Abdo-Pasha/MCT333_Design_of_Mechatronics_Systems_1/CAD/pnumatic_components/Pneumatic_Air_Cylinder_Double_Action/Pneumatic Air Cylinder Double Action.60.png

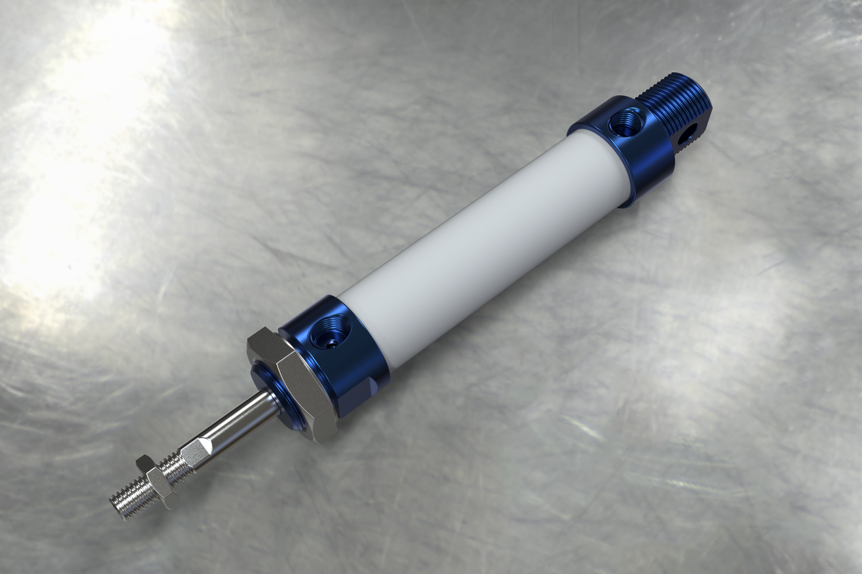
CAD/pnumatic_components/Pneumatic_Air_Cylinder_Double_Action/Pneumatic Air Cylinder Double Action.60.png
