Abdo-Pasha/MCT333_Design_of_Mechatronics_Systems_1/CAD/pnumatic_components/Pneumatic_Air_Cylinder_Double_Action/Read Me.txt

This 3D model shows a pneumatic cylinder of four different sizes.
The cylinder length can be customized by adjusting the stroke using equations in SolidWorks for the Cylinder Barrel and Piston Rod.
Detailed stroke lengths are available in the provided "Product Description" PDF.
