Abdo-Pasha/MCT333_Design_of_Mechatronics_Systems_1/CAD/motors_and_actuators/smakn-tb6600-stepper-motor-driver/Description.txt

SMAKN TB6600 Stepper Motor Driver

TB6600 Upgraded Version 32 Segments 4A 40V 57/86 Stepper Motor Driver

hhttps://www.aliexpress.us/item/3256805781393725.html

#CAD #SolidWorks #3dmodel #SMAKN #TB6600 #StepperMotorDriver
