Abdo-Pasha/MCT333_Design_of_Mechatronics_Systems_1/Actuator Sizing Reports/Suction Cup Actuator Sizing.pdf

# Suction Cup Actuator Sizing

The suction cup shown in the figure is used as an end effector for the cartesian robot. It is compatible with a Φ6 mm pneumatic tube and is utilized to lift the product's parts, which are made from Artelone and weigh approximately 32.52 grams (0.03252 kg).

## Suction Force Calculations (Fsuction)

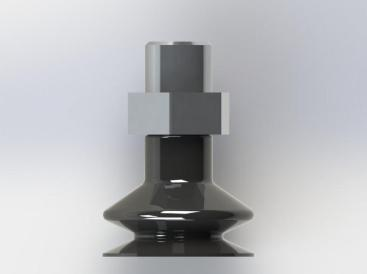
[picture p3: figure]

To calculate the required linear acceleration (a), we apply the motion relationship:

a =

L⋅θ̈

2π

and a = θ̈r

Given Parameters:

- Mass (m) = 32.52 g = 0.03252 kg
- Gravitational Acceleration (g) = 9.81 m/s²
- Weight (W = m ⋅ g) = 0.03252 kg × 9.81 m/s² = 0.31902 N
- Z-Axis Power Screw Lead (L) = 8 mm = 0.008 m
- Z-Axis Angular Acceleration (θ̈
z

) = 81.50 rad/s²

- Y-Axis Pulley’s Pitch Radius: r = 9.55 mm
- Y-Axis Angular Acceleration (θ̈

y) = 11.35 rad/s²

Linear Vertical Acceleration (az):

az =

0.008 m × 81.50 rad/s²
2π

=

0.652
2π

≈ 0.10377 m/s²

Vertical Acceleration Force (Faz
):

Faz = m ⋅ az = 0.03252 kg × 0.10377 m/s² ≈ 0.00337 N

Linear Horizontal Acceleration (ay):

ay = 11.35 rad/s² × 0.00955 m = 0.1084 m/s²

Horizontal Acceleration Force (Fay ):

Fay = m ⋅ ay = 0.03252 kg × 0.1084 m/s² ≈ 0.00353 N

### Case 1: Upward Movement

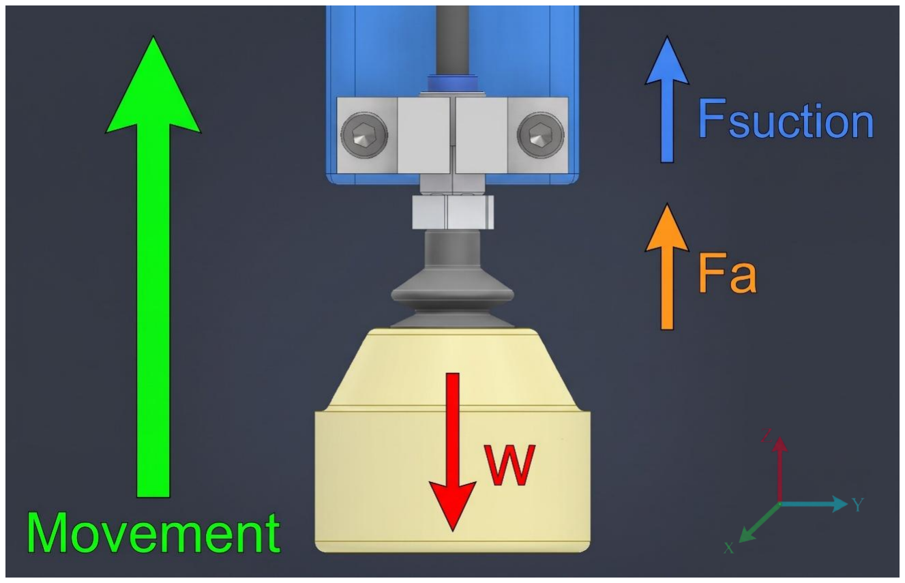
[picture p4: figure]

Equilibrium of Forces (ΣFy = 0):

Fsuction + Faz − W = 0

Moving terms to one side to establish the suction force requirement:

Fsuction > W − Faz

Calculation:

Fsuction > 0.31902 N + 0.00337 N

Fsuction > 0.31565 N

### Case 2: Downward Movement

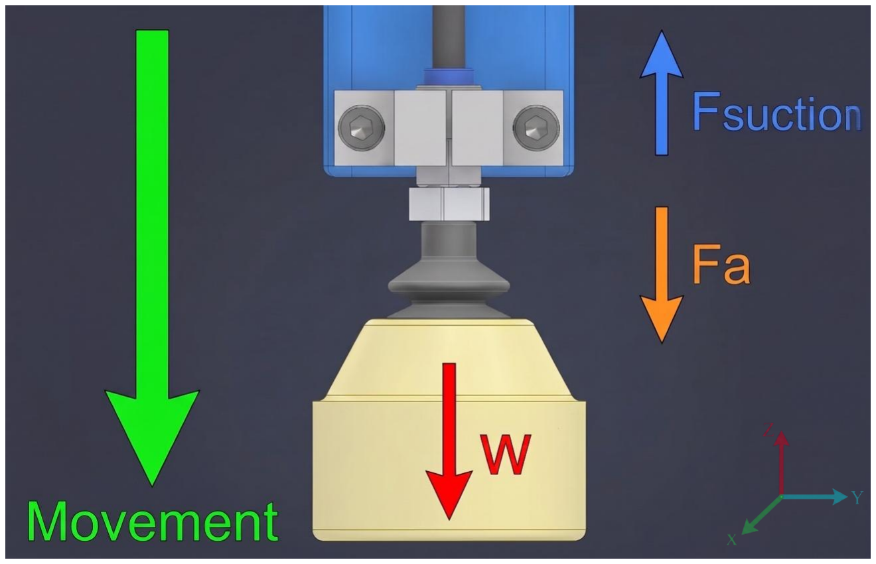
[picture p5: figure]

Equilibrium of Forces (ΣFz = 0):

Fsuction − Faz − W = 0

Moving terms to one side to establish the suction force requirement:

Fsuction > W + Faz

Calculation:

Fsuction > 0.31902 N + 0.00337 N

Fsuction > 0.32239 N

### Case 3: Sideway Movement

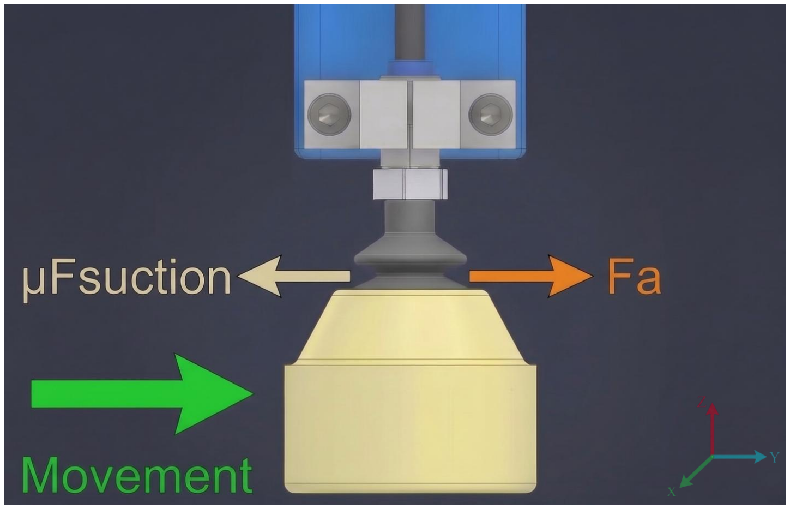
[picture p6: figure]

Equilibrium of Forces (ΣFy = 0):

Fay − μFsuction = 0

Moving terms to one side to establish the suction force requirement:

Fsuction >

Fay
μ

Calculation:

Fsuction >

0.00353
0.5

N

Fsuction > 0.00706 N

### Suction Force Sizing Criteria

To ensure secure part retention across all operational phases, the suction cup is sized based on the maximum calculated requirement, which occurs during downward movement (Case 2: Fsuction, min = 0.32239 N).

Applying a design safety factor of n = 2 to account for surface roughness, dynamic acceleration spikes and vacuum pressure fluctuations, the minimum required suction force is:

Fsuction, required = Fsuction, min × n = 0.32239 N × 2 = 0. 64478 N

### Pneumatic Vacuum System Sizing & Selection

1. Required Vacuum Pressure Calculation:
To achieve the required holding force (Fsuction = 0.645 N) using the suction tubing (Inner Diameter = 5 mm, cross-sectional area A = 19.64 mm²
), the required operating
vacuum pressure is calculated as:

Pvacuum =

Fsuction
A

=

0.64478 N
1.9635 × 10⁻⁵ m

2 = 32,838 Pa ≈ −0.328 bar (−32.84 kPa)

2. Vacuum Generator Selection & Verification:
To generate this vacuum pressure, a Vacuum Generator “VEV-06HS Venturi Vacuum Generator (1/8′′ Port)” is selected:
- Supply Pressure Range: 0.1 − 1.6 MPa (1.0 − 16.0 bar)
- Operating Supply Pressure: 5.0 − 8.0 bar (0.5 − 0.8 MPa)
- Max Vacuum Generated: −0.085 MPa (−0.85 bar)

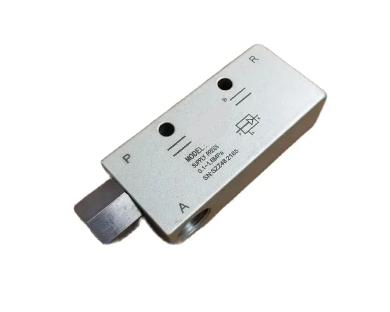
[picture p7: figure]

3. Verification & Safety Margin: Operating the compressed air line at 8.0 bar, the VEV-06HS generator easily delivers up to −0.85 bar of vacuum depth. Since the system only requires −0.328 bar, the generator operates with a 2.6 × pressure safety margin, guaranteeing rapid suction under different conditions.

Coefficient of Friction value reference: https://www.schmalz.com/en/support/know-how/vacuum-knowledge/the-vacuum-system-and-its-components/system-design-calculation-example/theoretical-holding-force-of-a-su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 (https://www.schmalz.com/en/support/know-how/vacuum-knowledge/the-vacuum-system-and-its-components/system-design-calculation-example/theoretical-holding-force-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)
