Abdo-Pasha/MCT333_Design_of_Mechatronics_Systems_1/Actuator Sizing Reports/Y-Axis Axtuator Sizing.pdf

# Y-Axis Actuator Sizing

The Y-axis of the Cartesian robotic arm is actuated by an encoder-equipped DC motor operating under closed-loop PID control, driving a timing belt and gantry cart mechanism. This setup translates the entire Z-axis assembly linearly along the Y-axis workspace, allowing the suction mechanism to reach and pick up target parts with high positional accuracy.

## Governing Formulas

### 1. Torque Equations

- Total Motor Torque:
Tm = Tr + Jeq ⋅ θ̈m
- Peak Required Motor Torque:

Tm,peak = max(Tm,acc, Tm,const, Tm,dec)

- RMS Torque (Trms):

Trms = √
Tm,acc
2 | ⋅ tacc + Tm,const
| 2
⋅ tconst +Tm,dec

2
⋅ tdec + Tm,dw

2
⋅ tdw
| tacc + tconst + tdec + tdw

### 2. Inertia Equations

- Load Rotary Inertia (Jload):

Jload =

mloadr

2
η
- Motor Rotary Inertia (Jmotor):
| Jmotor =

1
10 ⋅ Jload
- Equivalent System Inertia (Jeq):
| Jeq = Jload + Jmotor

### 3. Resisting Torque Equations

- Total Resisting Torque (Tr
):

Tr =

mloadr
η

### 4. Acceleration Equations

- Maximum Angular Velocity (ωmax):

vmax = ωmax ⋅ r

- Total Rotation, Area Under the Curve (θ):

θ =

1
2

taccωmax + ωmaxtconst +

1
2

tdecωmax

- Acceleration Phase (θ̈
acc):

θ̈
acc =

ωmax − 0

tacc

- Constant-Speed Phase (θ̈
const):

θ̈
const = 0
- Deceleration Phase (θ̈
dec):

θ̈
dec =

0 − ωmax

tdec

### 5. Additional Rules and Parameters

- Driver Pulley
- Number of Teeth T = 30
- Pitch P = 2 mm
- Pitch Radius (r):

r =

T × P
2π

=

30 × 2
2π

= 9.55 mm

To size the actuator correctly, the total mass moved along the Y-axis is determined first. Summing all translating parts in the Z-Axis Parts List gives a total mass of 1,363.87 g.

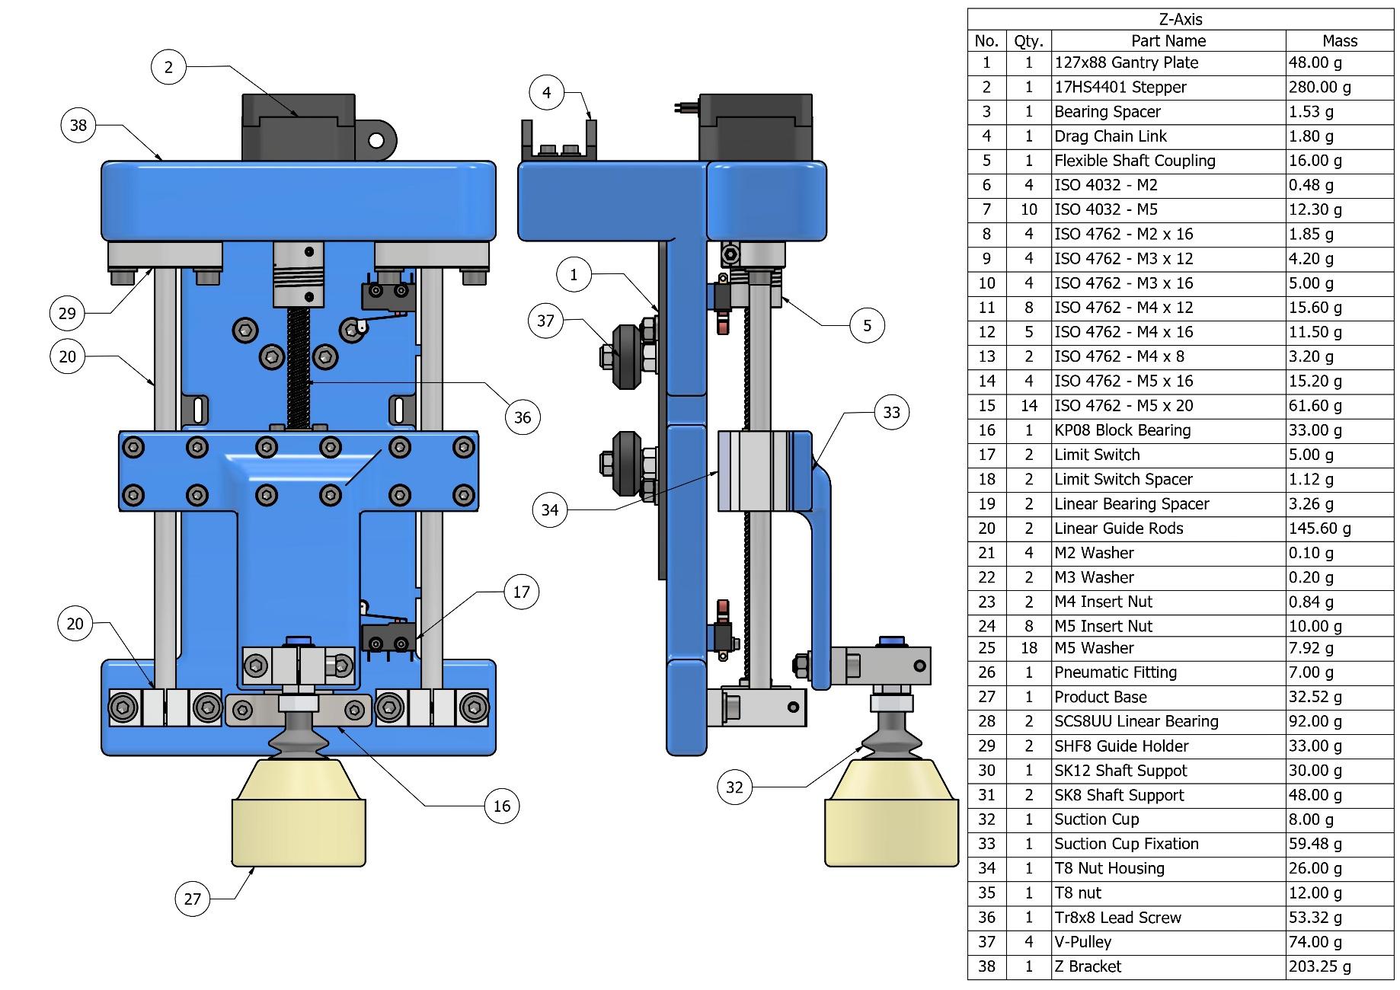
[picture p8: figure]

## 1. Inertia Calculation (Jeq)

Variables & Parameters:

- Load Mass: mload = 1,363.87 g = 1.36387 kg
- Mechanical Efficiency (assumed): η = 90% = 0.9
- Pitch Radius: r = 9.55 mm

Equations & Substitution:

- Load Rotary Inertia (Jload):

Jload =

mload ⋅ r

2
η

=

1.36387 ⋅ (0.00955)

2
0.9

= 1.3821 × 10⁻⁴ kg ⋅ m²

- Motor Inertia (Jmotor):

Jmotor =

1
10 ⋅ Jload = 0.1 × 1.3821 × 10⁻⁴ = 1.3821 × 10⁻⁵ kg ⋅ m²
- Equivalent System Inertia (Jeq):

Jeq = Jload + Jmotor = 1.3821 × 10⁻⁴ + 1.3821 × 10⁻⁵ = 1.5203 × 10⁻⁴ kg ⋅ m²

## 2. Resisting Torque Calculation (Tr

)

Variables & Parameters:

- Load Mass: mload = 1,363.87 g = 1.36387 kg
- Mechanical Efficiency (assumed): η = 90% = 0.9
- Pitch Radius: r = 9.55 mm

Torque Equations & Substitution:

- Total Resisting Torque (Tr ):

Tr =

mload ⋅ r
η

=

1.36387 ⋅ 0.00955
0.9

= 0.01447 N ⋅ m (14.47 mN ⋅ m)

## 3.Acceleration (θm

̈):

The stroke of the y axis is 310 mm and the desired maximum nut speed is 120 mm/s, so at constant speed the whole stroke would take about 2.58 s (310 ÷ 120). The acceleration and deceleration ramps of the velocity profile make the actual move a little longer, as calculated below.

Variables & Parameters:

- Stroke: S = 310 mm = 0.31 m
- Pitch Radius: r = 9.55 mm
- Maximum Linear Speed (desired): vmax = 120 mm/s = 0.120 m/s
- Phase Time Ratio (assumed, symmetric profile): tacc:tconst:tdec = 0.3: 0.4: 0.3 of the move time T
- Dwell Time (assumed): tdw = 0.2 s
- No gearbox ⟹ θm = θL

Equations & Substitution:

- Maximum Angular Velocity (ωmax):

ωmax =

vmax
r

=

0.120 m/s
0.00955 m

= 12.5654 rad/s ≈ 120.0 rpm

- Total Rotation for the 310 mm Stroke (θ):

θ =

S
r

=

0.310 m
0.00955 m

= 32.4607 rad ≈ 5.166 rev

- Phase Times, tacc:tconst:tdec = 0.3: 0.4: 0.3 of the total move time T:

θ =

1
2

(0.3T)ωmax + ωmax(0.4T) +

1
2

(0.3T)ωmax = 0.7 ⋅ ωmax ⋅ T

T =

θ
0.7 ⋅ ωmax

=

32.4607
0.7 ⋅ 12.5654 = 3.6903 s
- tacc = 0.3 × 3.6903 = 1. 1071 s
- tconst = 0.4 × 3.6903 = 1. 4761 s
- tdec = 0.3 × 3.6903 = 1. 1071 s
- Total Cycle Time (T + tdw) = 3.6903 + 0.2 = 3. 8903 s

- Acceleration Phase (θ̈
acc):

θ̈
acc =

ωmax − 0

tacc

=

12.5654
1.1071 = +11. 350 rad/s2

Constant-Speed Phase (θ̈
const):
θ̈
const = 0 rad/s²
- Deceleration Phase (θ̈
dec):

θ̈
dec =

0 − ωmax
tdec

= −11. 350 rad/s2

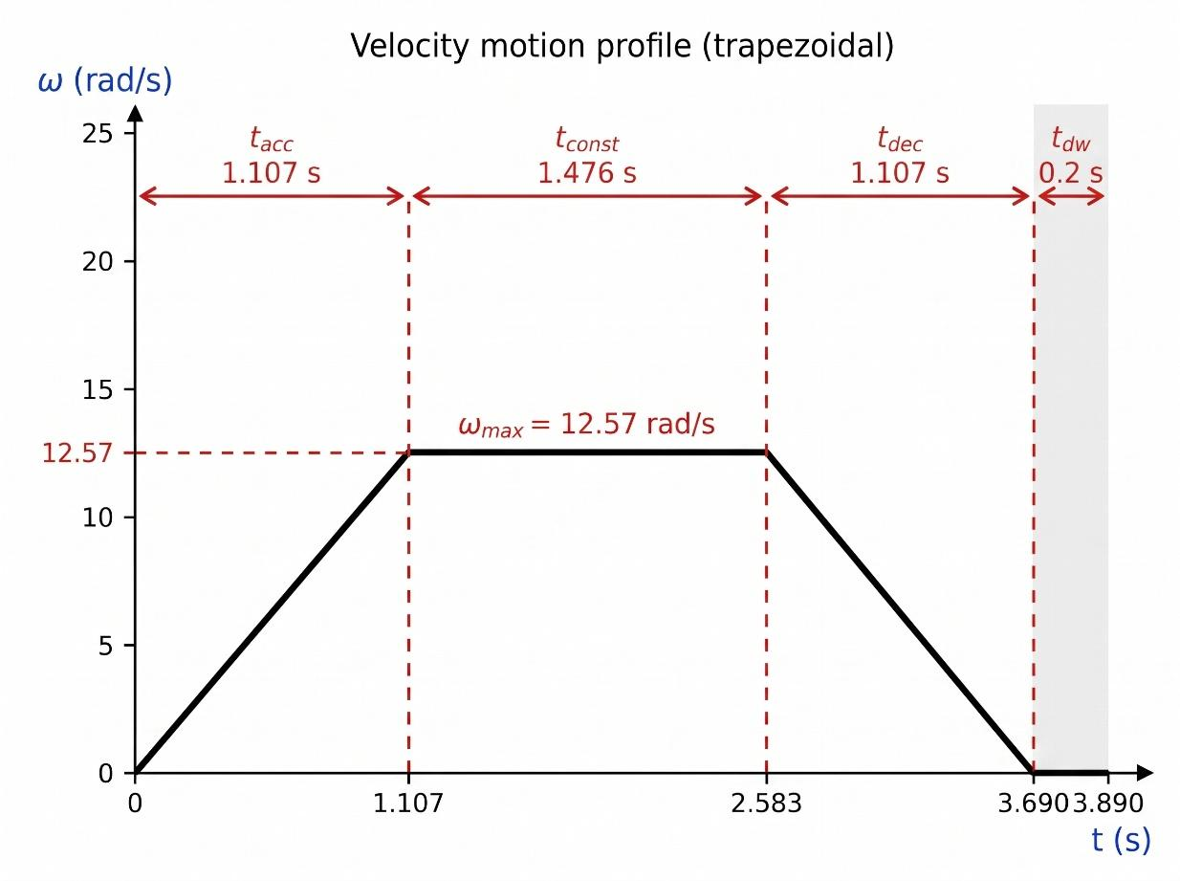
[picture p9: figure]

- Velocity Motion Profile (ω vs t):

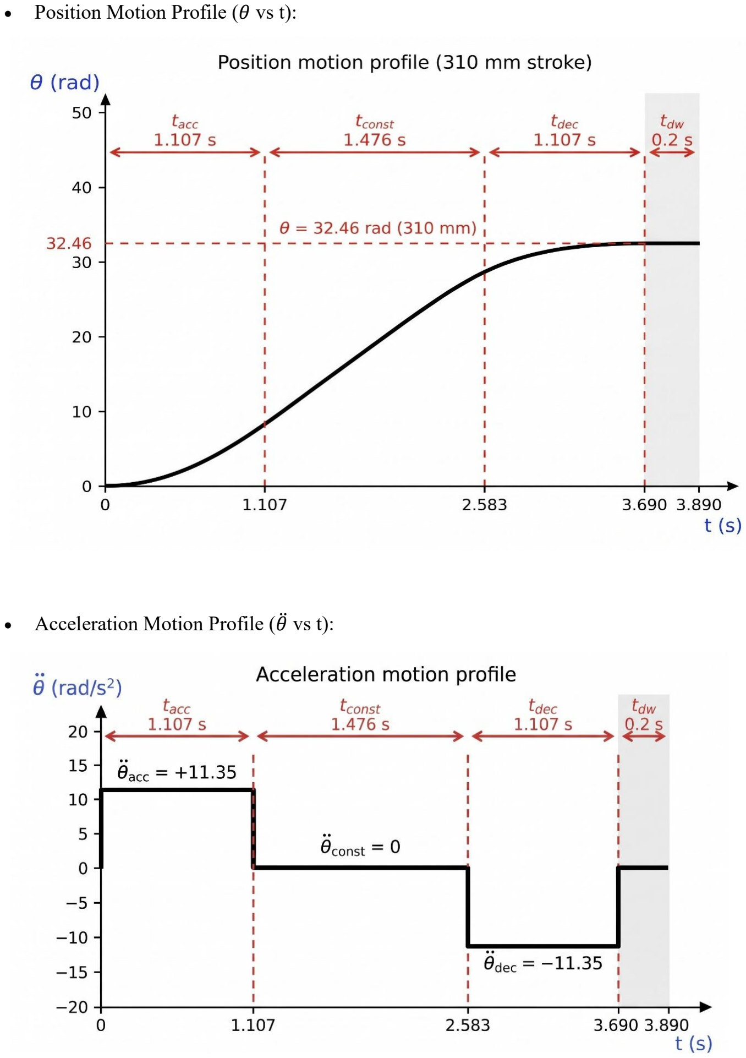
[picture p10: page 7]

- Position Motion Profile (θ vs t):
- Acceleration Motion Profile (θ̈vs t):

## 4. Motor Torque Calculations (Tm):

Variables & Parameters:

- Equivalent System Inertia: Jeq = 1.5203 × 10⁻⁴ kg ⋅ m²
- Total Resisting Torque: Tr = 0.01447 N ⋅ m
- Acceleration Phase Angular Acceleration: θ̈

acc = +11.350 rad/s²

- Constant-Speed Phase Angular Acceleration: θ̈

const = 0 rad/s²

- Deceleration Phase Angular Acceleration: θ̈

dec = −11.350 rad/s²

- Phase Times: tacc = 1.1071 s, tconst = 1.4761 s, tdec = 1.1071 s, tdw = 0.2 s

Torque Calculations & Substitution:

1. Acceleration Phase Motor Torque (Tm,acc):

Tm,acc = Tr + Jeq ⋅ θ̈
acc
Tm,acc = 0.01447 + (1.5203 × 10⁻⁴ ⋅ 11.350)

Tm,acc = 0.01447 + 0.001726 = 0.01620 N ⋅ m (16.20 mN ⋅ m)

2. Constant-Speed Phase Motor Torque (Tm,const):

Tm,const = Tr + Jeq ⋅ θ̈
const
Tm,const = 0.01447 + (1.5203 × 10⁻⁴
⋅ 0) = 0.01447 N ⋅ m (14.47 mN ⋅ m)
3. Deceleration Phase Motor Torque (Tm,dec):

Tm,dec = Tr + Jeq ⋅ θ̈
dec
Tm,dec = 0.01447 + (1.5203 × 10⁻⁴ ⋅ −11.350)

Tm,dec = 0.01447 − 0.001726 = 0.01274 N ⋅ m (12.74 mN ⋅ m)

4. Dwell Phase Motor Torque (Tm,dw):

Tm,dw = Tm,const=0.01447 N ⋅ m

Peak and RMS Torque Selection:

- Peak Motor Torque (Tm,peak):

Tm,peak = max(Tm,acc, Tm,const, Tm,dec)

Tm,peak = 0.01620 N ⋅ m (16.20 mN ⋅ m)

- Root Mean Square Torque (Trms):

Trms = √
Tm,acc

2 ⋅ tacc + Tm,const

2
⋅ tconst + Tm,dec

2
⋅ tdec + Tm,dw

2
⋅ tdw
tacc + tconst + tdec + tdw

Trms
= √
(0.01620)

2 ⋅ 1.1071 + (0.01447)

2 ⋅ 1.4761 + (0.01274)

2 ⋅ 1.1071 + (0.01447)

2 ⋅ 0.2
3.8903

Trms = √
0.0002905 + 0.0003091 + 0.0001797 + 0.00004188
3.8903 | = √
| 0.00082118
3.8903
= √0.00021108

Trms = 0.01453 N ⋅ m

## 5.Motor Selection & Verification with Safety Factor

- Safety Factor Application (n = 4):
Applying a design safety factor of n = 4 ensures extra margin for friction, damping and dynamic load spikes:

Treq, rms = Tm,rms × n = 0.01453 N ⋅ m × 4 = 0. 05812 N ⋅ m (0.5924 kg ⋅ cm)

- Selected DC Motor: GA25-370 DC Motor with Encoder 12V 250RPM

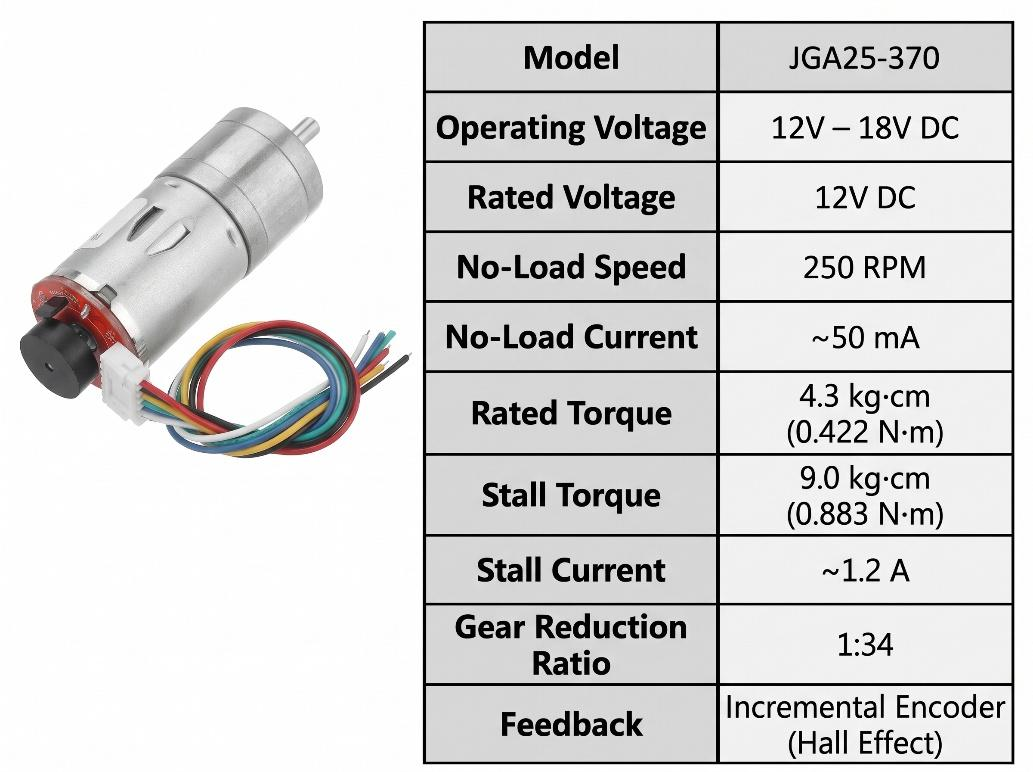
[picture p11: figure]

Suitability Justification: The selected JGA25-370 DC Motor easily handles the maximum dynamic load requirement during motion. Since the 20x20 Extrusion beam supports the full 1.36 kg weight, the motor only needs to overcome a small resisting torque of 0.0145 N ⋅ m.

In addition, the motor’s no-load speed is 250 RPM, while the maximum required speed is only 120 RPM, which leaves a comfortable speed margin (the motor runs at roughly 48% of its no-load speed). The motor is therefore suitable for this application.

Note: Even after updating the system inertia with the actual motor value, the recalculated peak required torque with a safety factor of n = 4 is only 0.0653 N ⋅ m (0.666 kg ⋅ cm). The motor's rated torque of 4.3 kg ⋅ cm (0.4217 N ⋅
m) is still nearly 6.5 × higher than this requirement, confirming that the JGA25-370 remains capable of driving the load with a safety margin.
