Abdo-Pasha/MCT333_Design_of_Mechatronics_Systems_1/Actuator Sizing Reports/Z-Axis Actuator Sizing Final.pdf

# Z-Axis Actuator Sizing

The Z axis of the Cartesian robotic arm is driven by a stepper motor and a power-screw (lead-screw) mechanism. It raises and lowers the suction cup so that it can reach and pick up the product parts easily.

The power screw is a Tr8x8 Acme (trapezoidal) screw, 173 mm long. In this designation the first 8 is the 8 mm outer diameter and the second 8 is the lead, L = 8 mm, since the thread has a pitch p = 2 mm with 4 starts (L = n × p = 4 × 2 mm). The lead L is used in the inertia, direct torque and lead-angle equations, while the pitch p is used only in the root diameter equation.

## Governing Formulas

### 1. Torque Equations

- Total Motor Torque:
Tm = Tr + Jeq ⋅ θ̈m
- Peak Required Motor Torque:

Tm,peak = max(Tm,acc, Tm,const, Tm,dec)

- RMS Torque (Trms):

Trms = √
Tm,acc
2 | ⋅ tacc + Tm,const
| 2
⋅ tconst +Tm,dec

2
⋅ tdec + Tm,dw

2
⋅ tdw
| tacc + tconst + tdec + tdw

### 2. Inertia Equations

- Load Rotary Inertia (Jload):

Jload =

mload

η ⋅ (

2π
L

)

2 +

1
2
- msc · r

2

- Motor Rotary Inertia (Jmotor):

Jmotor =

1
10 ⋅ Jload
- Equivalent System Inertia (Jeq):

Jeq = Jload + Jmotor

### 3. Resisting Torque Equations

- Total Resisting Torque (Tr
):

Tr =

Fload
η ⋅ (

2π
L

)

+ Tfriction

- Thread Friction Torque (Tfriction):

Tfriction = (

F ⋅ dm
2

) ⋅ (

tan(α)+ μ′
1− μ′ ⋅ tan(α)

)

- Friction Coefficient (μ′):

μ′ =

μ
cos(β)
- Screw Mean Diameter (dm), Root Diameter (droot) & Lead Angle (α):

dm =

douter + droot
2

+ 0.25

droot = douter − p −0.5

α = arctan (

L
π ⋅ dm

)

### 4. Acceleration Equations

- Maximum Angular Velocity (ωmax):

vmax = ωmax ⋅ (

L
2π

)

- Total Rotation, Area Under the Curve (θ):

θ =

1
2

taccωmax + ωmaxtconst +

1
2

tdecωmax

- Acceleration Phase (θ̈
acc):

θ̈
acc =

ωmax − 0

tacc

- Constant-Speed Phase (θ̈
const):

θ̈
const = 0
- Deceleration Phase (θ̈
dec):

θ̈
dec =

0 − ωmax

tdec

To size the actuator correctly, the total mass carried by the power screw is determined first. Summing all moving parts in the Z-axis bill of materials gives a total mass of 369.58 g.

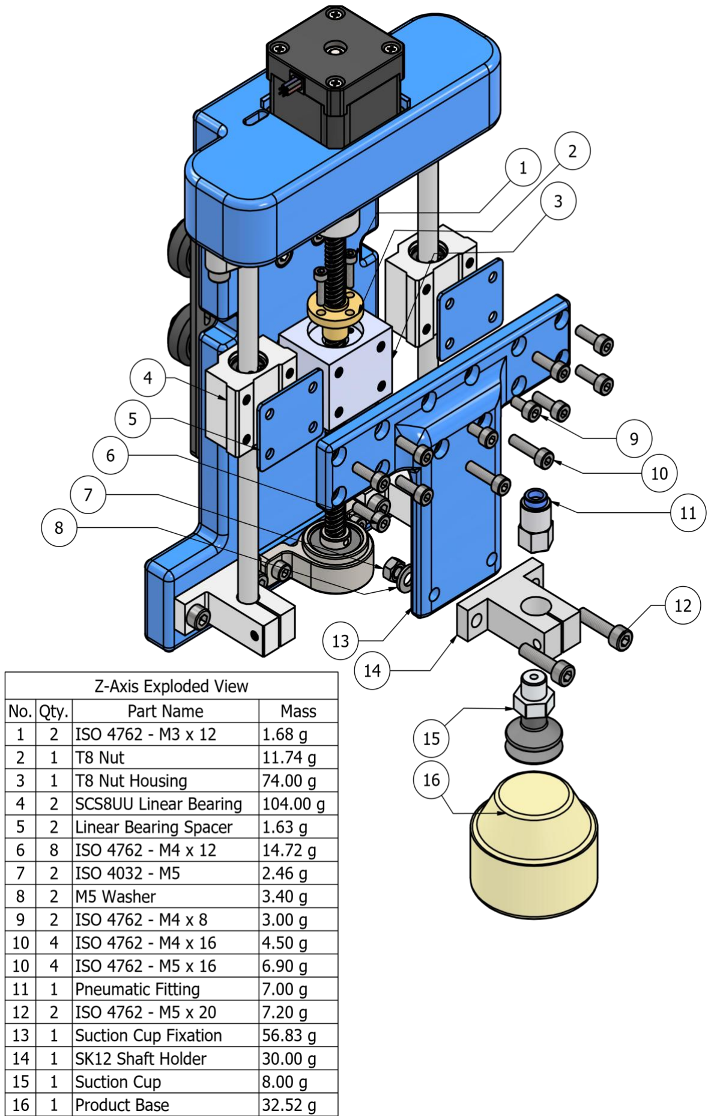
[picture p12: figure]

## 1. Inertia Calculation (Jeq)

Variables & Parameters:

- Load Mass: mload = 369.58 g = 0.36958 kg
- Mechanical Efficiency (assumed): η = 65% = 0.65
- Lead: L = 8 mm = 0.008 m
- Screw: Tr8x8, d = 8 mm ⟹ r = 0.004 m, ℓ = 0.173 m, ρ = 7850 kg/m³ (steel)

Equations & Substitution:

- Load Rotary Inertia (Jload):

Jload =

mload

η ⋅ (

2π
L

)

2

Jload =

0.36958 kg

0.65 ⋅ (

2π
0.008 m

)

2 =

0.36958
0.65 ⋅ (785.3982)

2 =

0.36958
400,952.68

Jload = 9.21755 × 10⁻⁷ kg ⋅ m²

- Lead Screw Inertia (Jscrew):

msc = ρ · π · r

2
- ℓ = 7850 · π · (0.004)

2
- 0.173 = 0.06826 kg

Jscrew =

1
2
- msc · r

2

Jscrew =

1
2
- 0.06826 kg · (0.004 m)

2 = 5.461 × 10⁻⁷ kg · m²

- Motor Inertia (Jmotor):

Jmotor =

1
10 ⋅ (Jload + Jscrew)

Jmotor =

1
10 ⋅ (9.21755 × 10⁻⁷ kg ⋅ m² + 5.461 × 10⁻⁷ kg ⋅ m²

) = 1.46786 × 10⁻⁷ kg ⋅ m²

- Equivalent System Inertia (Jeq):

Jeq = Jload + Jscrew + Jmotor

Jeq = 9.21755 × 10⁻⁷ kg ⋅ m² + 5.461 × 10⁻⁷ kg ⋅ m² + 1.46786 × 10⁻⁷ kg ⋅ m²

Jeq = 1.61464 × 10⁻⁶ kg ⋅ m²

## 2. Resisting Torque Calculation (Tr

)

Variables & Parameters:

- Gravitational Acceleration: g = 9.81 m/s²
- Vertical Load Force: Fload = W = mload ⋅ g = 0.36958 kg × 9.81 m/s² = 3.62558 N
- Outer Diameter: douter = 8 mm = 0.008 m
- Pitch: p = 2 mm = 0.002 m
- Lead: L = 8 mm = 0.008 m
- Thread Angle: β = 15∘
- Friction Coefficient (Brass Nut on Steel Screw): μ = 0.2
- Mechanical Efficiency (assumed): η = 0.65

Intermediate Geometry & Friction Calculations:

- Modified Friction Coefficient (μ′):

μ′ =

μ
cos(β)

=

0.2
cos(15∘)

=

0.2
0.96593 = 0.20706
- Root Diameter (droot):

droot = douter − p − 0.5 = 8 mm − 2 mm − 0.5 mm = 5.50 mm = 0.0055 m

- Mean Diameter (dm / dmean):

dm =

douter + droot
2

+ 0.25 =

8 + 5.50
2

+ 0.25 = 6.75 + 0.25 = 7.00 mm = 0.0070 m

- Lead Angle (α):

α = arctan (

L
π ⋅ dm

) = arctan (

0.008 m
π ⋅ 0.007 m

) = arctan(0.36378) = 19.9905∘

tan(α) = 0.36378

Torque Equations & Substitution:

- Thread Friction Torque (Tfriction):

Tfriction = (

F ⋅ dm
2

) ⋅ (
tan(α) + μ′
1 − μ′ ⋅ tan(α)

)

Tfriction = (

3.62558 N ⋅ 0.0070 m
2

) ⋅ (

0.36378 + 0.20706
1 − 0.20706 ⋅ 0.36378)

Tfriction = 0.0078337 N ⋅ m

- Direct Load Lifting Torque (Tdirect):

Tdirect =

Fload
η ⋅ (

2π
L

)

=

Fload ⋅ L
2π ⋅ η

Tdirect =

3.62558 N ⋅ 0.008 m
2π ⋅ 0.65 = 0.0071019 N ⋅ m
- Total Resisting Torque (Tr ):

Tr = Tdirect + Tfriction

Tr = 0.0071019 N ⋅ m + 0.0078337 N ⋅ m = 0.0149356 N ⋅ m

## 3.Acceleration (θm

̈):

The stroke of the Z axis is 95 mm and the desired maximum nut speed is 65 mm/s, so at constant speed the whole stroke would take about 1.46 s (95 ÷ 65). The acceleration and deceleration ramps of the velocity profile make the actual move a little longer, as calculated below.

Variables & Parameters:

- Stroke (Worst Case): S = 95 mm = 0.095 m
- Lead: L = n × p = 4 × 2 mm = 8 mm = 0.008 m
- Maximum Linear Speed (desired): vmax = 65 mm/s = 0.065 m/s
- Phase Time Ratio (assumed, symmetric profile): tacc:tconst:tdec = 0.3: 0.4: 0.3 of the move time T
- Dwell Time (assumed): tdw = 0.2 s
- No gearbox ⟹ θm = θL

Equations & Substitution:

- Maximum Angular Velocity (ωmax):

ωmax =

vmax
(

L
2π

)

ωmax =

0.065 m/s
(

0.008 m
2π

)

=

0.065
0.0012732 = 51.0509 rad/s ≈ 487.5 rpm
- Total Rotation for the 95 mm Stroke (θ):

θ =

S
(

L
2π

)

=

0.095 m
(

0.008 m
2π

)

=

0.095
0.0012732 = 74.6128 rad ≈ 11.875 rev

- Phase Times, tacc:tconst:tdec = 0.3: 0.4: 0.3 of the total move time T:

θ =

1
2

(0.3T)ωmax + ωmax(0.4T) +

1
2

(0.3T)ωmax = 0.7 ⋅ ωmax ⋅ T

T =

θ
0.7 ⋅ ωmax

=

74.6128
0.7 ⋅ 51.0509 =

74.6128
35.7356 = 2.0879 s

tacc = 0.3 ⋅ T = 0.3 ⋅ 2.0879 = 0.6264 s

tconst = 0.4 ⋅ T = 0.4 ⋅ 2.0879 = 0.8352 s

tdec = 0.3 ⋅ T = 0.3 ⋅ 2.0879 = 0.6264 s

Cycle time = T + tdw = 2.0879 + 0.2 = 2.2879 s

- Acceleration Phase (θ̈
acc):

θ̈
acc =

ωmax − 0

tacc

=

51.0509 − 0
0.6264 = 81.50 rad/s²
- Constant-Speed Phase (θ̈
const):
θ̈
const = 0 rad/s²
- Deceleration Phase (θ̈
dec):

θ̈
dec =

0 − ωmax
tdec

=

0 − 51.0509
0.6264 = −81.50 rad/s²

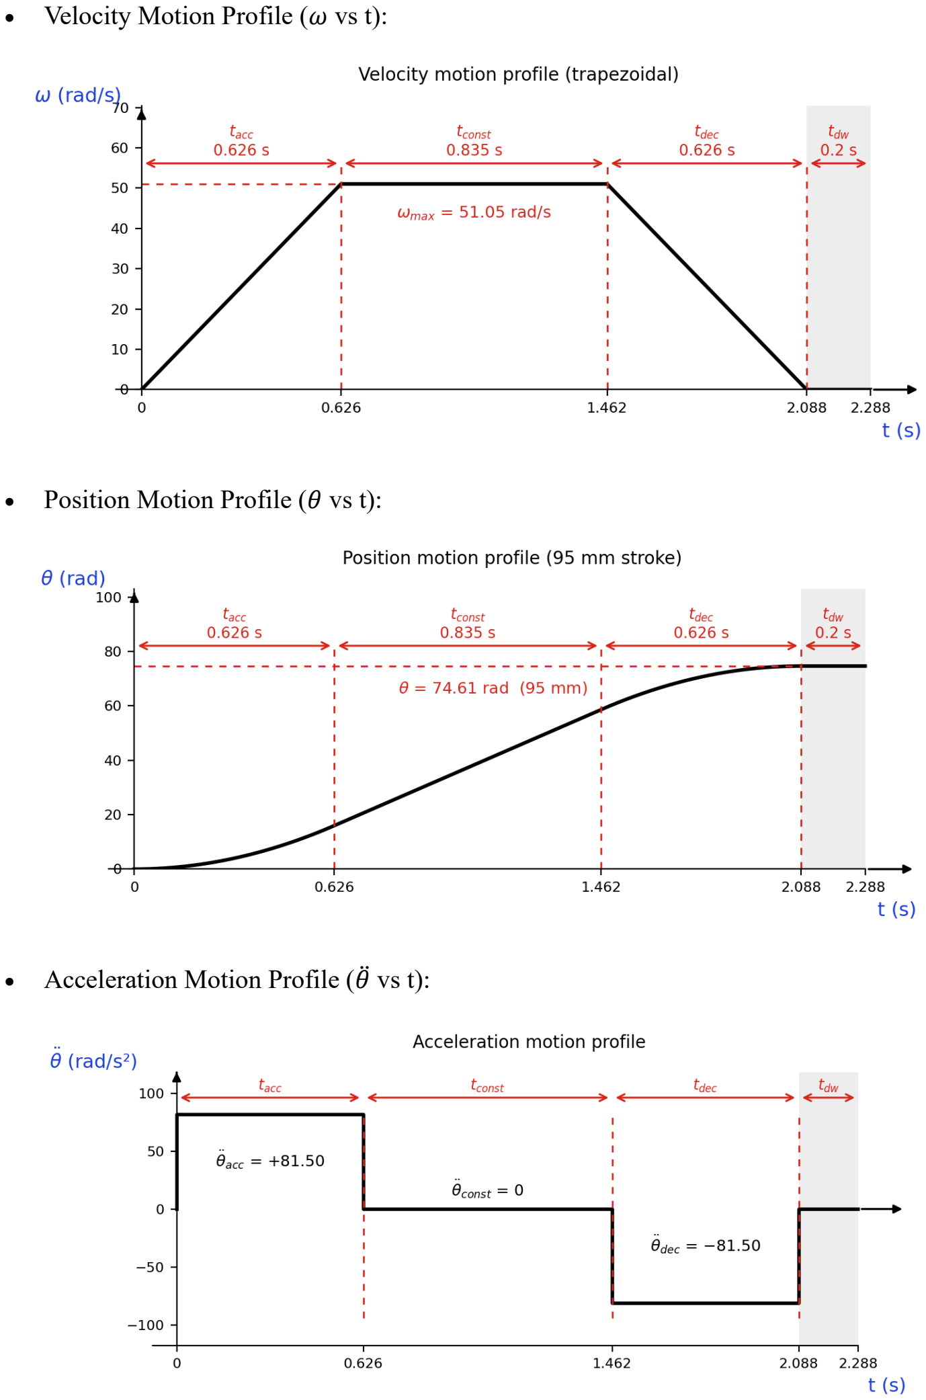
[picture p13: page 8]

- Velocity Motion Profile (ω vs t):
- Position Motion Profile (θ vs t):
- Acceleration Motion Profile (θ̈vs t):

## 4. Motor Torque Calculations (Tm)

Variables & Parameters:

- Equivalent System Inertia: Jeq = 1.61464 × 10⁻⁶ kg ⋅ m²
- Total Resisting Torque: Tr = 0.0149356 N ⋅ m
- Acceleration Phase Angular Acceleration: θ̈

acc = +81.50 rad/s²

- Constant-Speed Phase Angular Acceleration: θ̈

const = 0 rad/s²

- Deceleration Phase Angular Acceleration: θ̈

dec = −81.50 rad/s²

Torque Calculations & Substitution:

1. Acceleration Phase Motor Torque (Tm,acc):

Tm,acc = Tr + Jeq ⋅ θ̈
acc
Tm,acc = 0.0149356 N ⋅ m + (1.61464 × 10⁻⁶ kg ⋅ m² × 81.50 rad/s²
)

Tm,acc = 0.0149356 + 0.00013159 = 0.0150672 N ⋅ m

2. Constant-Speed Phase Motor Torque (Tm,const):

Tm,const = Tr + Jeq ⋅ θ̈
const
Tm,const = 0.0149356 N ⋅ m + (1.61464 × 10⁻⁶ kg ⋅ m² × 0 rad/s² ) = 0.0149356 N ⋅ m
3. Deceleration Phase Motor Torque (Tm,dec):

Tm,dec = Tr + Jeq ⋅ θ̈
dec
Tm,dec = 0.0149356 N ⋅ m + (1.61464 × 10⁻⁶ kg ⋅ m² × (−81.50 rad/s²

))

Tm,dec = 0.0149356 − 0.00013159 = 0.0148040 N ⋅ m

4. Dwell Phase Motor Torque (Tm,dw):

Tm,dw = Tm,const = 0.0149356 N ⋅ m

Peak and RMS Torque Selection:

- Peak Motor Torque (Tm,peak):

Tm,peak = max(Tm,acc, Tm,const, Tm,dec)

Tm,peak = max(0.0150672,0.0149356,0.0148040) = 0.0150672 N ⋅ m

- Root Mean Square Torque (Trms):

Trms = √
Tm,acc

2 ⋅ tacc + Tm,const

2
⋅ tconst + Tm,dec

2
⋅ tdec + Tm,dw

2
⋅ tdw

tacc + tconst + tdec + tdw

Trms
= √
(0.0150672)

2 ⋅ 0.6264 + (0.0149356)

2 ⋅ 0.8352 + (0.0148040)

2 ⋅ 0.6264 + (0.0149356)

2 ⋅ 0.20
2.288

Trms = √
0.00014220 + 0.00018631 + 0.00013728 + 0.00004461
2.288 | = 0.0149358 N ⋅ m

## 5. Motor Selection & Verification with Safety Factor:

- Safety Factor Application (n = 4):

Design RMS Torque (Treq,rms) = n ⋅ Tm,rms = 4 × 0.0149358 N ⋅ m
= 0.0597432 N ⋅ m (5.97 N ⋅ cm)
- Selected Stepper Motor: NEMA 17 (17HS4401)

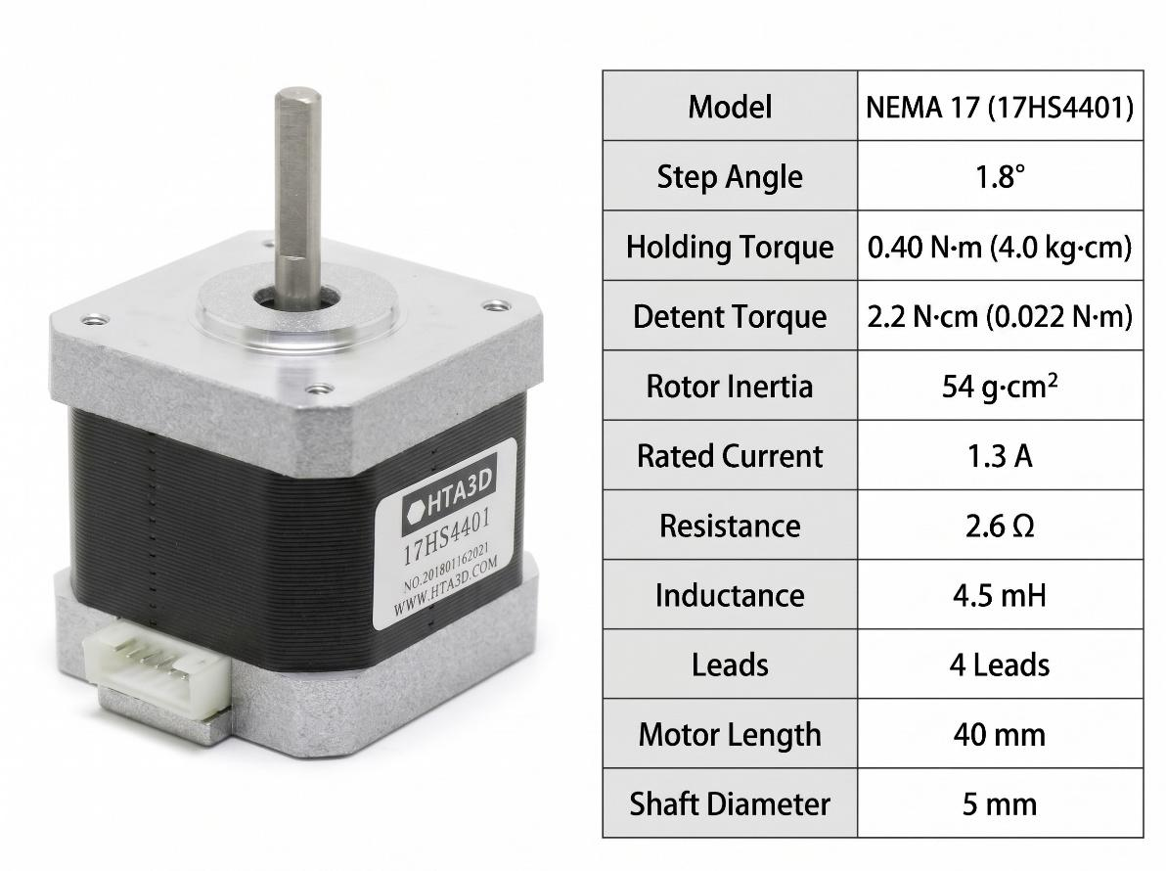
[picture p14: figure]

Suitability Justification: The selected NEMA 17 17HS4401 motor can easily handle the maximum dynamic load requirement during motion (5.97 N ⋅ cm RMS torque requirement). Furthermore, its unpowered detent torque of 2.20 N ⋅ cm exceeds the continuous static gravity load (1.49 N ⋅ cm), ensuring that the lead-screw nut will not slip or back-drive when the robot is powered off.

In addition, the selected motor can reach the required maximum speed of 51 rad/s (≈486 RPM), which corresponds to about 1,620 full steps/s for a 200 steps/rev motor. At this speed the motor’s pull-out torque stays above the 5.97 N·cm RMS requirement, with the driver supplied at 12 V.

Note: Even after updating the system inertia with the actual datasheet value of the motor (5.40 × 10⁻⁶ kg ⋅ m²
), the
recalculated peak torque with safety factor increases only slightly to 6.20 N ⋅ cm. The motor's rated holding torque of 40 N ⋅ cm is still nearly 6.5 × higher than this new requirement, confirming that the NEMA 17HS4401 remains capable of driving the required load with a safety margin.

Reference for the sizing equations: Industrial Monitor Direct, “Sizing Lead Screws and Ball Screws for Linear Actuation”. https://industrialmonitordirect.com/blogs/knowledgebase/sizing-lead-screws-and-ball-screws-for-linear-actuation (https://industrialmonitordirect.com/blogs/knowledgebase/sizing-lead-screws-and-ball-screws-for-linear-actuation)

Reference for the speed equations: Firgelli Automations, “Screw Lead, RPM, and Travel Calculator”. https://www.firgelliauto.com/blogs/engineering-calculators/screw-lead-rpm-and-travel-calculator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 (https://www.firgelliauto.com/blogs/engineering-calculators/screw-lead-rpm-and-travel-calculator%23related-resources)
