Abdo-Pasha/MCT333_Design_of_Mechatronics_Systems_1/CAD/DESIGN1_CAD_parameters.xlsx

Product_dia | 50 | mm
ProductBaseHeight | 40 | mm
ProductLedHeight | 20 | mm
GridProcutClearance | 3 | mm
GridBorderThickness | 5 | mm
GridBorderFillets | 7 | mm
GridTotalSize | 63 | mm
GridRobotClearance | 50 | mm
AluminiumExtrusionBase | 20 | mm
AluminiumExtrusionClearance | 30 | mm
BaseTotalWidth | 652 | mm
FeedingAreaLength | 400 | mm
BaseTotalLength | 912 | mm
DistanceBetweenGrid | 5 | mm
WorkspaceLength | 552 | mm
WorkspaceWidth | 417 | mm
WorkspaceHeight | 136.5 | mm
AxesBaseFillet | 15 | mm
Zaxis | 223 | mm
ProductTotalHeight | 45 | mm
VerticalClearance | 10 | mm
VerticalStroke | 85 | mm
FrontArea | 50 | mm
BackArea | 150 | mm
CylinderStroke | 75 | mm
SideAreaWidth | 200 | mm
BaseHeight | 70 | mm
BoxesClearance | 30 | mm
BoxesWidth | 140 | mm
PowerBoxLength | 630 | mm
PneumaticBoxLength | 200 | mm
ContolBoxLength | 100 | mm
DistanceBetweenBoxes | 30 | mm
BoxesHeight | 70 | mm
ContolBoxWidth | 200 | mm
ControlBoxHeight | 70 | mm
BaseWoodThickness | 7 | mm
Kerf | 0.3 | mm
TransmitterAreaWidth | 100 | mm
RxThickness | 1.8 | mm
