Abdo-Pasha/MCT333_Design_of_Mechatronics_Systems_1/CAD/cartesian_robot_workspace/DESIGN1_CAD_parameters.xlsx

Product_dia | 50 | mm
ProductBaseHeight | 40 | mm
ProductLedHeight | 20 | mm
GridProcutClearance | 3 | mm
GridBorderThickness | 5 | mm
GridBorderFillets | 7 | mm
GridTotalSize | 63 | mm
GridRobotClearance | 30 | mm
AluminiumExtrusionBase | 20 | mm
AluminiumExtrusionClearance | 30 | mm
BaseTotalWidth | 412 | mm
FeedingAreaLength | 200 | mm
BaseTotalLength | 624 | mm
DistanceBetweenGrid | 5 | mm
WorkspaceLength | 395 | mm
WorkspaceWidth | 332 | mm
WorkspaceHeight | 250 | mm
AxesBaseFillet | 15 | mm
Zaxis | 127 | mm
