Abdo-Pasha/MCT333_Design_of_Mechatronics_Systems_1/CAD/cartesian_robot_workspace/Z Axis/aluminum-flexible-shaft-coupling-5mm-x-8mm-1.snapshot.1/Flexible Shaft Coupling 5mm to 8mm/Snímek obrazovky 2018-11-16 v 16.25.01.png

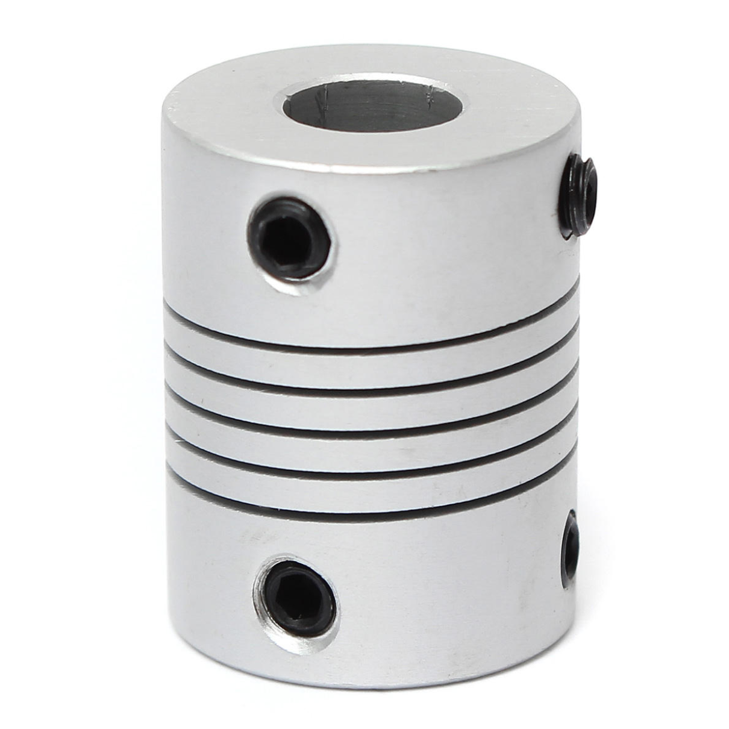
CAD/cartesian_robot_workspace/Z Axis/aluminum-flexible-shaft-coupling-5mm-x-8mm-1.snapshot.1/Flexible Shaft Coupling 5mm to 8mm/Snímek obrazovky 2018-11-16 v 16.25.01.png
