Abdo-Pasha/MCT333_Design_of_Mechatronics_Systems_1/CAD/cartesian_robot_workspace/Z Axis/AluminumExtrusion/AluminumExtrusion/AluminiumExtrusion2020/2020 Aluminum Profile 20x20x1000mm - Model SY2020.jpg

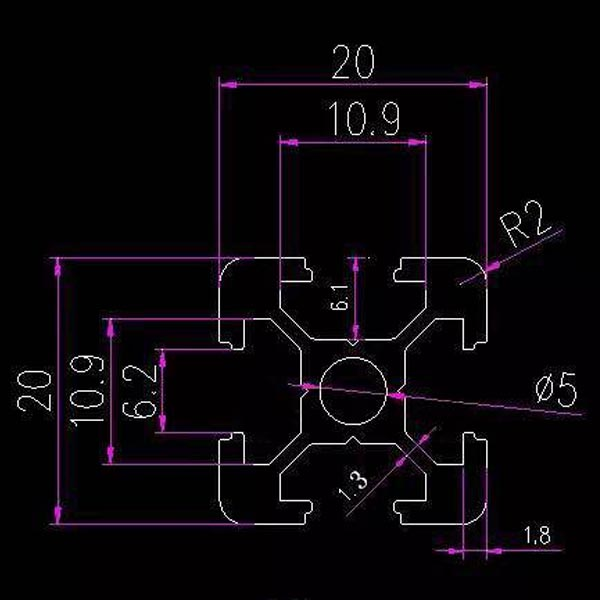
CAD/cartesian_robot_workspace/Z Axis/AluminumExtrusion/AluminumExtrusion/AluminiumExtrusion2020/2020 Aluminum Profile 20x20x1000mm - Model SY2020.jpg
