Abdo-Pasha/MCT333_Design_of_Mechatronics_Systems_1/CAD/cartesian_robot_workspace/Z Axis/AluminumExtrusion/AluminumExtrusion/Extrusion2040/render 2040.png

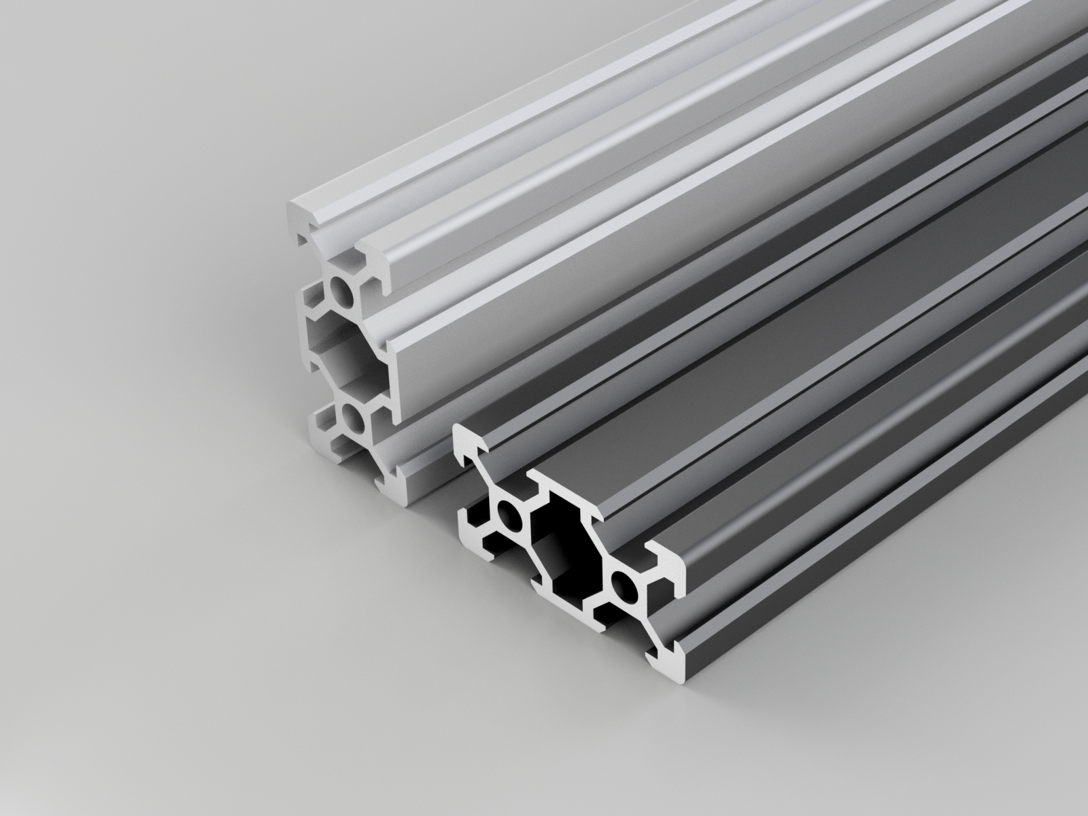
CAD/cartesian_robot_workspace/Z Axis/AluminumExtrusion/AluminumExtrusion/Extrusion2040/render 2040.png
