Abdo-Pasha/MCT333_Design_of_Mechatronics_Systems_1/CAD/cartesian_robot_workspace/Z Axis/m4x8-1-threaded-insert-1.snapshot.2/M4 Gewindeeinsatz v2.png

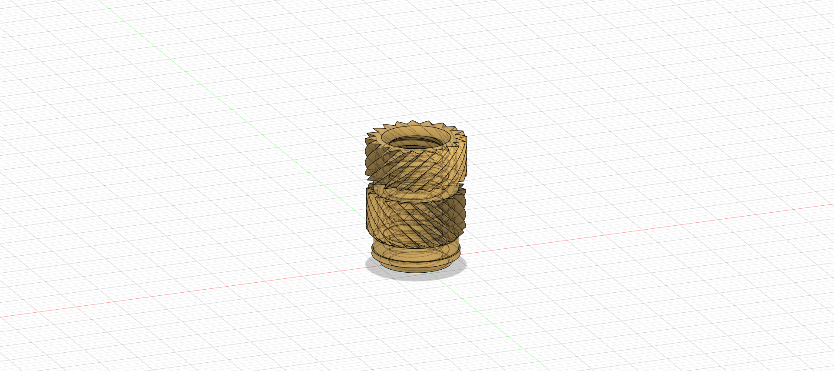
CAD/cartesian_robot_workspace/Z Axis/m4x8-1-threaded-insert-1.snapshot.2/M4 Gewindeeinsatz v2.png
