Abdo-Pasha/MCT333_Design_of_Mechatronics_Systems_1/CAD/cartesian_robot_workspace/Z Axis/m4x8-1-threaded-insert-1.snapshot.2/Renderings/M4 Gewindeeinsatz v1.png

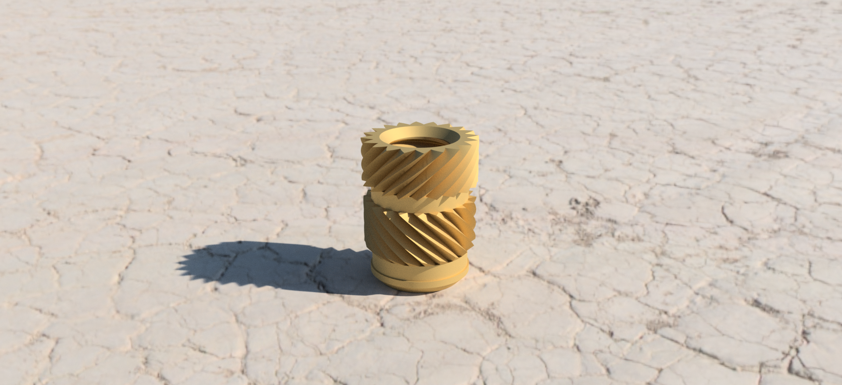
CAD/cartesian_robot_workspace/Z Axis/m4x8-1-threaded-insert-1.snapshot.2/Renderings/M4 Gewindeeinsatz v1.png
