Abdo-Pasha/MCT333_Design_of_Mechatronics_Systems_1/CAD/motors_and_actuators/nema17_stepper_motor/NEMA17.JPG

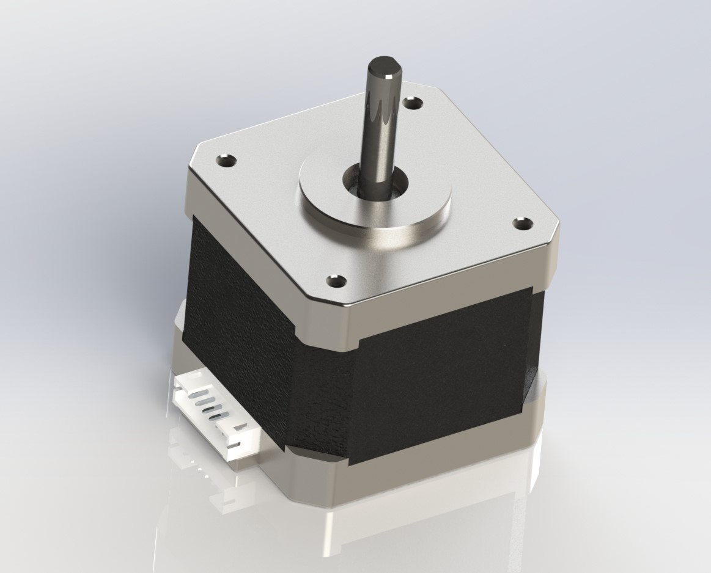
CAD/motors_and_actuators/nema17_stepper_motor/NEMA17.JPG
