Abdo-Pasha/MCT333_Design_of_Mechatronics_Systems_1/data_sheets/LaserModule.jpeg

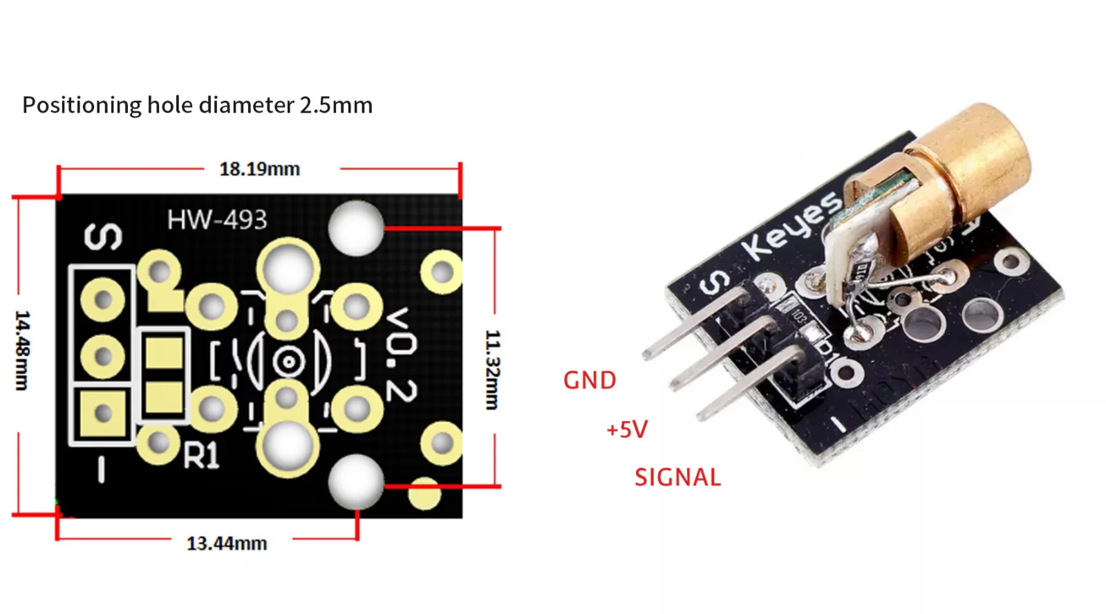
data_sheets/LaserModule.jpeg
