Abdo-Pasha/MCT333_Design_of_Mechatronics_Systems_1/CAD/electronic_components/18mm-inductive-proximity-sensor-taiss-4/5v_18mm_2020-Oct-24_02-03-55AM-000_CustomizedView2109189506_png.png

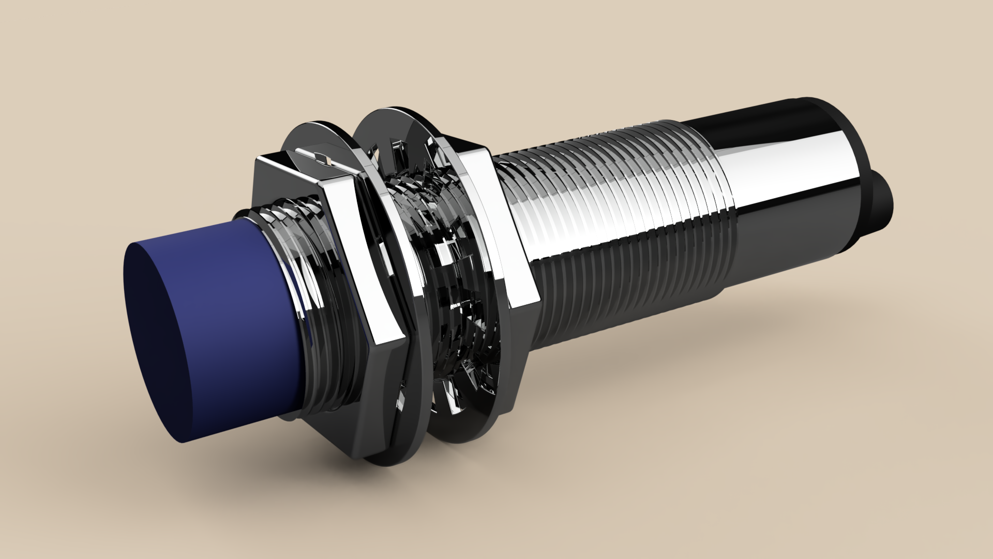
CAD/electronic_components/18mm-inductive-proximity-sensor-taiss-4/5v_18mm_2020-Oct-24_02-03-55AM-000_CustomizedView2109189506_png.png
