Abdo-Pasha/MCT333_Design_of_Mechatronics_Systems_1/CAD/electronic_components/power-supply-300-to-360w/360W Supply.png

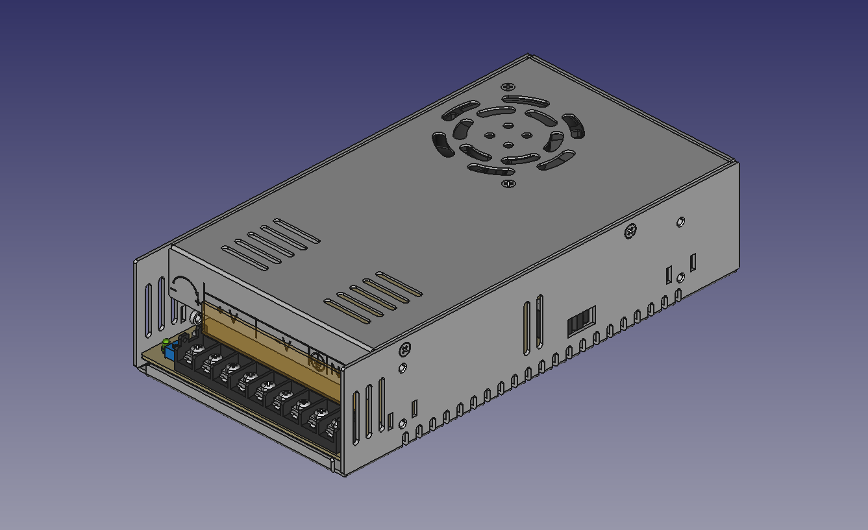
CAD/electronic_components/power-supply-300-to-360w/360W Supply.png
