Abdo-Pasha/MCT333_Design_of_Mechatronics_Systems_1/CAD/off_the_shelf_components/18mm-inductive-proximity-sensor-taiss-4/5v_18mm_2020-Oct-24_02-04-28AM-000_CustomizedView17442585055_png.png

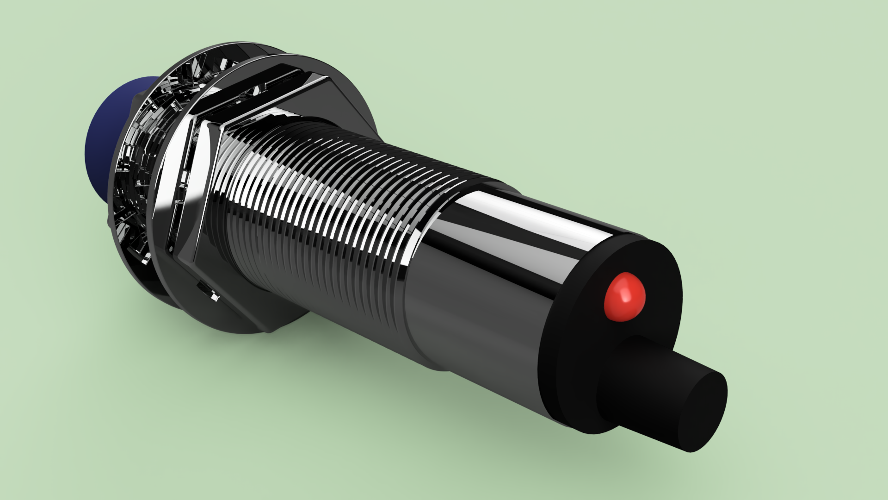
CAD/off_the_shelf_components/18mm-inductive-proximity-sensor-taiss-4/5v_18mm_2020-Oct-24_02-04-28AM-000_CustomizedView17442585055_png.png
