Abdo-Pasha/MCT333_Design_of_Mechatronics_Systems_1/CAD/off_the_shelf_components/aluminum_flexible_shaft_coupling_5mm_x_8mm/Flexible Shaft Coupling 5mm to 8mm/Snímek obrazovky 2018-11-16 v 16.22.32.png

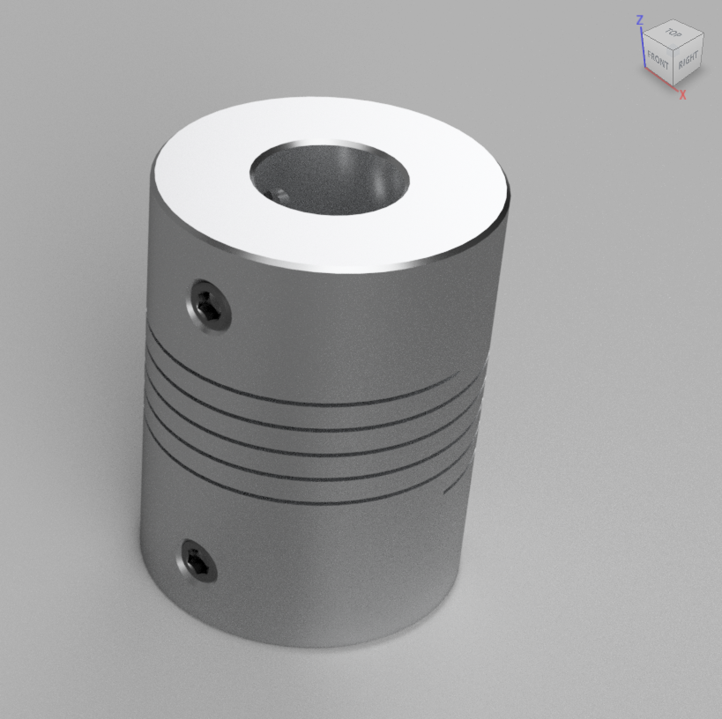
CAD/off_the_shelf_components/aluminum_flexible_shaft_coupling_5mm_x_8mm/Flexible Shaft Coupling 5mm to 8mm/Snímek obrazovky 2018-11-16 v 16.22.32.png
