Abdo-Pasha/MCT333_Design_of_Mechatronics_Systems_1/CAD/off_the_shelf_components/CornerBracket2020/Dimensions.webp

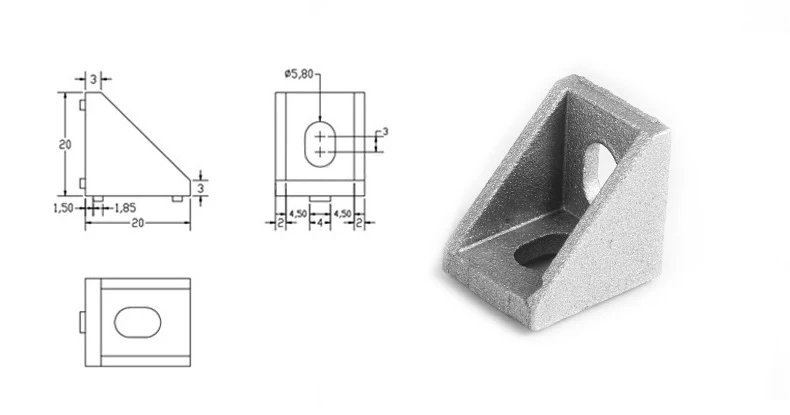
CAD/off_the_shelf_components/CornerBracket2020/Dimensions.webp
