Abdo-Pasha/MCT333_Design_of_Mechatronics_Systems_1/CAD/off_the_shelf_components/flanged_inserts/flanged inserts (2).jpg

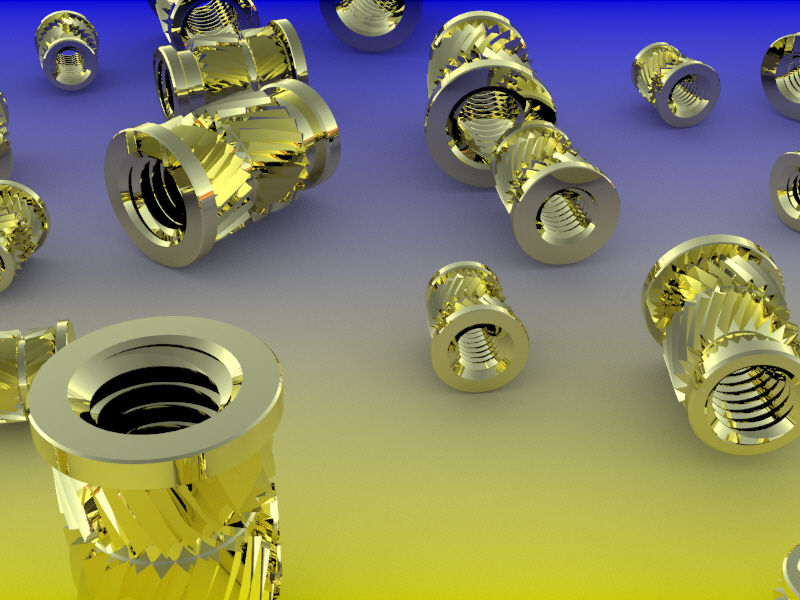
CAD/off_the_shelf_components/flanged_inserts/flanged inserts (2).jpg
