Abdo-Pasha/MCT333_Design_of_Mechatronics_Systems_1/CAD/off_the_shelf_components/nema_17_bracket/untitled.334.jpg

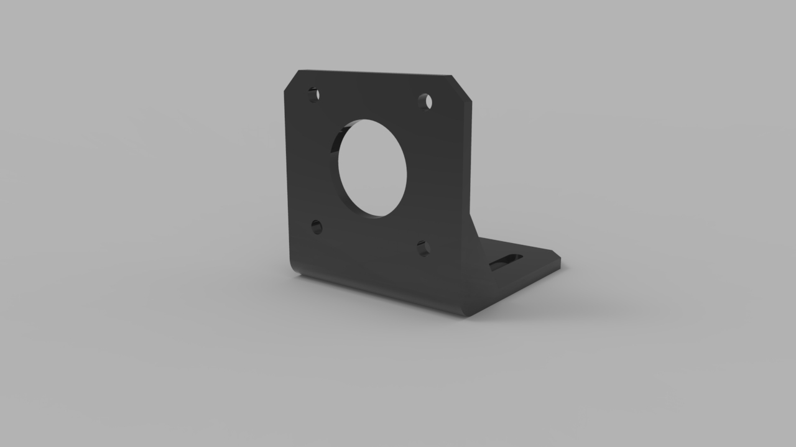
CAD/off_the_shelf_components/nema_17_bracket/untitled.334.jpg
