Abdo-Pasha/MCT333_Design_of_Mechatronics_Systems_1/CAD/off_the_shelf_components/standard-servo-motor-black-1.snapshot.7/1.PNG

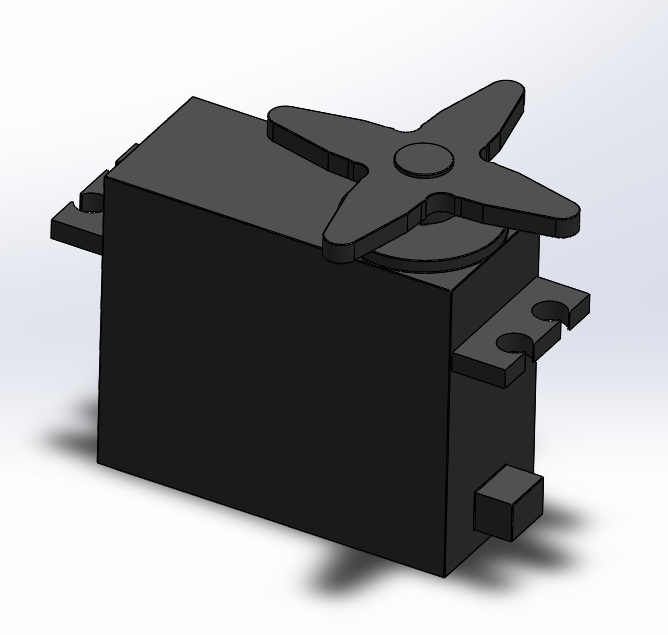
CAD/off_the_shelf_components/standard-servo-motor-black-1.snapshot.7/1.PNG
