Abdo-Pasha/MCT333_Design_of_Mechatronics_Systems_1/CAD/off_the_shelf_components/standard-servo-motor-black-1.snapshot.7/2.PNG

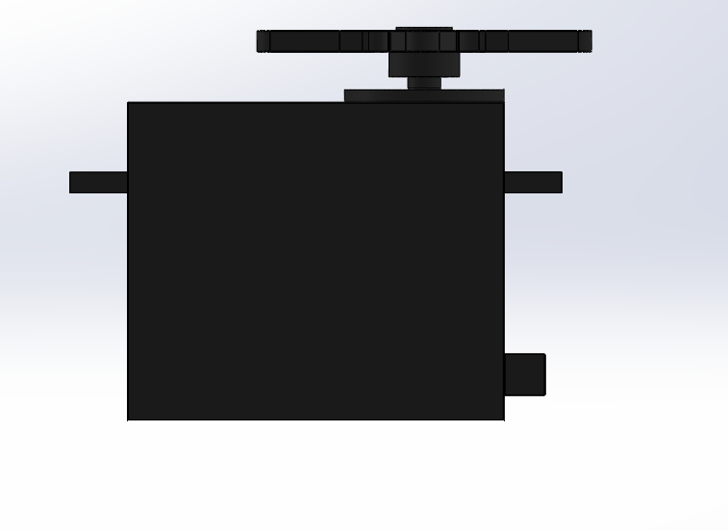
CAD/off_the_shelf_components/standard-servo-motor-black-1.snapshot.7/2.PNG
