Abdo-Pasha/MCT333_Design_of_Mechatronics_Systems_1/CAD/off_the_shelf_components/VSoltGantrySetAllSizes/solid-v-wheel-kit-b-size/SVWB.png

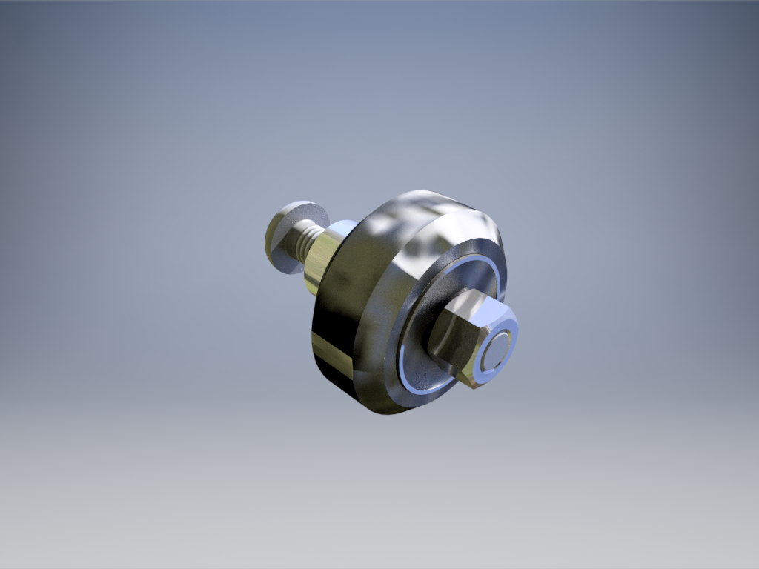
CAD/off_the_shelf_components/VSoltGantrySetAllSizes/solid-v-wheel-kit-b-size/SVWB.png
