Abdo-Pasha/MCT333_Design_of_Mechatronics_Systems_1/CAD/pnumatic_components/pneumatic_cylinder_double_action_mal16x75/renderImage.png

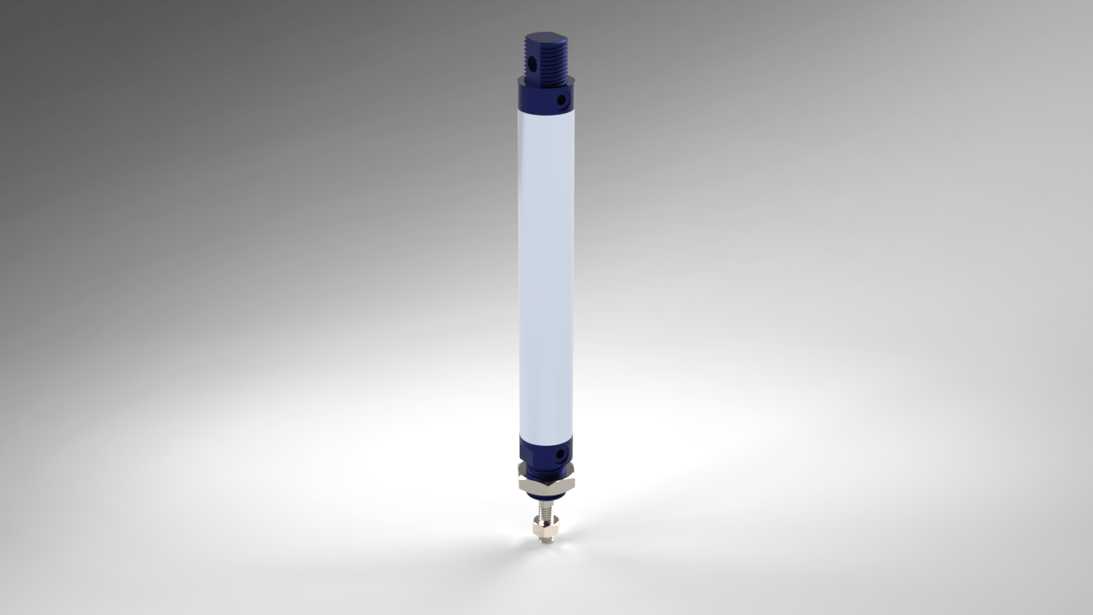
CAD/pnumatic_components/pneumatic_cylinder_double_action_mal16x75/renderImage.png
