Abdo-Pasha/MCT333_Design_of_Mechatronics_Systems_1/CAD/pnumatic_components/pneumatic_flow_control_valve/3.15.jpg

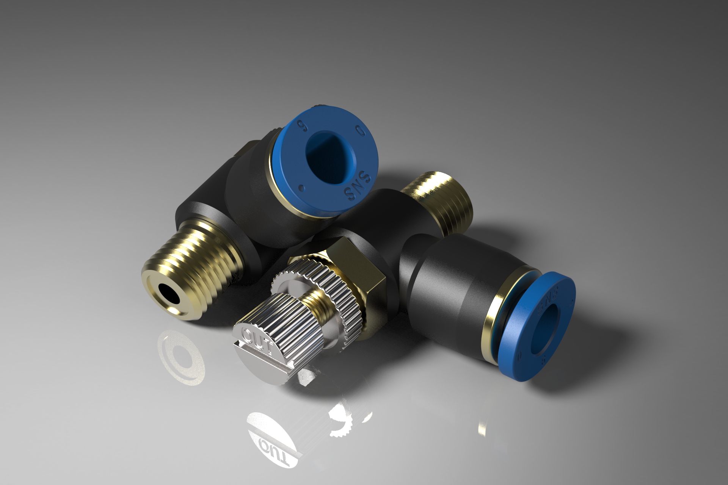
CAD/pnumatic_components/pneumatic_flow_control_valve/3.15.jpg
