Abdo-Pasha/MCT333_Design_of_Mechatronics_Systems_1/CAD/cartesian_robot_workspace/Z Axis/Suction.SLDASM

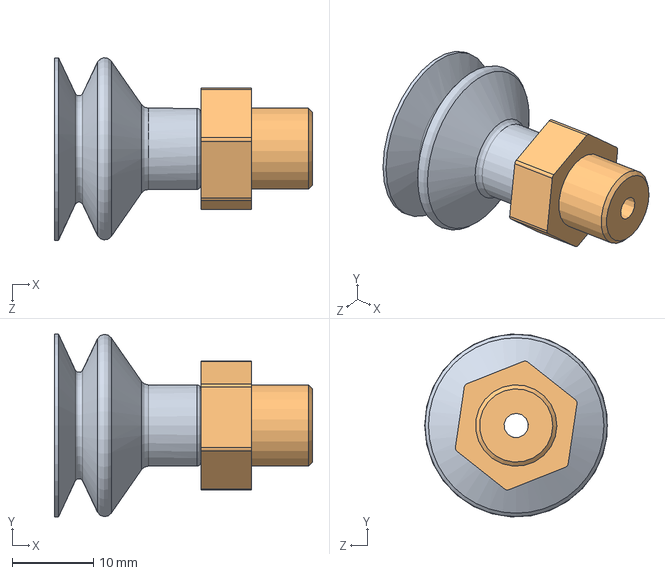
[picture p36: CAD file, 2026-10-13]
CAD/cartesian_robot_workspace/Z Axis/Suction.SLDASM
31.7 x 22.5 x 22.5 mm
Suction-ohne-nippel
nippel
