Abdo-Pasha/MCT333_Design_of_Mechatronics_Systems_1/CAD/electronic_components/18mm-inductive-proximity-sensor-taiss-4/Inductive Proximity Sensor Assembly.step

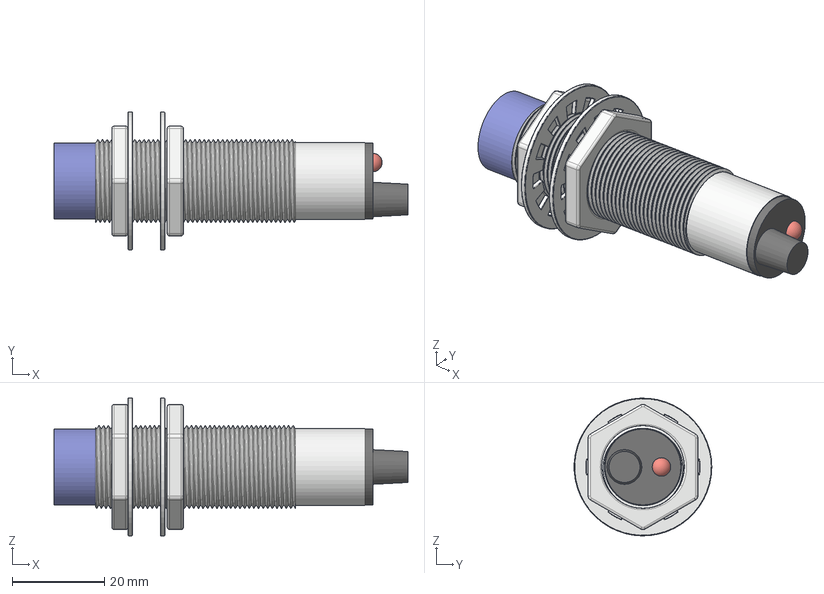
[picture p37: CAD file, 2026-10-10]
CAD/electronic_components/18mm-inductive-proximity-sensor-taiss-4/Inductive Proximity Sensor Assembly.step
76.6 x 29.8 x 29.8 mm
Sensor
Nut x 2
Lock Washer x 2
