Abdo-Pasha/MCT333_Design_of_Mechatronics_Systems_1/CAD/motors_and_actuators/smakn-tb6600-stepper-motor-driver/SMAKN TB6600 Stepper Motor Driver.SLDASM

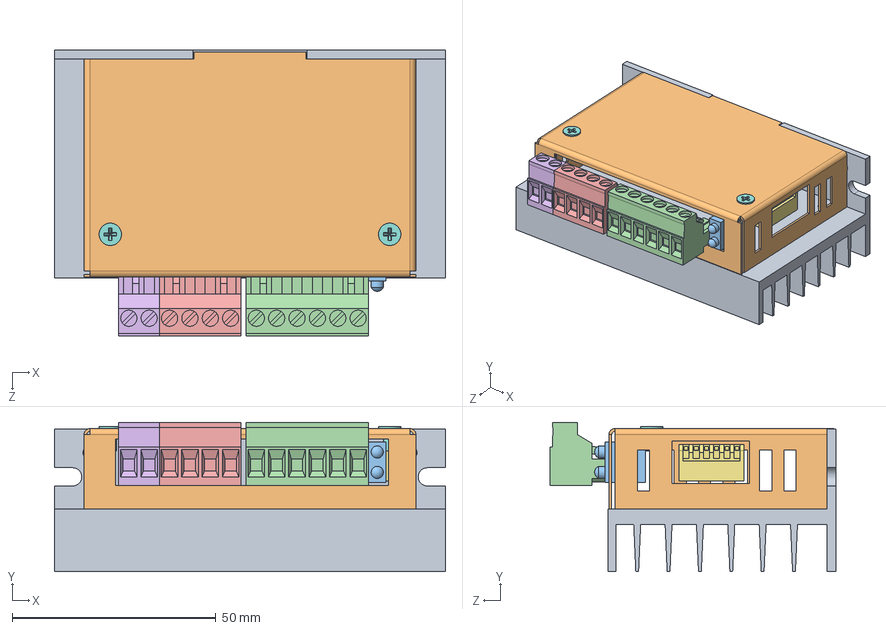
[picture p38: CAD file, 2026-10-21]
CAD/motors_and_actuators/smakn-tb6600-stepper-motor-driver/SMAKN TB6600 Stepper Motor Driver.SLDASM
96.0 x 36.6 x 70.3 mm
HEATSINK STYLE MOUNTING PLATE, SMAKN TB6600 STEPPER MOTOR DRIVER
SHEET METAL ENCLOSURE, SMAKN TB6600 STEPPER MOTOR DRIVER
LED BODY, SMAKN TB6600 STEPPER MOTOR DRIVER
EUROSTYLE TERMINAL BLOCK 6 POS 5.0 MM RA PLUG, SMAKN TB6600 STEPPER MOTOR DRIVER
EUROSTYLE TERMINAL BLOCK 4 POS 5.0 MM RA PLUG, SMAKN TB6600 STEPPER MOTOR DRIVER
EUROSTYLE TERMINAL BLOCK 2 POS 5.0 MM RA PLUG, SMAKN TB6600 STEPPER MOTOR DRIVER
DIP SWITCH, SMAKN TB6600 STEPPER MOTOR DRIVER
flat head screw_am x 2
