Abdo-Pasha/MCT333_Design_of_Mechatronics_Systems_1/CAD/cartesian_robot_workspace/cable-chain-18x37/J15BF.1.18. Chain.SLDASM

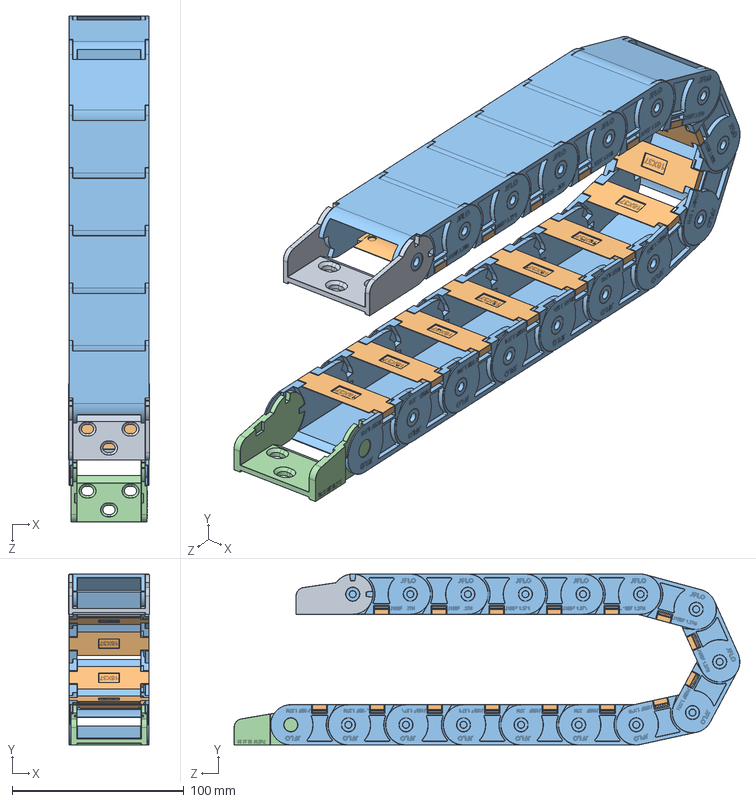
[picture p39: CAD file, 2026-10-21]
CAD/cartesian_robot_workspace/cable-chain-18x37/J15BF.1.18. Chain.SLDASM
47.0 x 99.5 x 294.3 mm
J15BF.1.18.2PZ
J18BF.1.Link x 15
J18BF.1. Close x 15
J15BF.1.18.1PZ
