Abdo-Pasha/MCT333_Design_of_Mechatronics_Systems_1/CAD/motors_and_actuators/l298n-DC-motor-driver-red/L298N Stepper Motor Driver (Red)-Assembly File.STEP

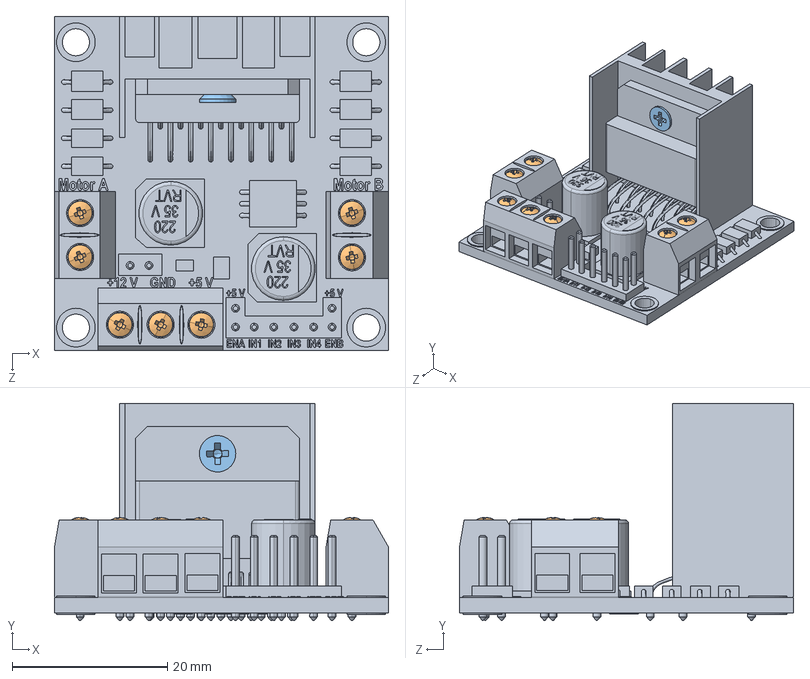
[picture p40: CAD file, 2026-10-21]
CAD/motors_and_actuators/l298n-DC-motor-driver-red/L298N Stepper Motor Driver (Red)-Assembly File.STEP
43.0 x 28.0 x 43.0 mm
L298N Stepper Motor Driver (Red)
pan head cross recess screw_iso_ISO 7045 - M1.6 x 4 - Z - 4N x 7
countersunk flat head cross recess screw_iso_ISO 7046-1 - M2.5 x 3 - Z - 3N
