Abdo-Pasha/MCT333_Design_of_Mechatronics_Systems_1/CAD/cartesian_robot_workspace/cable-chain-18x37/J15BF.1.18. Closed Link.SLDASM

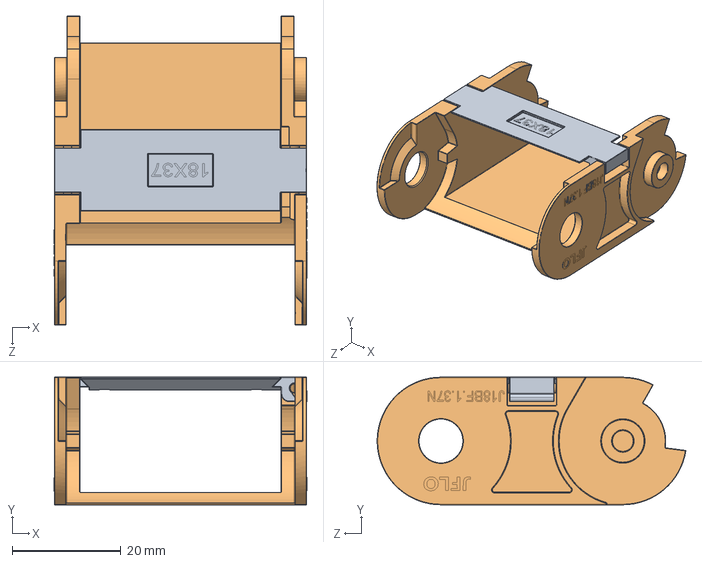
[picture p41: CAD file, 2026-10-21]
CAD/cartesian_robot_workspace/cable-chain-18x37/J15BF.1.18. Closed Link.SLDASM
46.6 x 23.5 x 56.9 mm
J18BF.1.Link
J18BF.1. Close
