Abdo-Pasha/MCT333_Design_of_Mechatronics_Systems_1/CAD/off_the_shelf_components/standard-servo-motor-black-1.snapshot.7/Assem1.SLDASM

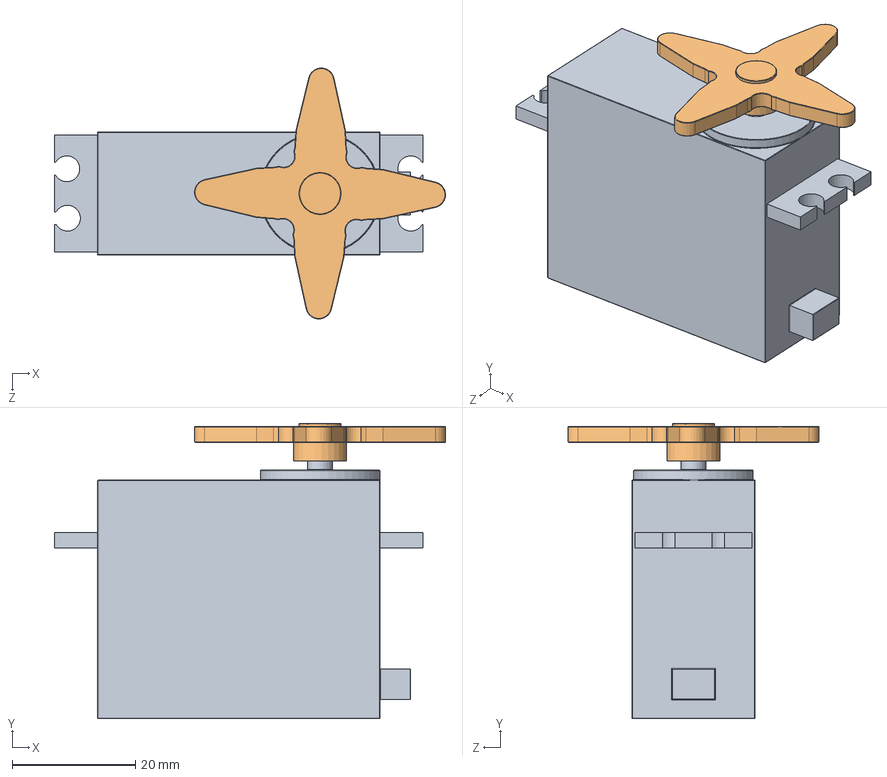
[picture p42: CAD file, 2026-10-10]
CAD/off_the_shelf_components/standard-servo-motor-black-1.snapshot.7/Assem1.SLDASM
63.4 x 47.9 x 40.7 mm
τοπ
