Abdo-Pasha/MCT333_Design_of_Mechatronics_Systems_1/simscape_multibody_simulation/simulation/FullAssembly_Default_sldprt.STEP

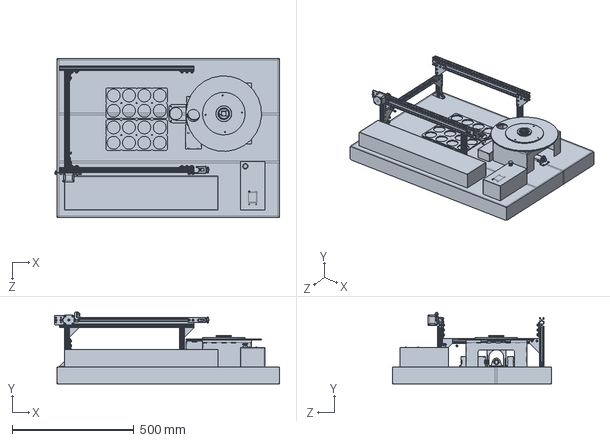
[picture p43: CAD file, 2026-10-25]
simscape_multibody_simulation/simulation/FullAssembly_Default_sldprt.STEP
923.1 x 294.6 x 652.0 mm
