Abdo-Pasha/MCT333_Design_of_Mechatronics_Systems_1/simscape_multibody_simulation/cad_files/FullAssembly.STEP

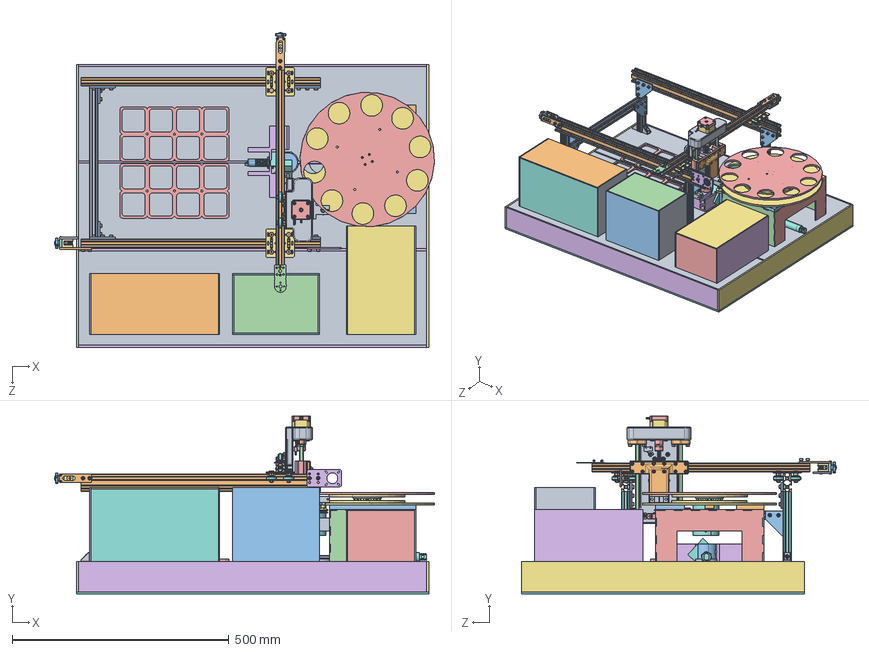
[picture p44: CAD file, 2026-10-14]
simscape_multibody_simulation/cad_files/FullAssembly.STEP
875.7 x 409.9 x 725.4 mm
UpperBase_1.stp
ProductsStoringGrid_1.stp x 2
BaseBoxLengthFace_2.stp x 2
BaseBoxWidthFace_1.stp x 2
BaseBoxLengthFace_1_1.stp x 2
LowerBase_1.stp
2020aluminum_extrusion_black_3.stp
2040aluminum_extrusion_black_1.stp x 2
2020 corner joining plate_1.stp x 5
Slider T-Nut for 2020 - M5_3.stp x 37
ISO 4762 - M5 x 10_3.stp x 42
Body_2.stp
2020 Belt Tensioner G_K_3.stp
2020 corner joining plate v1_MIR2_1.stp
Slider T-Nut for 2020 - M5_MIR2_1.stp x 5
2020aluminum_extrusion_black_1_1.stp x 4
Cast_Aluminum_L_Shape_Corner_Bracket_For_Aluminum_Extrusion_1.stp x 8
body_1_1.stp
Sensor_1.stp
Nut_1.stp x 2
Lock Washer_1.stp x 2
Part56_1.stp
LaserModule_1.stp x 2
Part23_1.stp
Part2_2.stp x 2
Part1_1_1.stp x 2
part5_1.stp
Part1_2.stp
Part22_1.stp
Part27_1.stp
Part67_1.stp
Rolling bearing 51109 GB_T 301-1995_1.stp
Part69_2.stp
PowerBoxLengthFace_4.stp x 2
PowerBoxWidthFace_2.stp x 2
PowerBoxLengthFace_1_1.stp
PowerBoxLengthFace_2_1.stp x 2
PowerBoxWidthFace_1_1.stp x 2
PowerBoxLengthFace_3_1.stp
ControlBoxLengthFace_1.stp x 2
ControlBoxWidthFace_1.stp x 2
ControlBoxCeiling_1.stp
AirCylinderBody_1.stp
16mm nut_1.stp
2020aluminum_extrusion_black_4.stp
2020 Belt Tensioner G_K_4.stp
ISO 4762 - M5 x 12_2.stp x 2
Slider T-Nut for 2020 - M5_4.stp x 4
motor holder bracket_2.stp
Slider T-Nut for 2020 - M3_2.stp x 2
ISO 4762 - M3 x 10_2.stp x 2
20mm Gantry Set_2.stp x 2
ISO 4762 - M5 x 10_4.stp x 2
ISO 4762 - M5 x 20_1.stp x 12
Z Bracket_1.stp
Bearing Spacer_1.stp
Document_1.stp x 8
M4 Insert_1.stp x 2
17HM15-0904S_1.stp
Flexible_Shaft_Coupling_5_to_8mm v7_1.stp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
