Abdo-Pasha/MCT333_Design_of_Mechatronics_Systems_1/CAD/cartesian_robot_workspace/cable-chain-18x37/J18BF.1. Close.SLDPRT

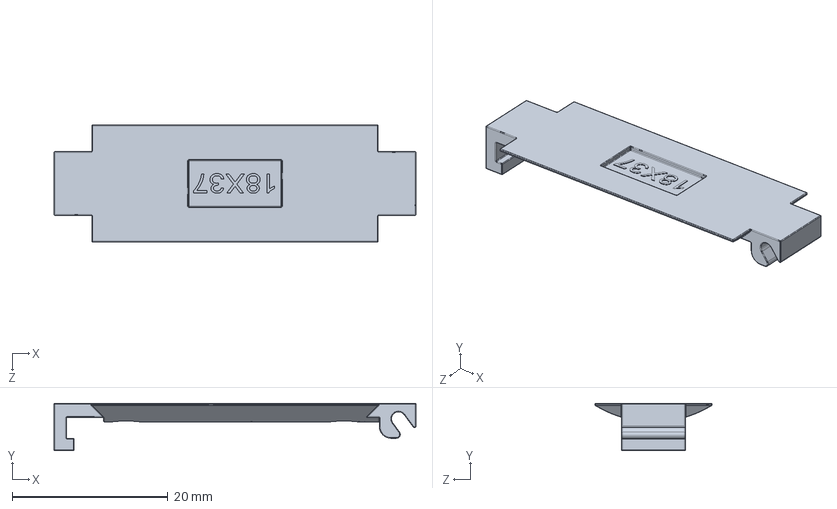
[picture p45: CAD file, 2026-10-21]
CAD/cartesian_robot_workspace/cable-chain-18x37/J18BF.1. Close.SLDPRT
46.5 x 6.10 x 15.0 mm
