Abdo-Pasha/MCT333_Design_of_Mechatronics_Systems_1/CAD/cartesian_robot_workspace/Z Axis/AluminumExtrusion/AluminumExtrusion/Extrusion2040/2040extrusion_stp/2040aluminum_extrusion_silver.stp

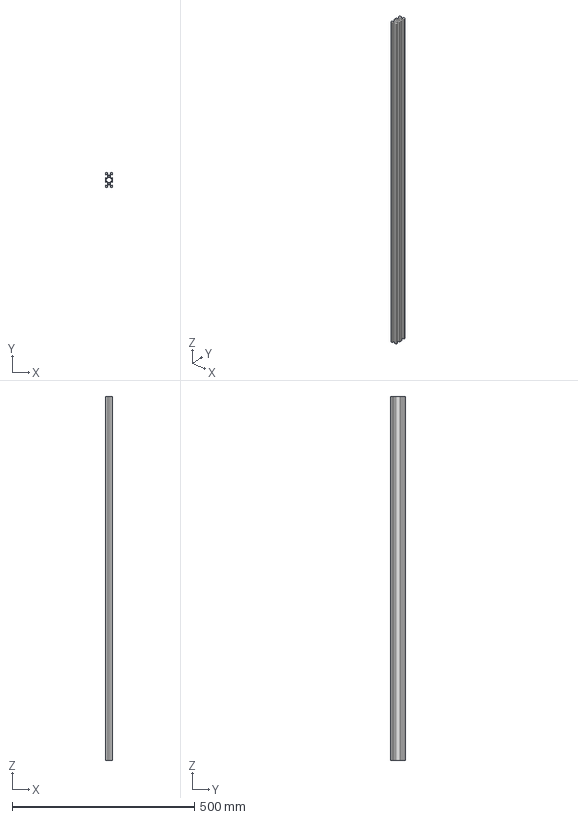
[picture p46: CAD file, 2026-10-13]
CAD/cartesian_robot_workspace/Z Axis/AluminumExtrusion/AluminumExtrusion/Extrusion2040/2040extrusion_stp/2040aluminum_extrusion_silver.stp
20.0 x 40.0 x 1000.0 mm
