Abdo-Pasha/MCT333_Design_of_Mechatronics_Systems_1/CAD/DXF/sorting_area/RxBack.dxf

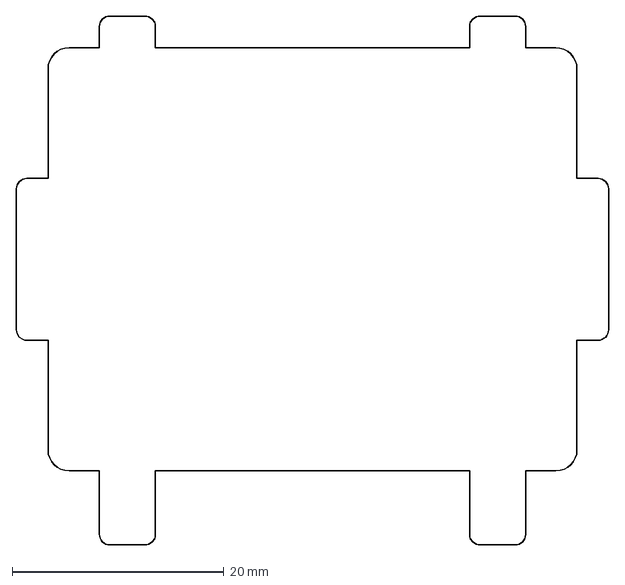
[picture p47: CAD file, 2026-10-19]
CAD/DXF/sorting_area/RxBack.dxf
56.0 x 50.0 mm
