Abdo-Pasha/MCT333_Design_of_Mechatronics_Systems_1/CAD/electronic_components/AB6-A_16mm_EStop_Mushroom_Switch.step

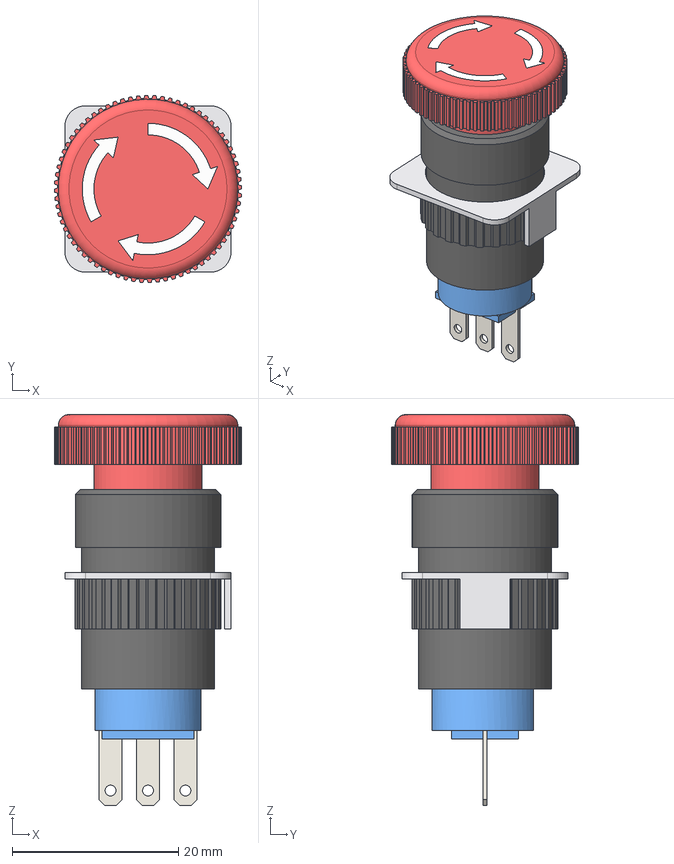
[picture p48: CAD file, 2026-10-21]
CAD/electronic_components/AB6-A_16mm_EStop_Mushroom_Switch.step
22.5 x 22.5 x 47.0 mm
red_knob
red_stem
black_body
lock_ring
steel_mount_plate
blue_terminal_block
solder_tab_1
solder_tab_2
solder_tab_3
