Abdo-Pasha/MCT333_Design_of_Mechatronics_Systems_1/CAD/electronic_components/power-supply-300-to-360w/360W Supply.step

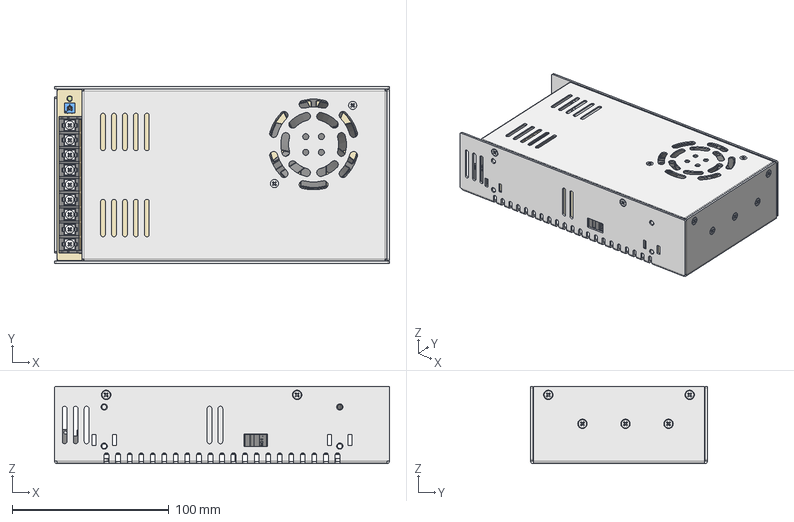
[picture p49: CAD file, 2026-10-24]
CAD/electronic_components/power-supply-300-to-360w/360W Supply.step
214.0 x 113.0 x 49.5 mm
M3x6-Screw x 5
M3x6-Screw009 x 11
