Abdo-Pasha/MCT333_Design_of_Mechatronics_Systems_1/CAD/FEED and Sorting/box/bottomplate.dxf

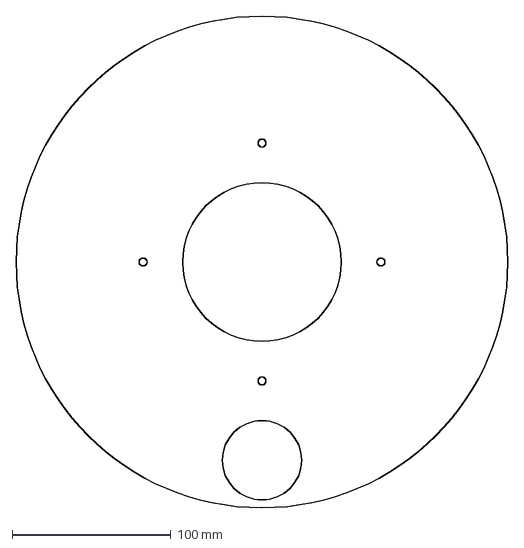
[picture p50: CAD file, 2026-10-10]
CAD/FEED and Sorting/box/bottomplate.dxf
310.0 x 310.0 mm
