Abdo-Pasha/MCT333_Design_of_Mechatronics_Systems_1/CAD/Lasercut parts/topplatebearing.dxf

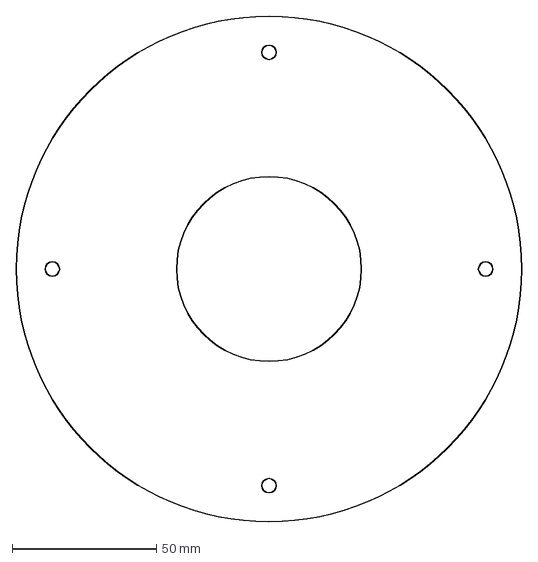
[picture p51: CAD file, 2026-10-14]
CAD/Lasercut parts/topplatebearing.dxf
175.0 x 175.0 mm
