Abdo-Pasha/MCT333_Design_of_Mechatronics_Systems_1/CAD/motors_and_actuators/l298n-DC-motor-driver-red/L298N Stepper Motor Driver (Red)-Part File.STEP

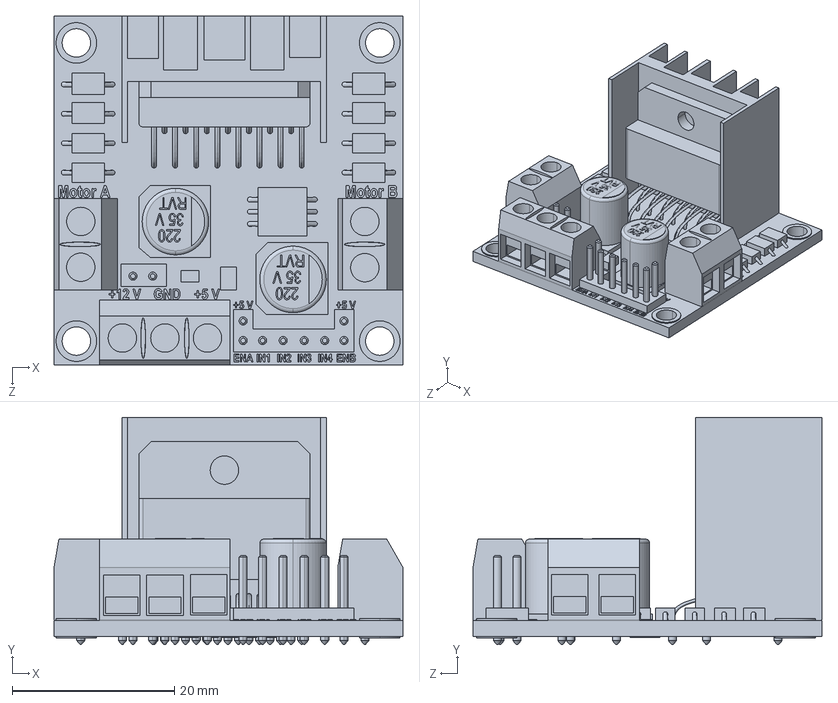
[picture p52: CAD file, 2026-10-21]
CAD/motors_and_actuators/l298n-DC-motor-driver-red/L298N Stepper Motor Driver (Red)-Part File.STEP
43.0 x 28.0 x 43.0 mm
