Abdo-Pasha/MCT333_Design_of_Mechatronics_Systems_1/CAD/off_the_shelf_components/flanged_inserts/flanged insert M6 D9.5 H14.05.stp.SLDPRT

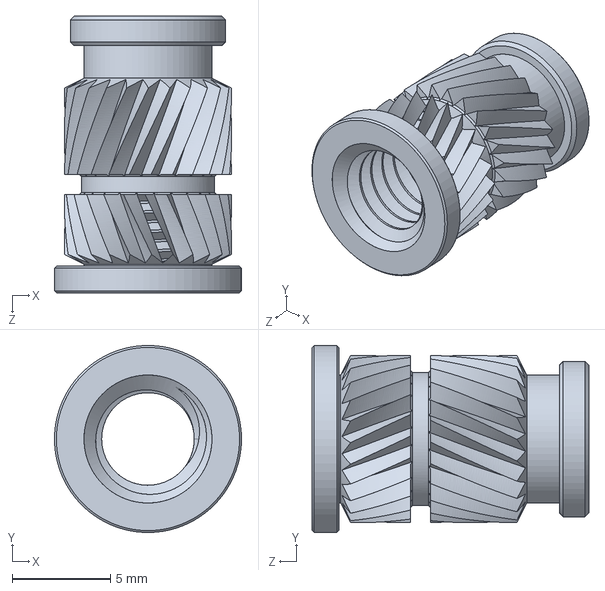
[picture p53: CAD file, 2026-10-19]
CAD/off_the_shelf_components/flanged_inserts/flanged insert M6 D9.5 H14.05.stp.SLDPRT
9.50 x 9.50 x 14.1 mm
