Abdo-Pasha/MCT333_Design_of_Mechatronics_Systems_1/CAD/off_the_shelf_components/ir-sensor-7.snapshot.2 (1)/IRsensors.STEP

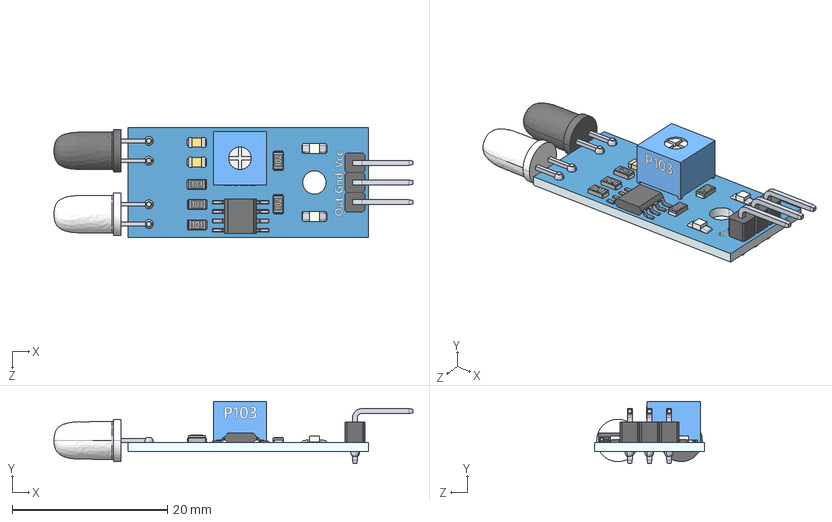
[picture p54: CAD file, 2026-10-10]
CAD/off_the_shelf_components/ir-sensor-7.snapshot.2 (1)/IRsensors.STEP
46.3 x 8.05 x 14.2 mm
IRboard
solder x 7
90headerMale x 3
blackLEDIRsensor
whiteLEDIRsensor
smdResistor101
smdResistor102 x 2
smdResistor103 x 2
smdceramiccapacitor x 2
smdLED x 2
smdTrimmerP103
smdChip8pin
