Abdo-Pasha/MCT333_Design_of_Mechatronics_Systems_1/CAD/off_the_shelf_components/standard-servo-motor-black-1.snapshot.7/body.SLDPRT

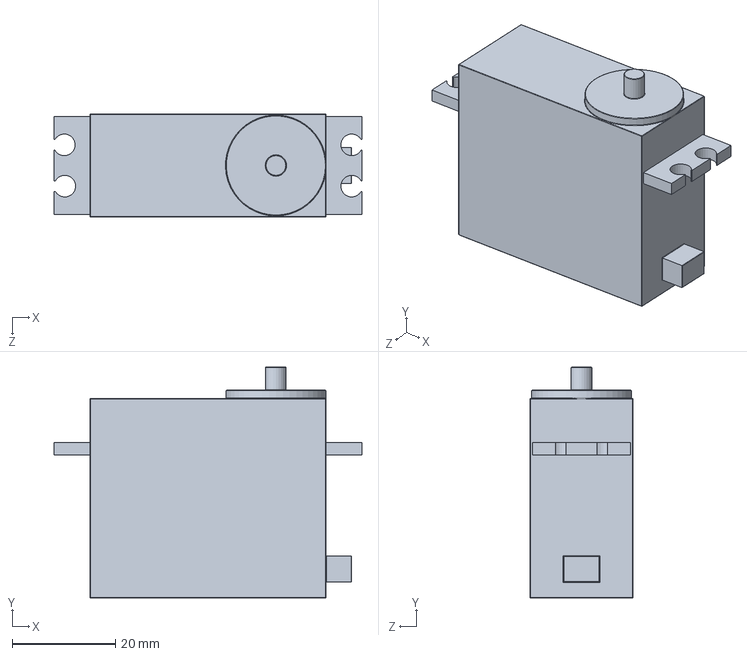
[picture p55: CAD file, 2026-10-10]
CAD/off_the_shelf_components/standard-servo-motor-black-1.snapshot.7/body.SLDPRT
59.8 x 44.8 x 20.0 mm
