Abdo-Pasha/MCT333_Design_of_Mechatronics_Systems_1/CAD/pnumatic_components/Pneumatic_Air_Cylinder_Double_Action/Front Cap.SLDPRT

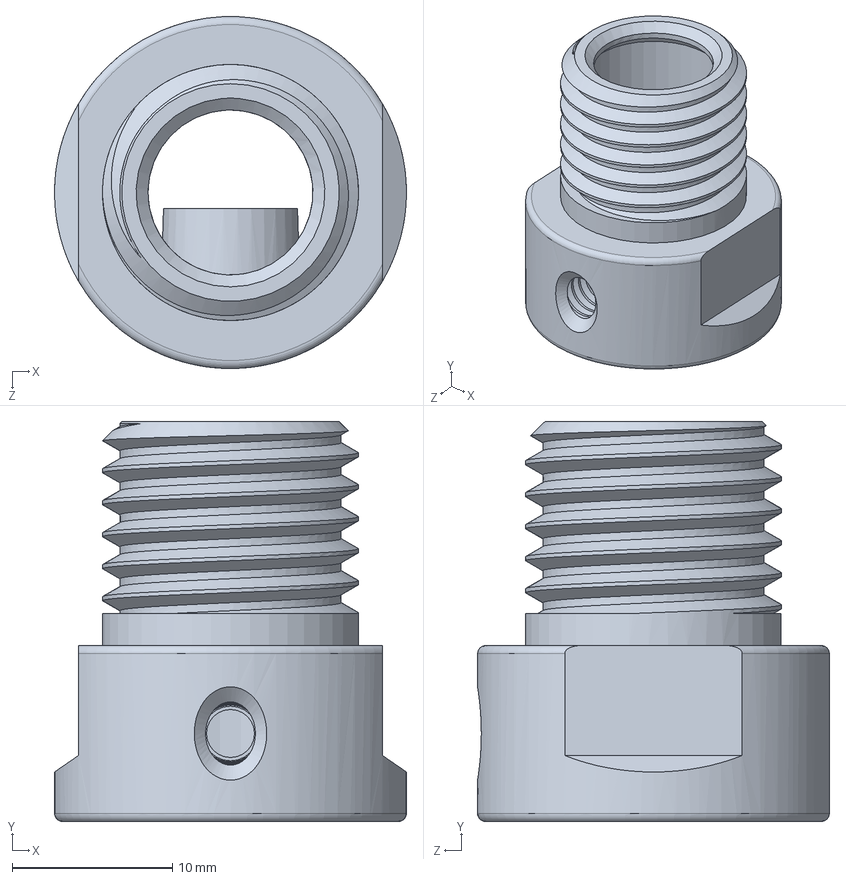
[picture p56: CAD file, 2026-10-13]
CAD/pnumatic_components/Pneumatic_Air_Cylinder_Double_Action/Front Cap.SLDPRT
22.0 x 25.0 x 22.0 mm
