Abdo-Pasha/MCT333_Design_of_Mechatronics_Systems_1/CAD/pnumatic_components/pneumatic_cylinder_double_action_mal16x75/PneumaticAirCylinder.STEP

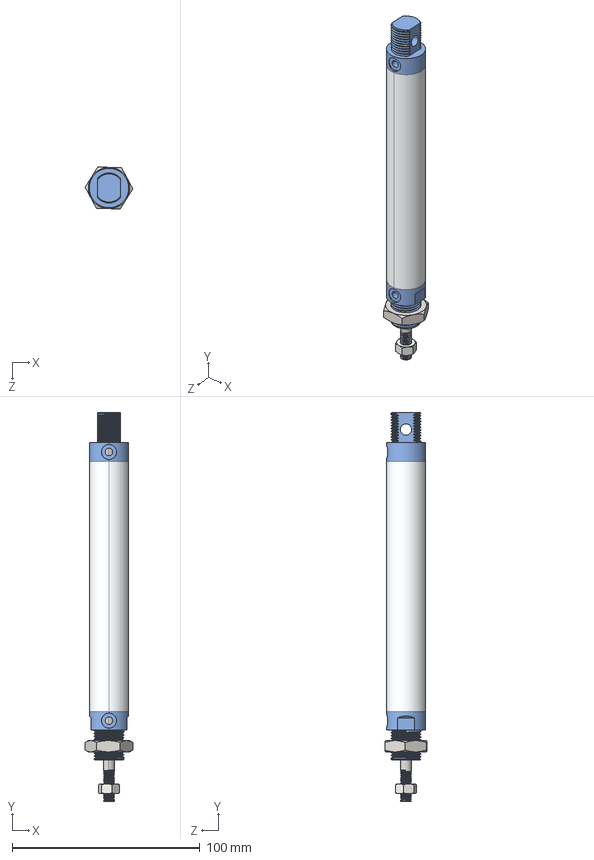
[picture p57: CAD file, 2026-10-14]
CAD/pnumatic_components/pneumatic_cylinder_double_action_mal16x75/PneumaticAirCylinder.STEP
25.4 x 207.0 x 22.4 mm
AirCylinderBody
AirCylinderAxis
16mm nut
hex nut style 1_am_B18.2.4.1M - Hex nut, Style 1, M6 x 1 --D-N
