Abdo-Pasha/MCT333_Design_of_Mechatronics_Systems_1/CAD/pnumatic_components/pneumatic_flow_control_valve/Flow control.SLDPRT

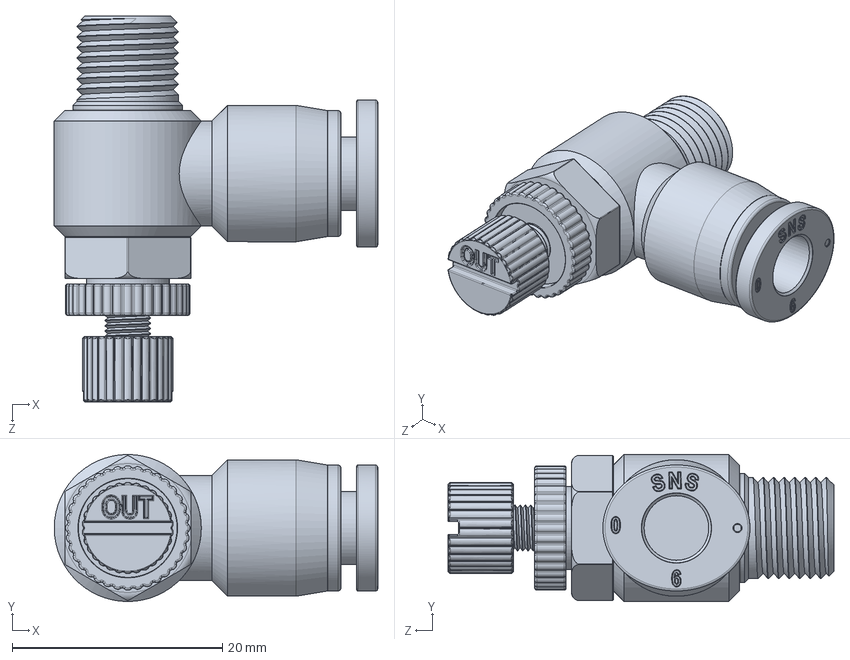
[picture p58: CAD file, 2026-10-16]
CAD/pnumatic_components/pneumatic_flow_control_valve/Flow control.SLDPRT
30.8 x 14.0 x 36.8 mm
