Abdo-Pasha/MCT333_Design_of_Mechatronics_Systems_1/CAD/pnumatic_components/PSU-01_G1-8_pneumatic_silencer_v2.step

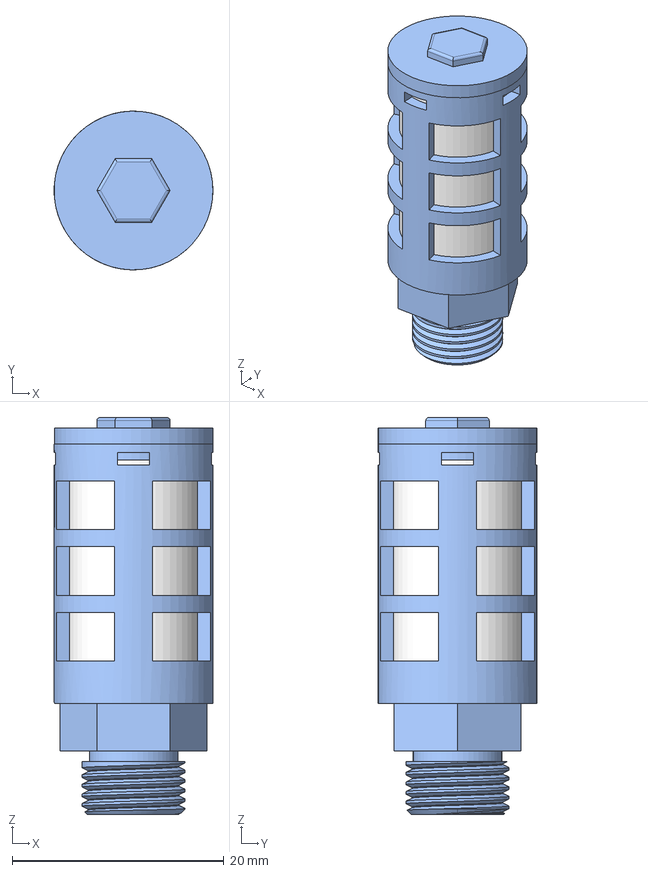
[picture p59: CAD file, 2026-10-21]
CAD/pnumatic_components/PSU-01_G1-8_pneumatic_silencer_v2.step
15.0 x 15.0 x 37.5 mm
PSU-01_fitting_blue_plastic
PSU-01_sintered_insert_PE
PSU-01_cap_blue_plastic
