Abdo-Pasha/MCT333_Design_of_Mechatronics_Systems_1/CAD/Product CAD/Product 1.stp

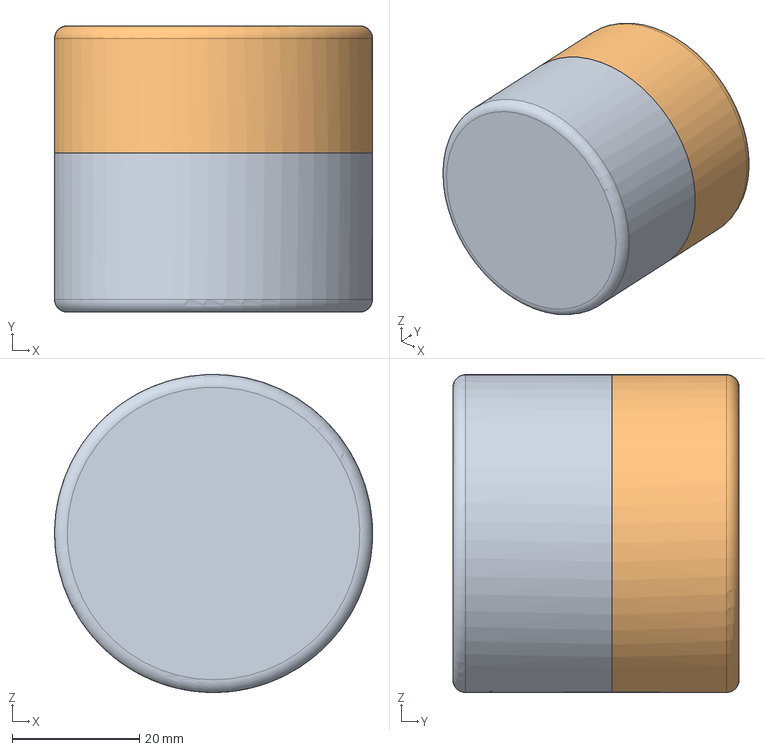
[picture p60: CAD file, 2026-10-15]
CAD/Product CAD/Product 1.stp
50.0 x 45.0 x 50.0 mm
Product Base
Product Lid
