Abdo-Pasha/MCT333_Design_of_Mechatronics_Systems_1/simscape_multibody_simulation/cad_files/Product Lid.stp

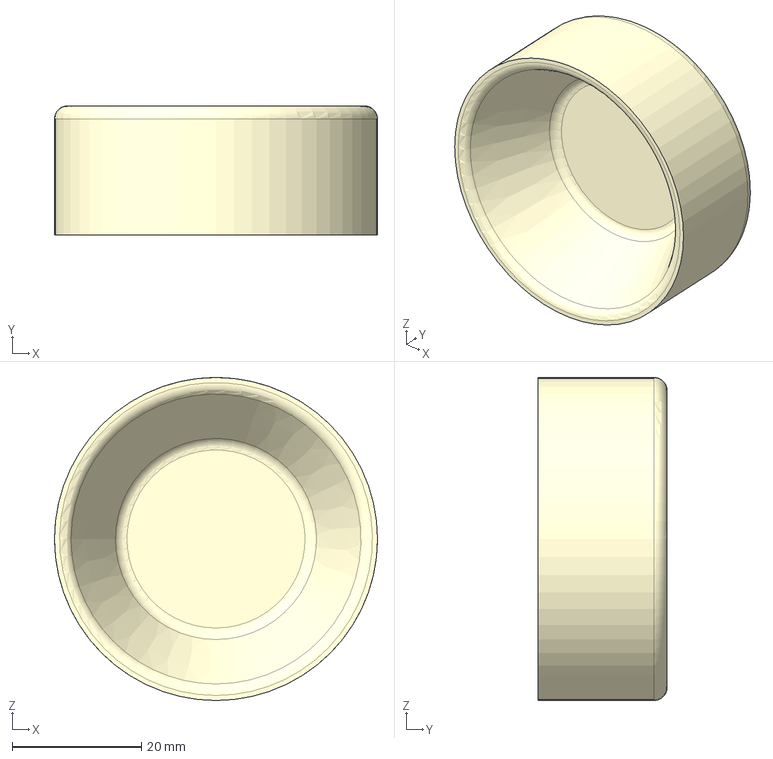
[picture p61: CAD file, 2026-10-15]
simscape_multibody_simulation/cad_files/Product Lid.stp
50.0 x 20.0 x 50.0 mm
