Abdo-Pasha/MCT333_Design_of_Mechatronics_Systems_1/simscape_multibody_simulation/simulation/PneumaticAirCylinder_Default_sldprt.STEP

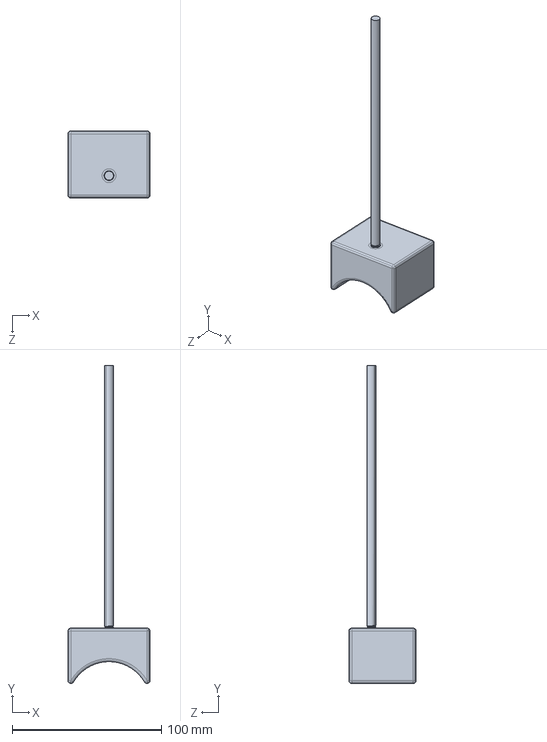
[picture p62: CAD file, 2026-10-25]
simscape_multibody_simulation/simulation/PneumaticAirCylinder_Default_sldprt.STEP
55.0 x 213.2 x 45.0 mm
