Abdo-Pasha/MCT333_Design_of_Mechatronics_Systems_1/simscape_multibody_simulation/simulation/simscapemultibody_contact_forces-26.1.5/Examples/2D/Geneva_Drive/CAD/Geometry/Geneva_Default_sldprt.STL

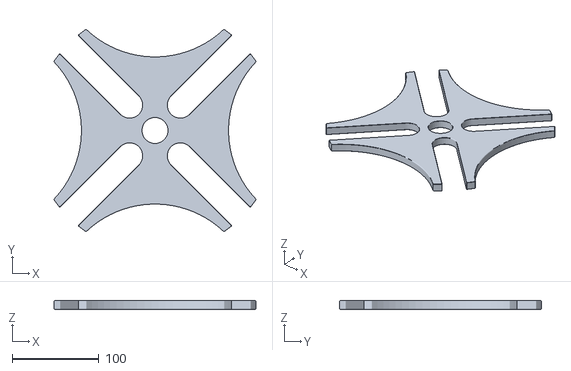
[picture p63: CAD file, 2026-10-24]
simscape_multibody_simulation/simulation/simscapemultibody_contact_forces-26.1.5/Examples/2D/Geneva_Drive/CAD/Geometry/Geneva_Default_sldprt.STL
233.3 x 233.3 x 10.0
