Abdo-Pasha/MCT333_Design_of_Mechatronics_Systems_1/CAD/cartesian_robot_workspace/Z Axis/nippel.SLDPRT

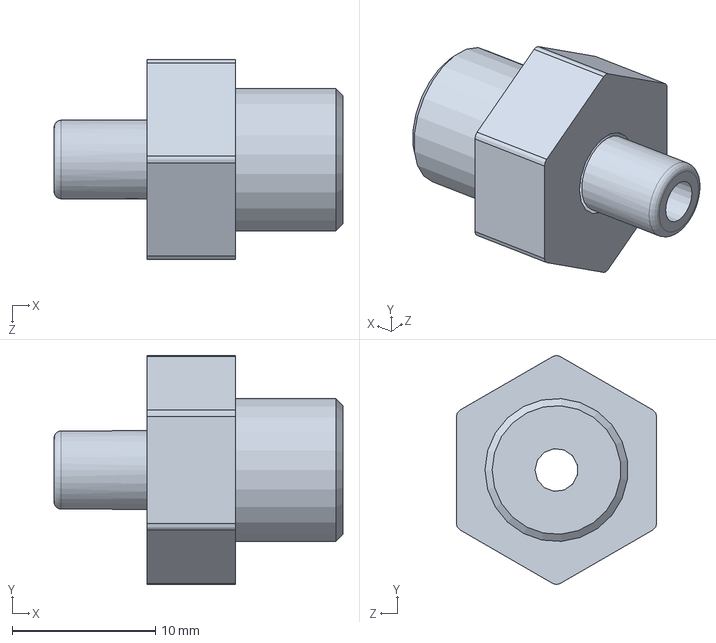
[picture p64: CAD file, 2026-10-13]
CAD/cartesian_robot_workspace/Z Axis/nippel.SLDPRT
20.2 x 16.0 x 14.0 mm
