Abdo-Pasha/MCT333_Design_of_Mechatronics_Systems_1/CAD/DXF/sorting_area/RxCeiling.dxf

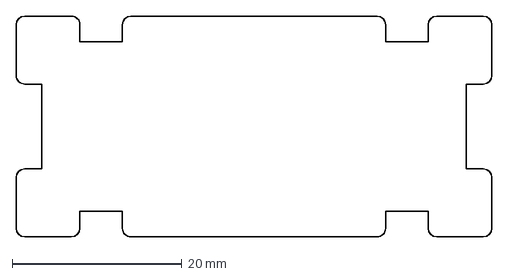
[picture p65: CAD file, 2026-10-19]
CAD/DXF/sorting_area/RxCeiling.dxf
56.0 x 26.0 mm
