Abdo-Pasha/MCT333_Design_of_Mechatronics_Systems_1/CAD/electronic_components/power-supply-300-to-360w/360W Power Supply.FCStd

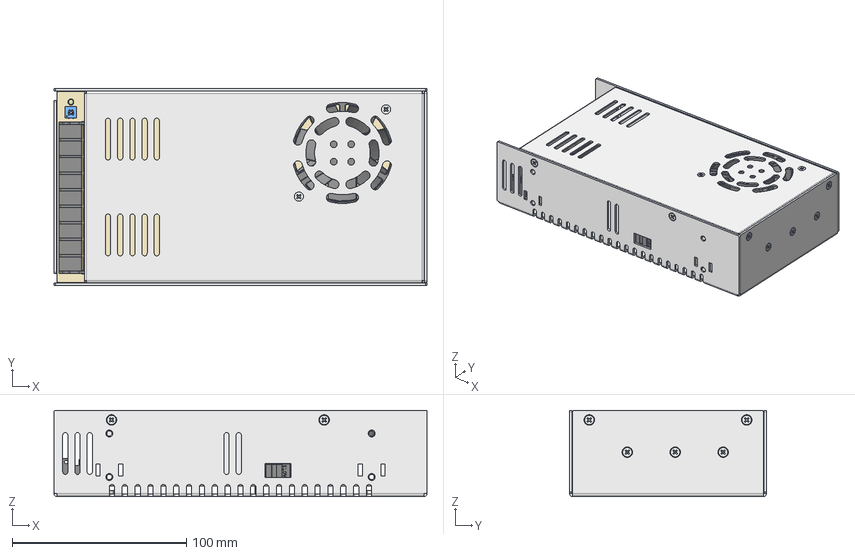
[picture p66: CAD file, 2026-10-24]
CAD/electronic_components/power-supply-300-to-360w/360W Power Supply.FCStd
214.0 x 113.0 x 49.5 mm
M3x6-Screw
M3x6-Screw005
M3x6-Screw006
M3x6-Screw007
M3x6-Screw008
M3x6-Screw009
M3x6-Screw012
M3x6-Screw015
M3x6-Screw016
M3x6-Screw022
M3x6-Screw023
M3x6-Screw024
M3x6-Screw025
M3x6-Screw026
M3x6-Screw030
M3x6-Screw031
