Abdo-Pasha/MCT333_Design_of_Mechatronics_Systems_1/CAD/FEED and Sorting/box/top.dxf

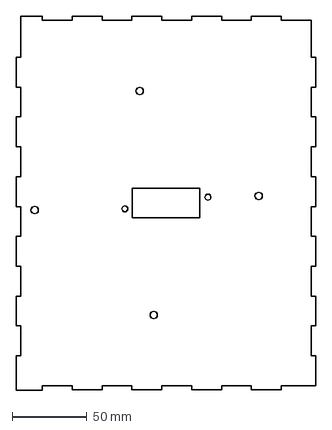
[picture p67: CAD file, 2026-10-10]
CAD/FEED and Sorting/box/top.dxf
200.0 x 250.0 mm
