Abdo-Pasha/MCT333_Design_of_Mechatronics_Systems_1/CAD/Lasercut parts/supportx2.dxf

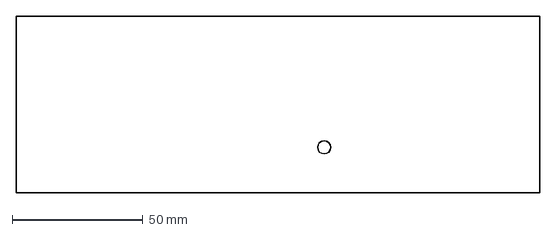
[picture p68: CAD file, 2026-10-14]
CAD/Lasercut parts/supportx2.dxf
200.0 x 67.5 mm
