Abdo-Pasha/MCT333_Design_of_Mechatronics_Systems_1/CAD/off_the_shelf_components/standard-servo-motor-black-1.snapshot.7/top.STL

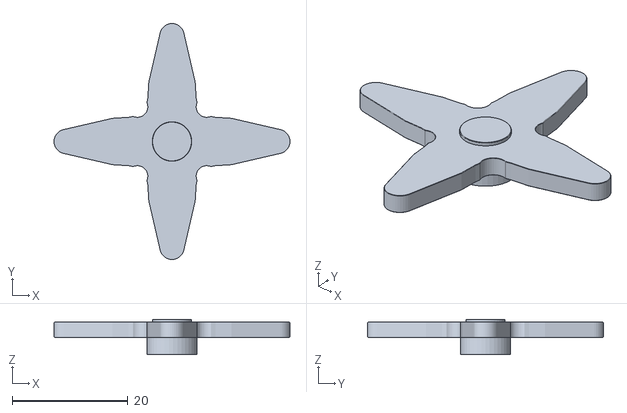
[picture p69: CAD file, 2026-10-10]
CAD/off_the_shelf_components/standard-servo-motor-black-1.snapshot.7/top.STL
40.7 x 40.7 x 6.10
