Abdo-Pasha/MCT333_Design_of_Mechatronics_Systems_1/CAD/pnumatic_components/Pneumatic_Air_Cylinder_Double_Action/Cylinder Barrel.SLDPRT

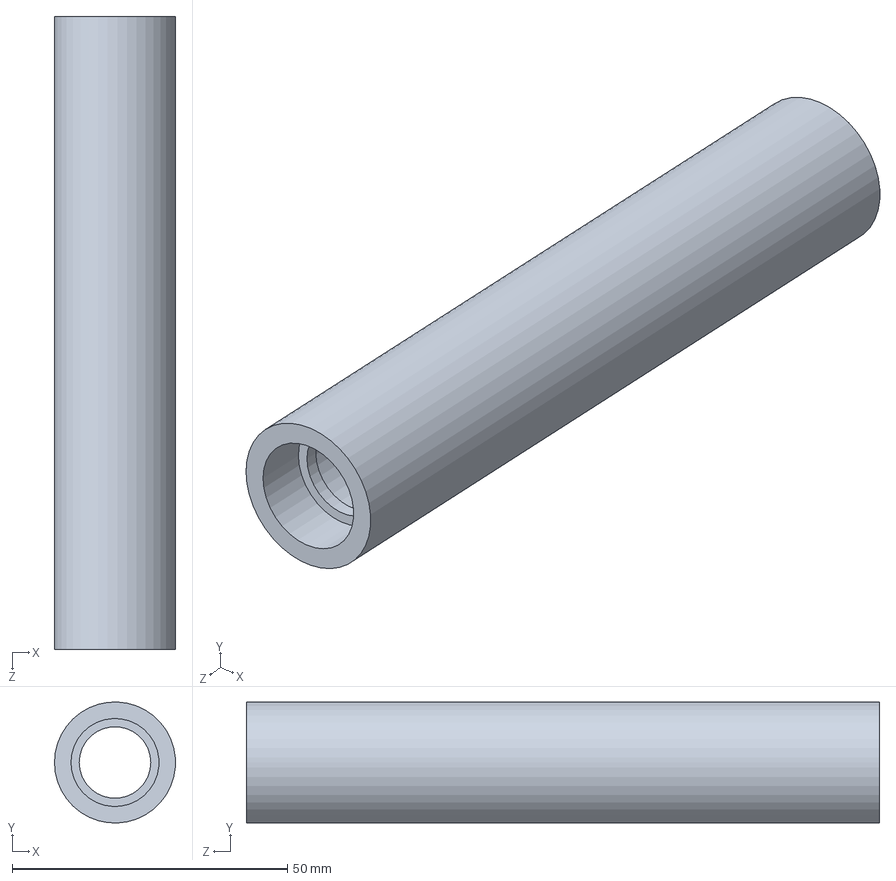
[picture p70: CAD file, 2026-10-13]
CAD/pnumatic_components/Pneumatic_Air_Cylinder_Double_Action/Cylinder Barrel.SLDPRT
22.0 x 22.0 x 115.0 mm
