Abdo-Pasha/MCT333_Design_of_Mechatronics_Systems_1/CAD/pnumatic_components/pneumatic_cylinder_double_action_mal16x75/SolidWorks/AirCylinderAxis.SLDPRT

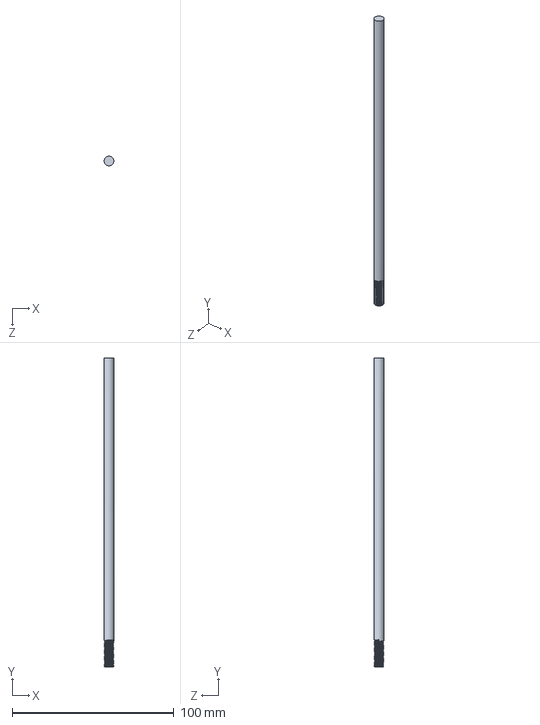
[picture p71: CAD file, 2026-10-14]
CAD/pnumatic_components/pneumatic_cylinder_double_action_mal16x75/SolidWorks/AirCylinderAxis.SLDPRT
6.00 x 191.0 x 6.00 mm
