Abdo-Pasha/MCT333_Design_of_Mechatronics_Systems_1/CAD/Product CAD/Product Base.stp

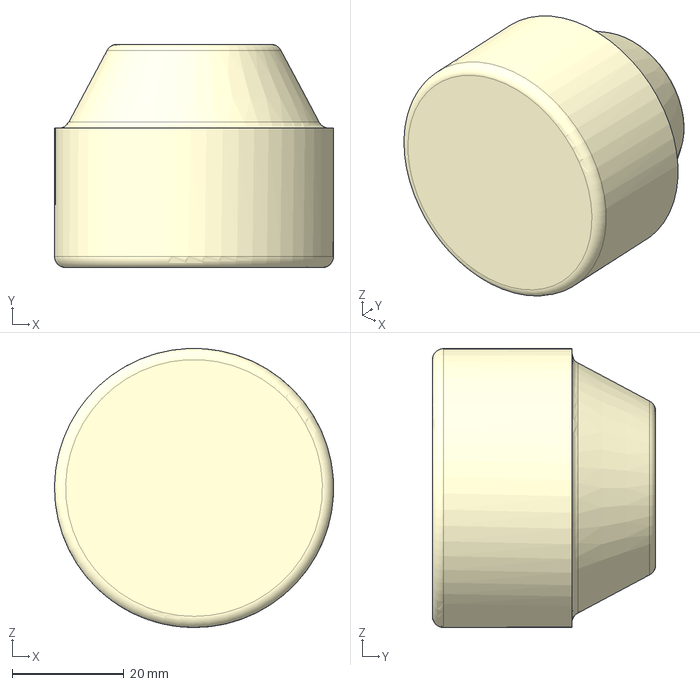
[picture p72: CAD file, 2026-10-15]
CAD/Product CAD/Product Base.stp
50.0 x 40.0 x 50.0 mm
