Abdo-Pasha/MCT333_Design_of_Mechatronics_Systems_1/simscape_multibody_simulation/cad_files/Z_axisMultibodyPart.SLDPRT

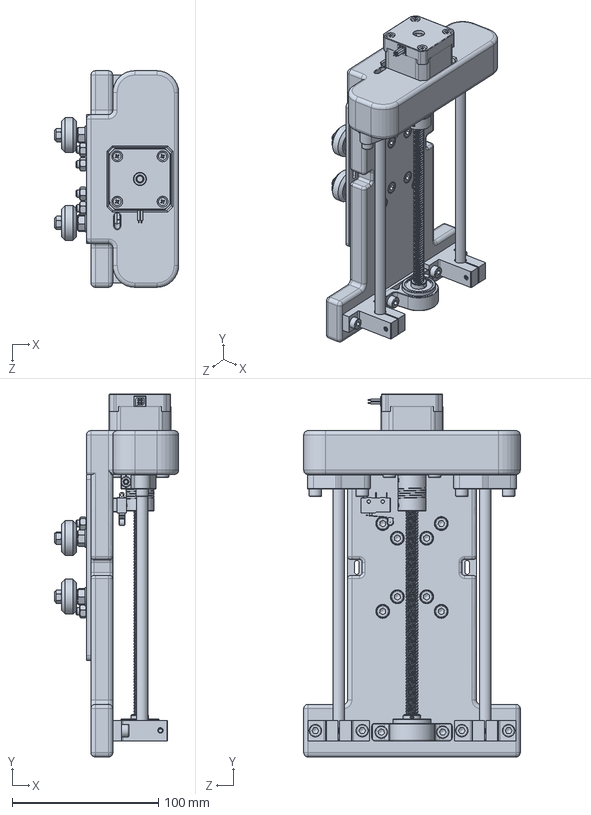
[picture p73: CAD file, 2026-10-15]
simscape_multibody_simulation/cad_files/Z_axisMultibodyPart.SLDPRT
85.0 x 248.0 x 148.0 mm
