Abdo-Pasha/MCT333_Design_of_Mechatronics_Systems_1/simscape_multibody_simulation/simulation/Y_axisMutlibodyPart_Default_sldprt.STEP

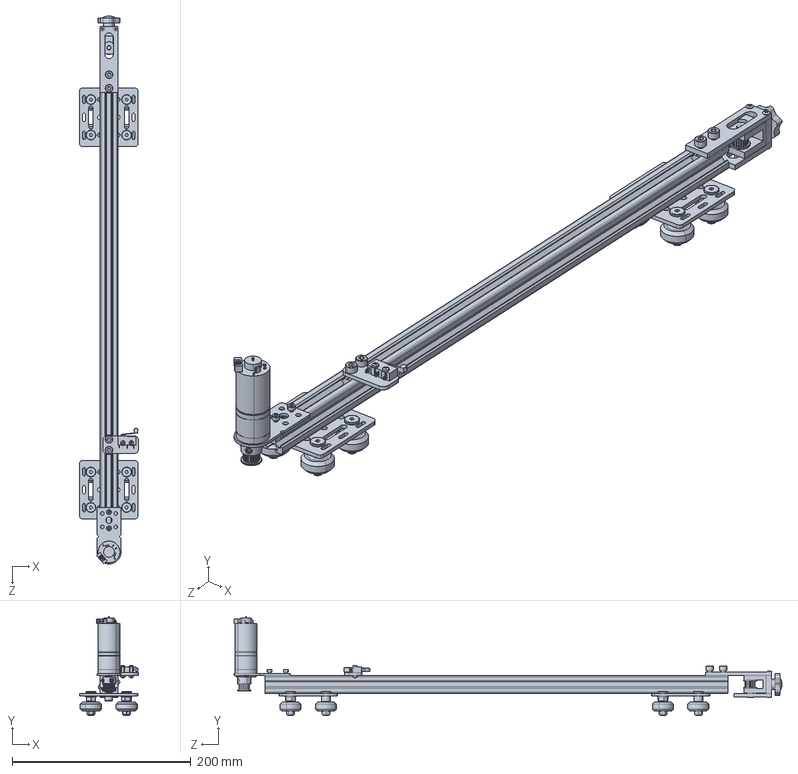
[picture p74: CAD file, 2026-10-25]
simscape_multibody_simulation/simulation/Y_axisMutlibodyPart_Default_sldprt.STEP
66.0 x 111.1 x 613.6 mm
