Abdo-Pasha/MCT333_Design_of_Mechatronics_Systems_1/CAD/cartesian_robot_workspace/Z Axis/SK12 SHAFT HOLDER.SLDPRT

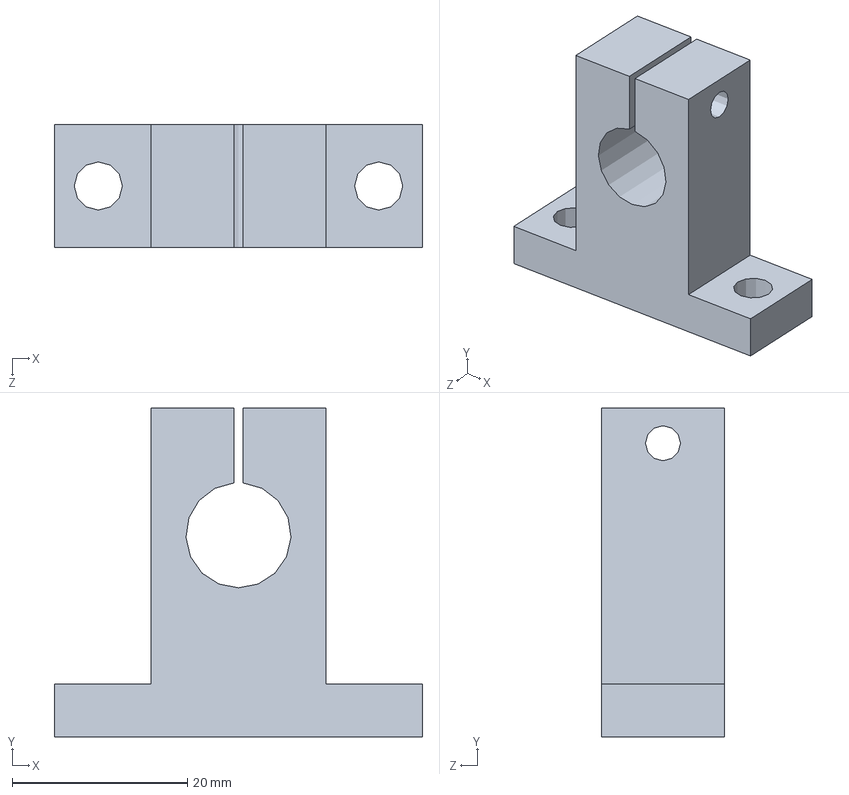
[picture p75: CAD file, 2026-10-13]
CAD/cartesian_robot_workspace/Z Axis/SK12 SHAFT HOLDER.SLDPRT
42.0 x 37.5 x 14.0 mm
