Abdo-Pasha/MCT333_Design_of_Mechatronics_Systems_1/CAD/Lasercut parts/yopplate.dxf

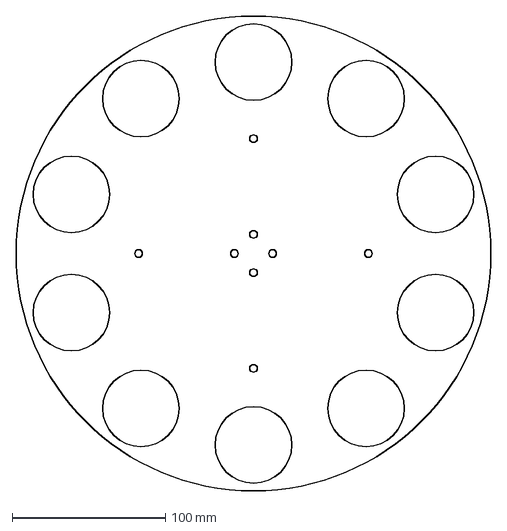
[picture p78: CAD file, 2026-10-14]
CAD/Lasercut parts/yopplate.dxf
310.0 x 310.0 mm
