Abdo-Pasha/MCT333_Design_of_Mechatronics_Systems_1/CAD/pnumatic_components/pneumatic_cylinder_double_action_mal16x75/SolidWorks/AirCylinderBody.SLDPRT

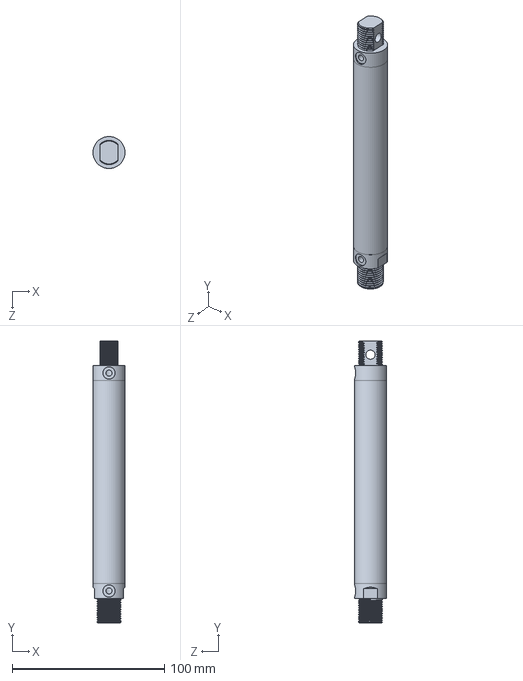
[picture p80: CAD file, 2026-10-14]
CAD/pnumatic_components/pneumatic_cylinder_double_action_mal16x75/SolidWorks/AirCylinderBody.SLDPRT
21.0 x 185.0 x 21.0 mm
