Abdo-Pasha/MCT333_Design_of_Mechatronics_Systems_1/simscape_multibody_simulation/cad_files/PneumaticPistonMultibodyPart.SLDPRT

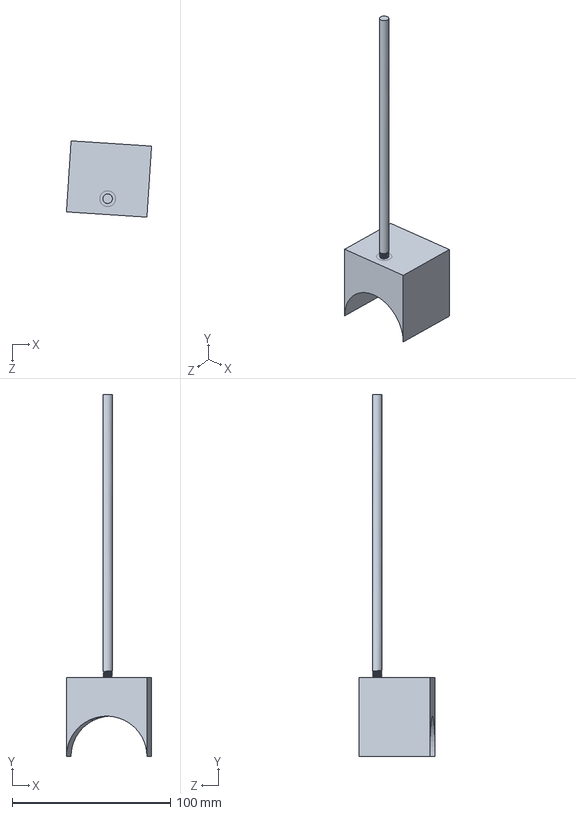
[picture p81: CAD file, 2026-10-15]
simscape_multibody_simulation/cad_files/PneumaticPistonMultibodyPart.SLDPRT
53.8 x 228.8 x 48.2 mm
