Abdo-Pasha/MCT333_Design_of_Mechatronics_Systems_1/CAD/cartesian_robot_workspace/cable-chain-18x37/J15BF.1.18.2PZ.SLDPRT

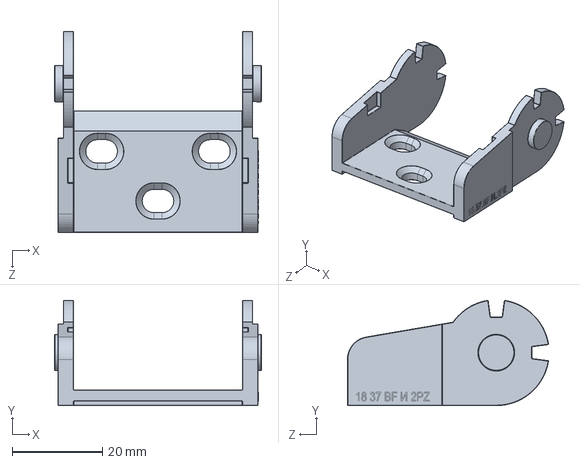
[picture p82: CAD file, 2026-10-21]
CAD/cartesian_robot_workspace/cable-chain-18x37/J15BF.1.18.2PZ.SLDPRT
45.9 x 23.3 x 44.6 mm
