Abdo-Pasha/MCT333_Design_of_Mechatronics_Systems_1/CAD/DXF/sorting_area/TxFace1.dxf

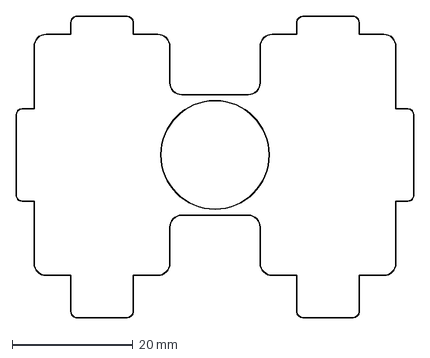
[picture p83: CAD file, 2026-10-19]
CAD/DXF/sorting_area/TxFace1.dxf
66.0 x 50.0 mm
