Abdo-Pasha/MCT333_Design_of_Mechatronics_Systems_1/CAD/FEED and Sorting/box/sid2x2.dxf

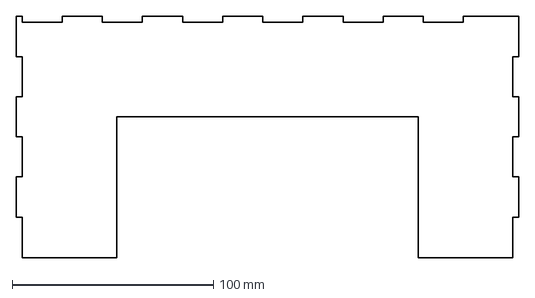
[picture p84: CAD file, 2026-10-10]
CAD/FEED and Sorting/box/sid2x2.dxf
250.0 x 120.0 mm
