Abdo-Pasha/MCT333_Design_of_Mechatronics_Systems_1/CAD/Lasercut parts/bottomplate.dxf

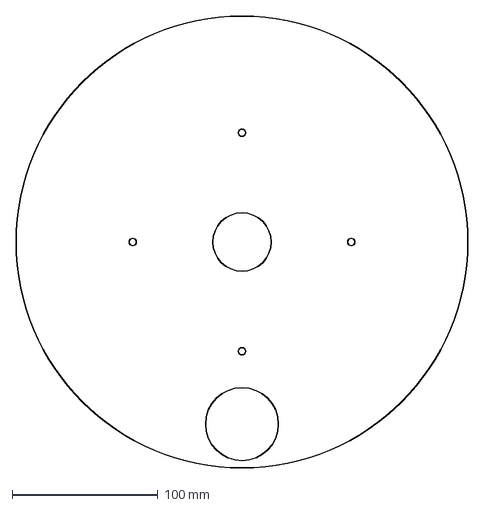
[picture p85: CAD file, 2026-10-14]
CAD/Lasercut parts/bottomplate.dxf
310.0 x 310.0 mm
