Abdo-Pasha/MCT333_Design_of_Mechatronics_Systems_1/CAD/pnumatic_components/Pneumatic_Air_Cylinder_Double_Action/Hex Jam Nuts (Piston).SLDPRT

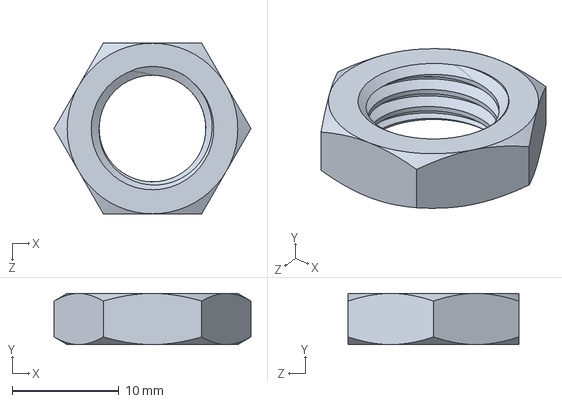
[picture p86: CAD file, 2026-10-13]
CAD/pnumatic_components/Pneumatic_Air_Cylinder_Double_Action/Hex Jam Nuts (Piston).SLDPRT
18.5 x 4.80 x 16.0 mm
