Abdo-Pasha/MCT333_Design_of_Mechatronics_Systems_1/simscape_multibody_simulation/cad_files/StasionaryPartsMultibodyPart.SLDPRT

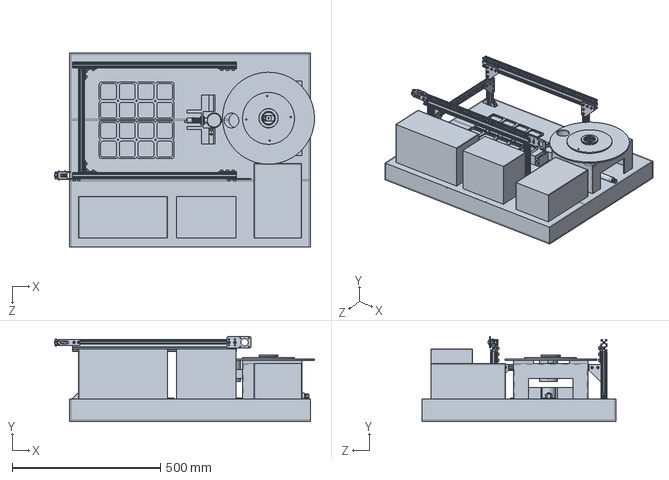
[picture p87: CAD file, 2026-10-15]
simscape_multibody_simulation/cad_files/StasionaryPartsMultibodyPart.SLDPRT
875.8 x 286.4 x 652.0 mm
