Abdo-Pasha/MCT333_Design_of_Mechatronics_Systems_1/CAD/cartesian_robot_workspace/cable-chain-18x37/J18BF.1.Link.SLDPRT

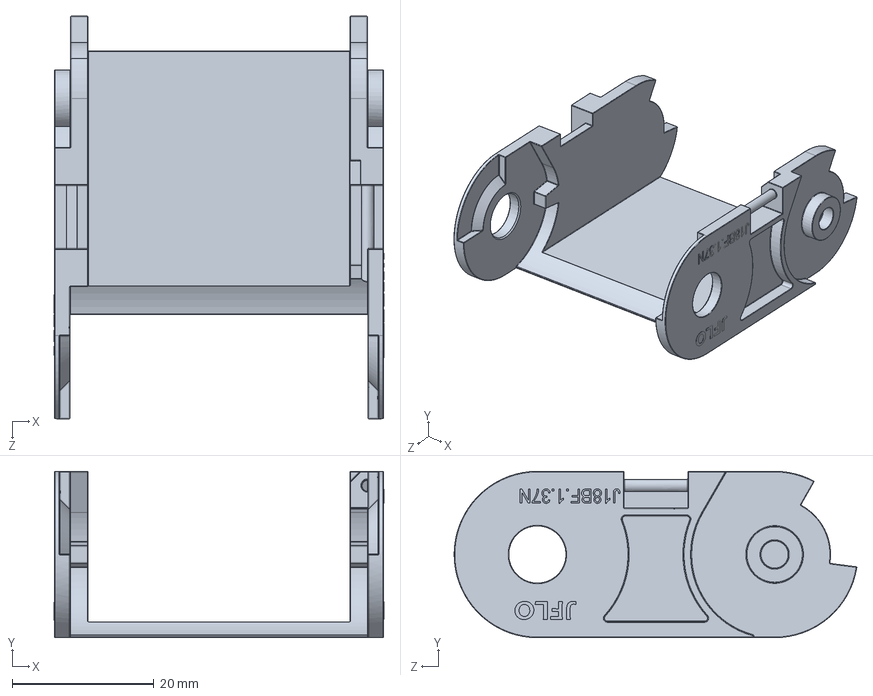
[picture p88: CAD file, 2026-10-21]
CAD/cartesian_robot_workspace/cable-chain-18x37/J18BF.1.Link.SLDPRT
46.6 x 23.5 x 56.9 mm
