Abdo-Pasha/MCT333_Design_of_Mechatronics_Systems_1/CAD/cartesian_robot_workspace/Z Axis/Suction-ohne-nippel.SLDPRT

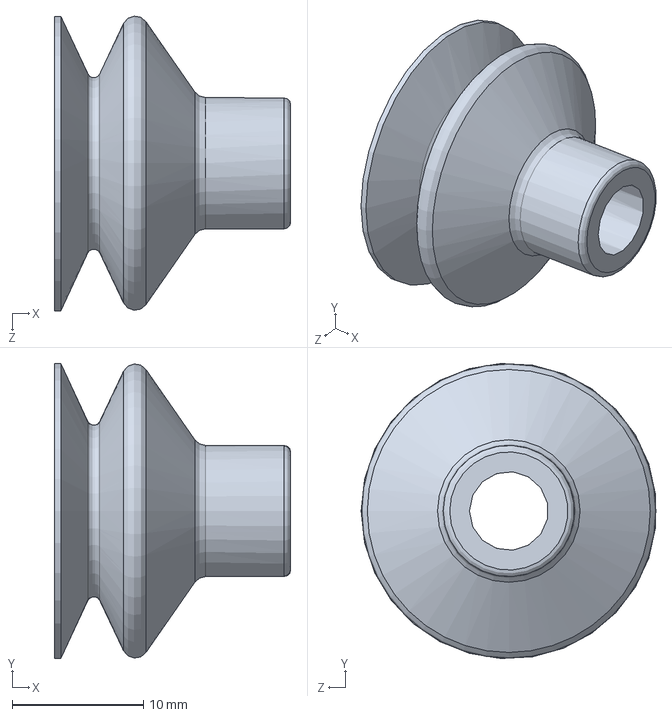
[picture p89: CAD file, 2026-10-13]
CAD/cartesian_robot_workspace/Z Axis/Suction-ohne-nippel.SLDPRT
18.0 x 22.5 x 22.5 mm
