Abdo-Pasha/MCT333_Design_of_Mechatronics_Systems_1/CAD/FEED and Sorting/box/topplate.dxf

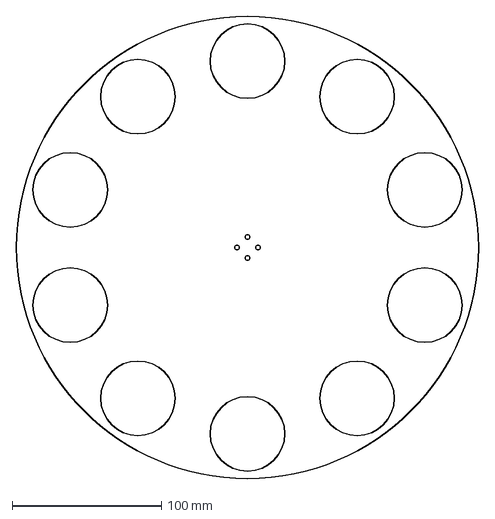
[picture p91: CAD file, 2026-10-10]
CAD/FEED and Sorting/box/topplate.dxf
310.0 x 310.0 mm
