Abdo-Pasha/MCT333_Design_of_Mechatronics_Systems_1/CAD/Lasercut parts/bottomplacebearing.dxf

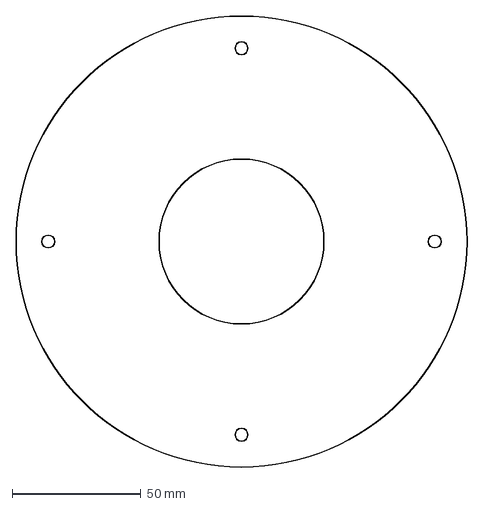
[picture p92: CAD file, 2026-10-14]
CAD/Lasercut parts/bottomplacebearing.dxf
175.0 x 175.0 mm
