Abdo-Pasha/MCT333_Design_of_Mechatronics_Systems_1/CAD/pnumatic_components/Pneumatic_Air_Cylinder_Double_Action/Hex Jam Nuts (Front Cap).SLDPRT

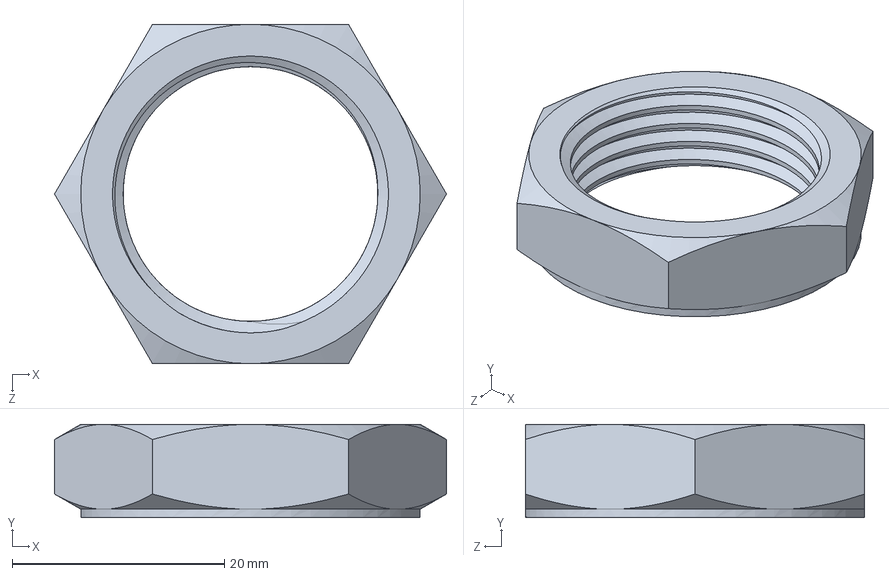
[picture p93: CAD file, 2026-10-13]
CAD/pnumatic_components/Pneumatic_Air_Cylinder_Double_Action/Hex Jam Nuts (Front Cap).SLDPRT
37.0 x 8.80 x 32.0 mm
