Abdo-Pasha/MCT333_Design_of_Mechatronics_Systems_1/simscape_multibody_simulation/cad_files/EndEffectorMultibodyPart.SLDPRT

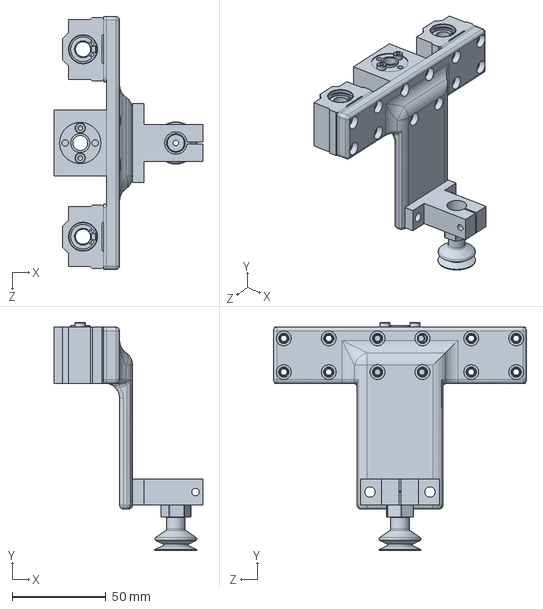
[picture p94: CAD file, 2026-10-15]
simscape_multibody_simulation/cad_files/EndEffectorMultibodyPart.SLDPRT
79.5 x 121.7 x 135.0 mm
