Abdo-Pasha/MCT333_Design_of_Mechatronics_Systems_1/CAD/DXF/sorting_area/TxSide1.dxf

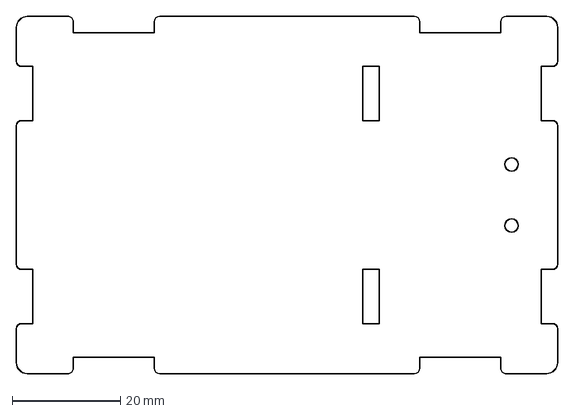
[picture p95: CAD file, 2026-10-19]
CAD/DXF/sorting_area/TxSide1.dxf
100.0 x 66.0 mm
