Abdo-Pasha/MCT333_Design_of_Mechatronics_Systems_1/CAD/pnumatic_components/Pneumatic_Air_Cylinder_Double_Action/Piston Rod.SLDPRT

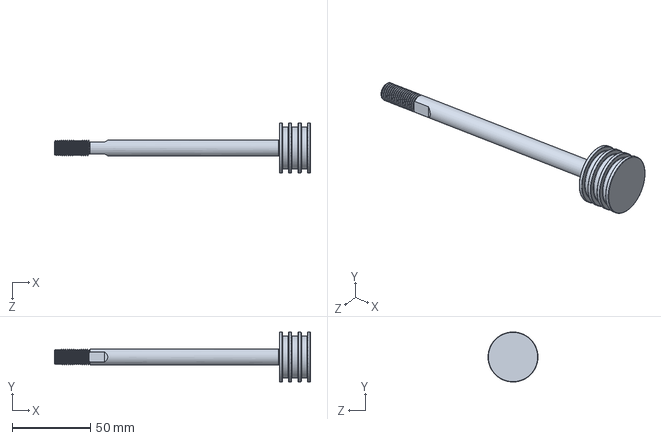
[picture p96: CAD file, 2026-10-13]
CAD/pnumatic_components/Pneumatic_Air_Cylinder_Double_Action/Piston Rod.SLDPRT
164.0 x 32.0 x 32.0 mm
