Abdo-Pasha/MCT333_Design_of_Mechatronics_Systems_1/simscape_multibody_simulation/cad_files/Y_axisMutlibodyPart.SLDPRT

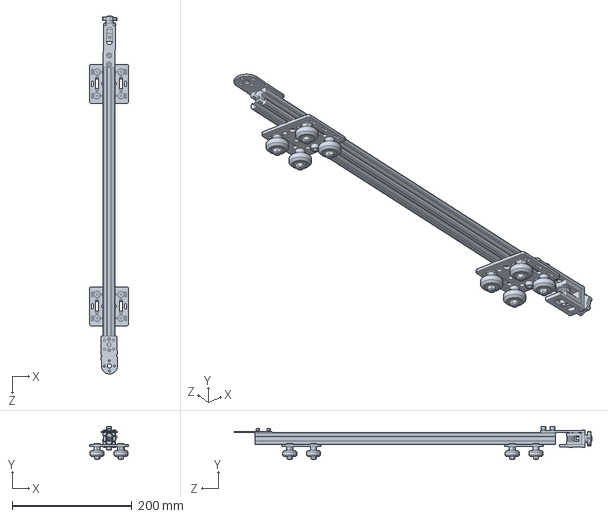
[picture p97: CAD file, 2026-10-15]
simscape_multibody_simulation/cad_files/Y_axisMutlibodyPart.SLDPRT
65.5 x 55.7 x 598.6 mm
