Abdo-Pasha/MCT333_Design_of_Mechatronics_Systems_1/CAD/DXF/sorting_area/RxSlot.dxf

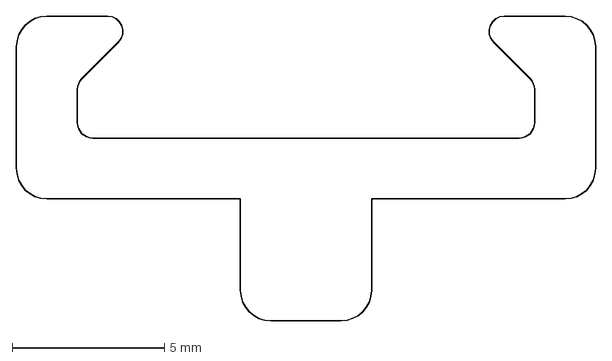
[picture p98: CAD file, 2026-10-19]
CAD/DXF/sorting_area/RxSlot.dxf
19.0 x 10.0 mm
