Abdo-Pasha/MCT333_Design_of_Mechatronics_Systems_1/CAD/pnumatic_components/Pneumatic_Air_Cylinder_Double_Action/Pneumatic Air Cylinder Double Action.STEP

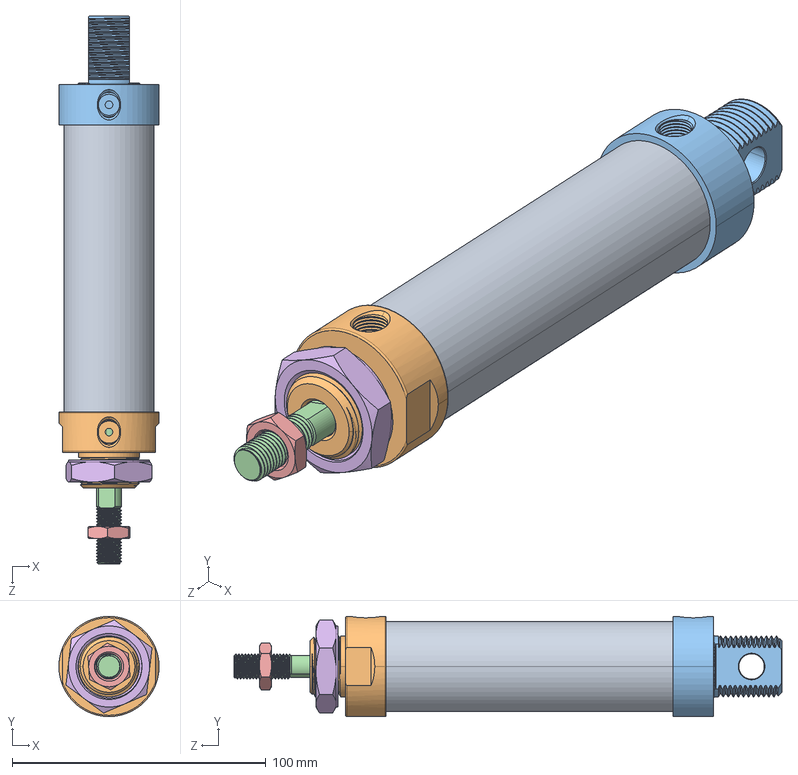
[picture p99: CAD file, 2026-10-13]
CAD/pnumatic_components/Pneumatic_Air_Cylinder_Double_Action/Pneumatic Air Cylinder Double Action.STEP
39.5 x 39.5 x 216.0 mm
Cylinder Barrel_32
Front Cap_32
Back Cap_32
Piston Rod_32
Hex Jam Nuts (Piston)_M10*1.25
Hex Jam Nuts (Front Cap)_M24*2
