Abdo-Pasha/MCT333_Design_of_Mechatronics_Systems_1/simscape_multibody_simulation/cad_files/FeedingDiscMultibodyPart.SLDPRT

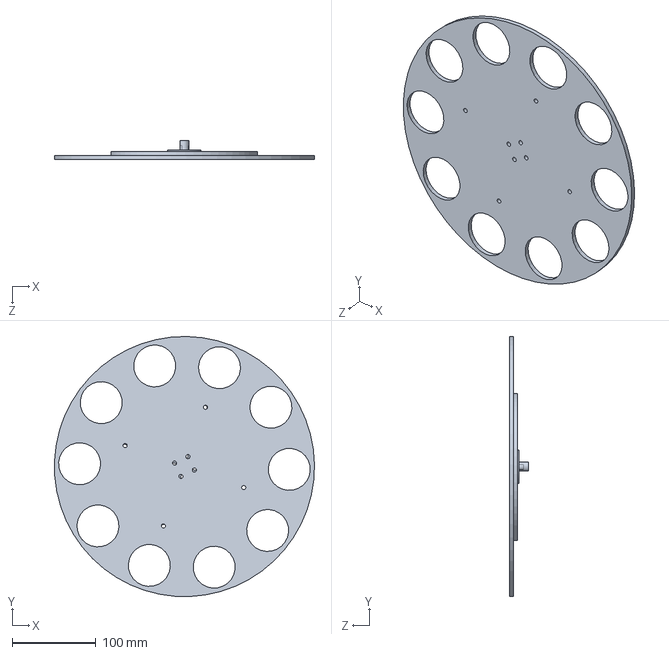
[picture p100: CAD file, 2026-10-15]
simscape_multibody_simulation/cad_files/FeedingDiscMultibodyPart.SLDPRT
309.8 x 309.8 x 23.0 mm
