Abdo-Pasha/MCT333_Design_of_Mechatronics_Systems_1/simscape_multibody_simulation/simulation/LocatingPart_Default_sldprt.STEP

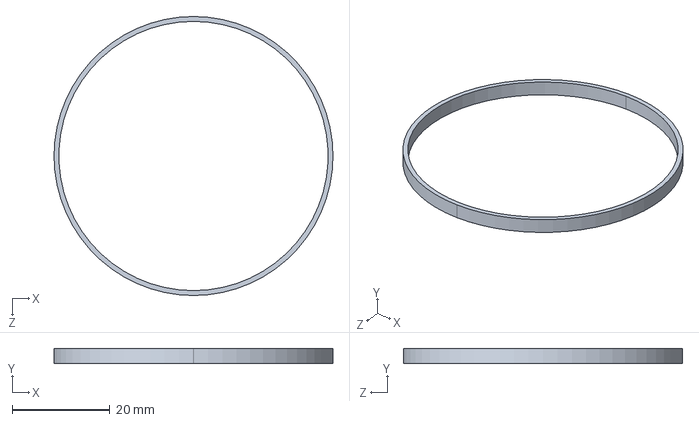
[picture p101: CAD file, 2026-10-25]
simscape_multibody_simulation/simulation/LocatingPart_Default_sldprt.STEP
57.0 x 3.00 x 57.0 mm
