Abdo-Pasha/MCT333_Design_of_Mechatronics_Systems_1/CAD/cartesian_robot_workspace/cable-chain-18x37/J15BF.1.18.1PZ.SLDPRT

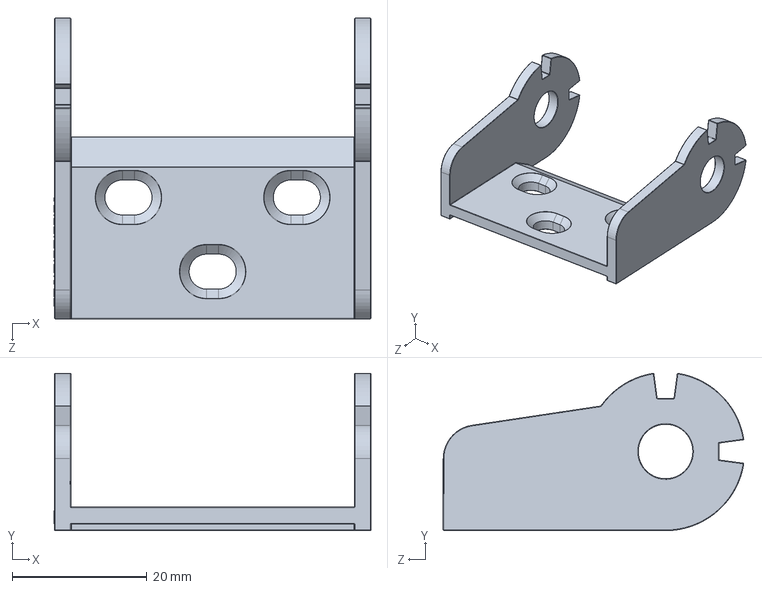
[picture p102: CAD file, 2026-10-21]
CAD/cartesian_robot_workspace/cable-chain-18x37/J15BF.1.18.1PZ.SLDPRT
47.0 x 23.4 x 44.6 mm
