Abdo-Pasha/MCT333_Design_of_Mechatronics_Systems_1/CAD/cartesian_robot_workspace/Z Axis/Gantry_Plate_65x65.SLDPRT

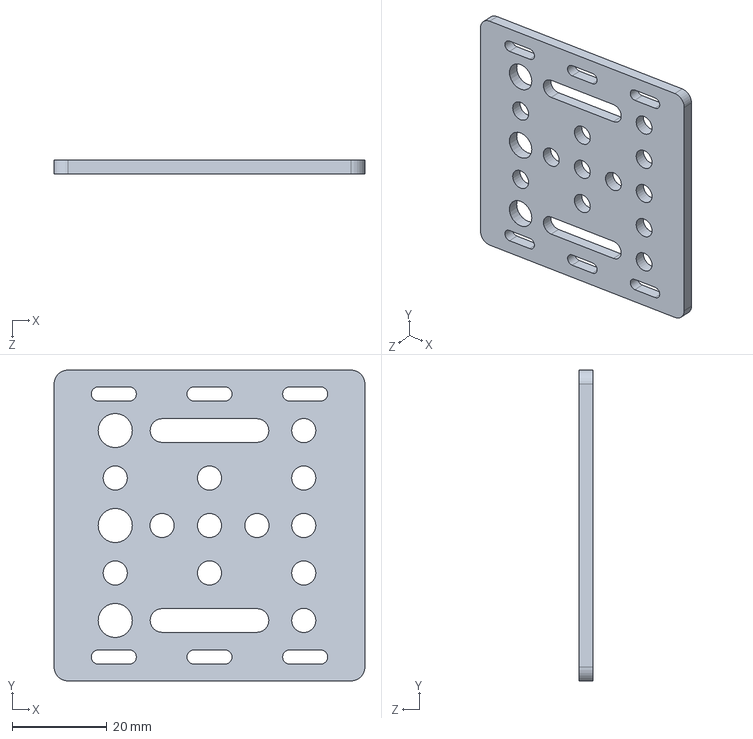
[picture p104: CAD file, 2026-10-13]
CAD/cartesian_robot_workspace/Z Axis/Gantry_Plate_65x65.SLDPRT
65.5 x 65.5 x 3.00 mm
