Abdo-Pasha/MCT333_Design_of_Mechatronics_Systems_1/CAD/DXF/sorting_area/RxSide2.dxf

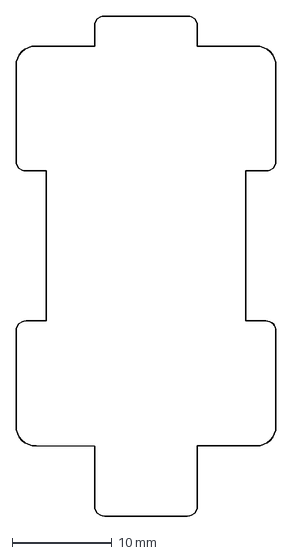
[picture p105: CAD file, 2026-10-19]
CAD/DXF/sorting_area/RxSide2.dxf
26.0 x 50.0 mm
