Abdo-Pasha/MCT333_Design_of_Mechatronics_Systems_1/CAD/cartesian_robot_workspace/Z Axis/M4 Insert.step

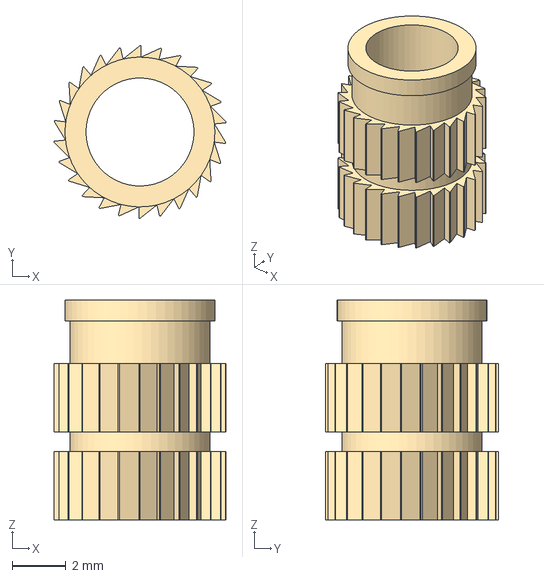
[picture p106: CAD file, 2026-10-13]
CAD/cartesian_robot_workspace/Z Axis/M4 Insert.step
6.36 x 6.40 x 8.15 mm
