Abdo-Pasha/MCT333_Design_of_Mechatronics_Systems_1/CAD/DXF/sorting_area/TxCeiling.dxf

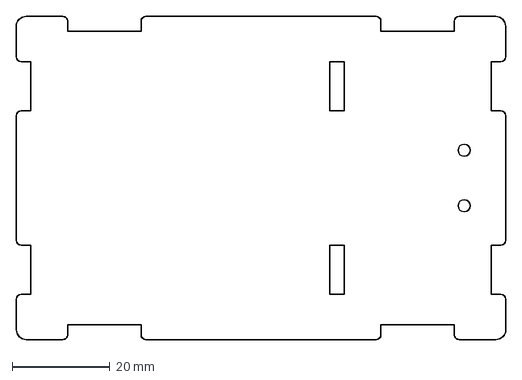
[picture p107: CAD file, 2026-10-19]
CAD/DXF/sorting_area/TxCeiling.dxf
100.0 x 66.0 mm
