Abdo-Pasha/MCT333_Design_of_Mechatronics_Systems_1/CAD/DXF/sorting_area/TxSide2.dxf

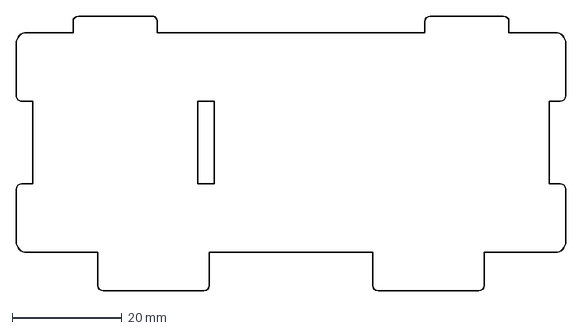
[picture p108: CAD file, 2026-10-19]
CAD/DXF/sorting_area/TxSide2.dxf
100.0 x 50.0 mm
