Abdo-Pasha/MCT333_Design_of_Mechatronics_Systems_1/CAD/DXF/sorting_area/TxFace2.dxf

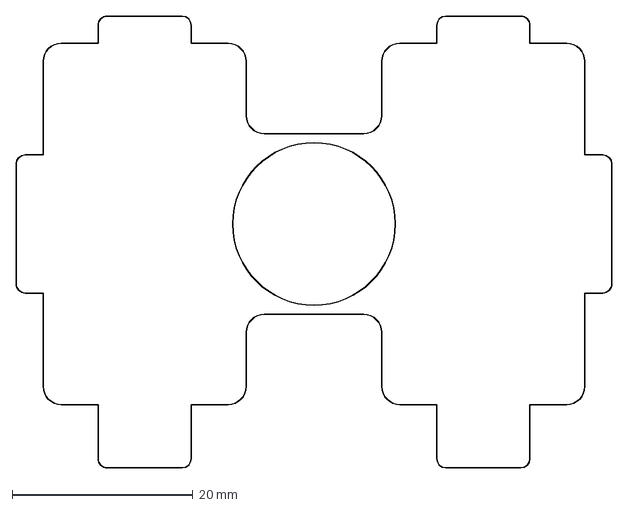
[picture p109: CAD file, 2026-10-19]
CAD/DXF/sorting_area/TxFace2.dxf
66.0 x 50.0 mm
