Abdo-Pasha/MCT333_Design_of_Mechatronics_Systems_1/CAD/DXF/sorting_area/RxSupport.dxf

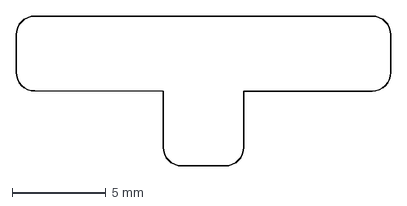
[picture p110: CAD file, 2026-10-19]
CAD/DXF/sorting_area/RxSupport.dxf
20.0 x 8.00 mm
