Abdo-Pasha/MCT333_Design_of_Mechatronics_Systems_1/simscape_multibody_simulation/cad_files/Y_axis.stp

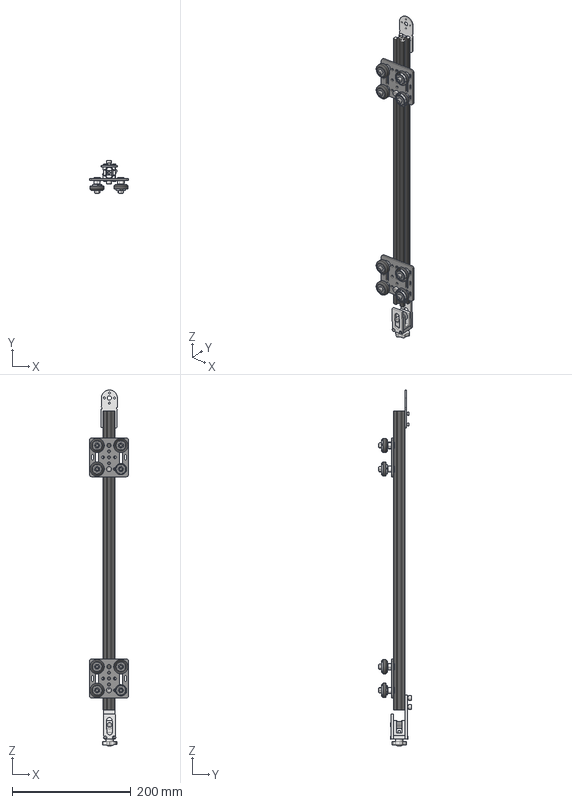
[picture p111: CAD file, 2026-10-14]
simscape_multibody_simulation/cad_files/Y_axis.stp
65.5 x 55.7 x 598.6 mm
20mm Gantry Set x 2
2020aluminum_extrusion_black
2020 Belt Tensioner G_K
ISO 4762 - M5 x 12 x 2
Slider T-Nut for 2020 - M5 x 4
motor holder bracket
Slider T-Nut for 2020 - M3 x 2
ISO 4762 - M3 x 10 x 2
ISO 4762 - M5 x 10 x 2
