Abdo-Pasha/MCT333_Design_of_Mechatronics_Systems_1/(list of files, cad)

Other CAD files:
CAD/electronic_components/1-8-inch-spi-tft-lcd-st7735-128x160/TFT LCD 1.8 inch ST7735.step.SLDASM
simscape_multibody_simulation/cad_files/5v 18mm_1.stp.SLDASM
simscape_multibody_simulation/cad_files/CartesianRobotWorkSpace_1.stp.SLDASM
simscape_multibody_simulation/cad_files/PowerBox_2.stp.SLDASM
simscape_multibody_simulation/cad_files/Assembly7_1.stp.SLDASM
simscape_multibody_simulation/cad_files/PowerBox_1_1.stp.SLDASM
simscape_multibody_simulation/cad_files/BaseBox_1.stp.SLDASM
simscape_multibody_simulation/cad_files/Assembly1_1_1.stp.SLDASM
simscape_multibody_simulation/cad_files/motorShaft Assembly_1.stp.SLDASM
simscape_multibody_simulation/cad_files/PneumaticAirCylinder_1.stp.SLDASM
simscape_multibody_simulation/cad_files/Assem1_3.stp.SLDASM
simscape_multibody_simulation/cad_files/Assembly1_2.stp.SLDASM
simscape_multibody_simulation/cad_files/ControlBox_1.stp.SLDASM
simscape_multibody_simulation/cad_files/Assem1_2.stp.SLDASM
simscape_multibody_simulation/cad_files/Y_Axes_2.stp.SLDASM
simscape_multibody_simulation/cad_files/Suction_1.stp.SLDASM
CAD/cartesian_robot_workspace/Z Axis/AluminumExtrusion/AluminumExtrusion/Extrusion2040/2040extrusion_stp/2040aluminum_extrusion_black.stp
CAD/pnumatic_components/pneumatic_flow_control_valve/FlowControlValve.STEP
simscape_multibody_simulation/simulation/Product 2 Lid.stp_Default_sldprt.STEP
CAD/off_the_shelf_components/standard-servo-motor-black-1.snapshot.7/τοπ.SLDPRT
simscape_multibody_simulation/simulation/Product Lid.stp_Default_sldprt.STEP
simscape_multibody_simulation/simulation/Product Base.stp_Default_sldprt.STEP
CAD/cartesian_robot_workspace/cable-chain-18x37/Unit.STEP
CAD/cartesian_robot_workspace/cable-chain-18x37/MountingHead.STEP
CAD/cartesian_robot_workspace/Z Axis/Product Lid.stl
CAD/cartesian_robot_workspace/Z Axis/Product Base.dwg
simscape_multibody_simulation/cad_files/PowerBoxLengthFace_4.stp.SLDPRT
simscape_multibody_simulation/simulation/Z_axisMultibodyPart_Default_sldprt.STEP
simscape_multibody_simulation/cad_files/PowerBoxLengthFace_3_1.stp.SLDPRT
simscape_multibody_simulation/simulation/FeedingDiscMultibodyPart_Default_sldprt.STEP
simscape_multibody_simulation/cad_files/part5_1.stp.SLDPRT
simscape_multibody_simulation/simulation/EndEffectorMultibodyPart_Default_sldprt.STEP
simscape_multibody_simulation/simulation/Product 2 Base.stp_Default_sldprt.STEP
simscape_multibody_simulation/cad_files/Limit Switch Spacer_1.stp.SLDPRT
simscape_multibody_simulation/cad_files/SK8 Linear Shaft Support, 8mm v4_1.stp.SLDPRT
simscape_multibody_simulation/cad_files/BaseBoxLengthFace_1_1.stp.SLDPRT
simscape_multibody_simulation/cad_files/Linear Guide Rods_1.stp.SLDPRT
simscape_multibody_simulation/cad_files/2020 Belt Tensioner G_K_3.stp.SLDPRT
simscape_multibody_simulation/cad_files/Part25_1.stp.SLDPRT
simscape_multibody_simulation/cad_files/FeedingDisc.stp
simscape_multibody_simulation/cad_files/PneumaticPiston.stp
simscape_multibody_simulation/cad_files/Part1_1_1.stp.SLDPRT
simscape_multibody_simulation/cad_files/Part22_1.stp.SLDPRT
simscape_multibody_simulation/cad_files/2020 corner joining plate_1.stp.SLDPRT
simscape_multibody_simulation/cad_files/Body_2.stp.SLDPRT
simscape_multibody_simulation/cad_files/20mm Gantry Set_2.stp.SLDPRT
simscape_multibody_simulation/cad_files/PowerBoxLengthFace_2_1.stp.SLDPRT
simscape_multibody_simulation/cad_files/ControlBoxWidthFace_1.stp.SLDPRT
simscape_multibody_simulation/cad_files/Z_axis.stp
simscape_multibody_simulation/cad_files/Part67_1.stp.SLDPRT
simscape_multibody_simulation/cad_files/Z Bracket_1.stp.SLDPRT
simscape_multibody_simulation/cad_files/NO_NC Bump Switch_1.stp.SLDPRT
simscape_multibody_simulation/cad_files/M4 Insert_1.stp.SLDPRT
simscape_multibody_simulation/cad_files/2020aluminum_extrusion_black_3.stp.SLDPRT
simscape_multibody_simulation/cad_files/LowerBase_1.stp.SLDPRT
simscape_multibody_simulation/cad_files/UpperBase_1.stp.SLDPRT
simscape_multibody_simulation/cad_files/Part56_1.stp.SLDPRT
simscape_multibody_simulation/cad_files/2020 corner joining plate v1_MIR2_1.stp.SLDPRT
simscape_multibody_simulation/cad_files/Part69_3.stp.SLDPRT
simscape_multibody_simulation/cad_files/KP08 Pillow block bearing 08mm diameter_1.stp.SLDPRT
simscape_multibody_simulation/cad_files/2040aluminum_extrusion_black_1.stp.SLDPRT
simscape_multibody_simulation/cad_files/2020aluminum_extrusion_black_4.stp.SLDPRT
simscape_multibody_simulation/cad_files/Part69_2.stp.SLDPRT
simscape_multibody_simulation/cad_files/PowerBoxWidthFace_2.stp.SLDPRT
simscape_multibody_simulation/cad_files/SHF8_MIR_1.stp.SLDPRT
simscape_multibody_simulation/cad_files/Part23_1.stp.SLDPRT
simscape_multibody_simulation/cad_files/BaseBoxWidthFace_1.stp.SLDPRT
simscape_multibody_simulation/cad_files/StasionaryParts.stp
simscape_multibody_simulation/cad_files/V-Pulley_1.stp.SLDPRT
simscape_multibody_simulation/cad_files/Part2_3.stp.SLDPRT
simscape_multibody_simulation/cad_files/EndEffector.stp
simscape_multibody_simulation/cad_files/motor holder bracket_2.stp.SLDPRT
simscape_multibody_simulation/cad_files/PowerBoxWidthFace_1_1.stp.SLDPRT
simscape_multibody_simulation/cad_files/ControlBoxLengthFace_1.stp.SLDPRT
CAD/FEED and Sorting/Assembly1.iam
CAD/FEED and Sorting/Assembly7.iam
CAD/FEED and Sorting/OldVersions/Assembly1.0004.iam
CAD/FEED and Sorting/OldVersions/Assembly7.0002.iam
CAD/FEED and Sorting/OldVersions/Part1.0004.ipt
CAD/FEED and Sorting/OldVersions/Part2.0004.ipt
CAD/FEED and Sorting/OldVersions/Part22.0002.ipt
CAD/FEED and Sorting/OldVersions/Part23.0001.ipt
CAD/FEED and Sorting/OldVersions/Part24.0001.ipt
CAD/FEED and Sorting/OldVersions/Part25.0002.ipt
CAD/FEED and Sorting/OldVersions/Part27.0002.ipt
CAD/FEED and Sorting/OldVersions/Part3.0002.ipt
CAD/FEED and Sorting/OldVersions/Part56.0002.ipt
CAD/FEED and Sorting/OldVersions/Part57.0001.ipt
CAD/FEED and Sorting/Part1.ipt
CAD/FEED and Sorting/Part14.ipt
CAD/FEED and Sorting/Part2.ipt
CAD/FEED and Sorting/Part22.ipt
CAD/FEED and Sorting/Part23.ipt
CAD/FEED and Sorting/Part24.ipt
CAD/FEED and Sorting/Part25.ipt
CAD/FEED and Sorting/Part27.ipt
CAD/FEED and Sorting/Part3.ipt
CAD/FEED and Sorting/Part56.ipt
CAD/FEED and Sorting/Part57.ipt
CAD/FEED and Sorting/Part67.ipt
CAD/FEED and Sorting/Part69.ipt
CAD/FEED and Sorting/base.ipt
CAD/FEED and Sorting/box/Assembly1.iam
CAD/FEED and Sorting/box/MagazineBox.iam
CAD/FEED and Sorting/box/MagazineBoxBack.ipt
CAD/FEED and Sorting/box/MagazineBoxCeiling.ipt
CAD/FEED and Sorting/box/MagazineBoxFace.ipt
CAD/FEED and Sorting/box/MagazineBoxSide.ipt
CAD/FEED and Sorting/box/OldVersions/Assembly1.0002.iam
CAD/FEED and Sorting/box/OldVersions/Part1.0004.ipt
CAD/FEED and Sorting/box/OldVersions/Part2.0005.ipt
CAD/FEED and Sorting/box/OldVersions/part5.0002.ipt
CAD/FEED and Sorting/box/Part1.ipt
CAD/FEED and Sorting/box/Part2.ipt
CAD/FEED and Sorting/box/Part3.ipt
CAD/FEED and Sorting/box/SlotBack.ipt
CAD/FEED and Sorting/box/SlotCeiling.ipt
CAD/FEED and Sorting/box/SlotSide.ipt
CAD/FEED and Sorting/box/part4.ipt
CAD/FEED and Sorting/box/part5.ipt
CAD/FEED and Sorting/feeding_mechanism/CylinderEndEffector.ipt
CAD/FEED and Sorting/motorShaft Assembly.iam
CAD/FEED and Sorting/sorting_area/Assembly1.iam
CAD/FEED and Sorting/sorting_area/BackFace.ipt
CAD/FEED and Sorting/sorting_area/LaserRxSlot.ipt
CAD/FEED and Sorting/sorting_area/LaserRxSupport.ipt
CAD/FEED and Sorting/sorting_area/RxBack.ipt
CAD/FEED and Sorting/sorting_area/RxCeil.ipt
CAD/FEED and Sorting/sorting_area/RxFace.ipt
CAD/FEED and Sorting/sorting_area/RxSide.ipt
CAD/FEED and Sorting/sorting_area/SecondRxBase.ipt
CAD/FEED and Sorting/sorting_area/SideFace.ipt
CAD/FEED and Sorting/sorting_area/SortingArea.iam
CAD/FEED and Sorting/sorting_area/TransmitterCeil.ipt
CAD/FEED and Sorting/sorting_area/TransmitterFace.ipt
CAD/FEED and Sorting/sorting_area/base.ipt
CAD/FEED and Sorting/sorting_area/productBase.ipt
CAD/FEED and Sorting/sorting_area/productLid.ipt
CAD/Product CAD/Product Base.ipt
CAD/Product CAD/Product Base.stl
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
