Abdo-Pasha/MCT333_Design_of_Mechatronics_Systems_1/simscape_multibody_simulation/simulation/FullAssemblyMultibody_error.txt

Constrained Instances: 'FullAssembly-1', 'LocatingPart-1'
Constraint Name: Lock5
Error Details: Constraint is not supported. The constraint has been exported as unknown constraint.
---------------------------------------------------------------------------------
Constrained Instances: 'FullAssembly-1', 'LocatingPart-1'
Constraint Name: Lock5
Error Details: Constraint geometry is not supported. The constraint geometry has been exported as unknown geometry.
---------------------------------------------------------------------------------
Constrained Instances: 'FullAssembly-1', 'LocatingPart-1'
Constraint Name: Lock5
Error Details: Constraint geometry is not supported. The constraint geometry has been exported as unknown geometry.
---------------------------------------------------------------------------------
Constrained Instances: 'FeedingDiscMultibodyPart-2', 'LocatingPart-2'
Constraint Name: Lock10
Error Details: Constraint is not supported. The constraint has been exported as unknown constraint.
---------------------------------------------------------------------------------
Constrained Instances: 'FeedingDiscMultibodyPart-2', 'LocatingPart-2'
Constraint Name: Lock10
Error Details: Constraint geometry is not supported. The constraint geometry has been exported as unknown geometry.
---------------------------------------------------------------------------------
Constrained Instances: 'FeedingDiscMultibodyPart-2', 'LocatingPart-2'
Constraint Name: Lock10
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
Constrained Instances: 'FullAssembly-1', 'LocatingPart-8'
Constraint Name: Lock7
Error Details: Constraint geometry is not supported. The constraint geometry has been exported as unknown geometry.
---------------------------------------------------------------------------------
Constrained Instances: 'FullAssembly-1', 'LocatingPart-7'
Constraint Name: Lock8
Error Details: Constraint is not supported. The constraint has been exported as unknown constraint.
---------------------------------------------------------------------------------
Constrained Instances: 'FullAssembly-1', 'LocatingPart-7'
Constraint Name: Lock8
Error Details: Constraint geometry is not supported. The constraint geometry has been exported as unknown geometry.
---------------------------------------------------------------------------------
Constrained Instances: 'FullAssembly-1', 'LocatingPart-7'
Constraint Name: Lock8
Error Details: Constraint geometry is not supported. The constraint geometry has been exported as unknown geometry.
---------------------------------------------------------------------------------
Constrained Instances: 'FullAssembly-1', 'LocatingPart-9'
Constraint Name: Lock9
Error Details: Constraint is not supported. The constraint has been exported as unknown constraint.
---------------------------------------------------------------------------------
Constrained Instances: 'FullAssembly-1', 'LocatingPart-9'
Constraint Name: Lock9
Error Details: Constraint geometry is not supported. The constraint geometry has been exported as unknown geometry.
---------------------------------------------------------------------------------
Constrained Instances: 'FullAssembly-1', 'LocatingPart-9'
Constraint Name: Lock9
Error Details: Constraint geometry is not supported. The constraint geometry has been exported as unknown geometry.
---------------------------------------------------------------------------------
