Abdo-Pasha/MCT333_Design_of_Mechatronics_Systems_1/(commit log)

2026-10-10 Added Daniels CAD
    [90headerMale.ipt, Assem1.0004.iam, Assem1.SLDASM, Assem1.iam, Assembly1.0002.iam, Assembly1.0004.iam, Assembly1.iam, Assembly7.0002.iam]
2026-10-11 Update cartesian robot workspace assembly
2026-10-11 Update FEED and Sorting CAD, add full assembly, clean up OldVersions
2026-10-11 CAD changes and Improvments
    Added the bearing and DFM the whole system for it
2026-10-12 CAD changes
2026-10-12 Added Product CAD Files
2026-10-13 Adding the Z-axis and intiating the full assembly
2026-10-13 Some Updates on assemblies
2026-10-13 motor shaft size change and assembly file created
2026-10-13 ADD boxes assemblies: base, power, pneumatic, and control
2026-10-14 Add Pneumatic Cylinder
2026-10-14 Adding CAD Files for Simulation
2026-10-15 Edit Simulation CAD Files
2026-10-16 Adding Limit Switches for the Axises
2026-10-16 Edits on Pneumatic Cylinder
2026-10-18 Mount The New Sorting Area
2026-10-19 Edit Stepper motor Location
2026-10-19 CAD modifications
2026-10-19 CAD modi
2026-10-21 Cylinder Mount
